John-Nagle/Overbot/gc/parts/braking/Pictures/Hardware/assembly4.jpg

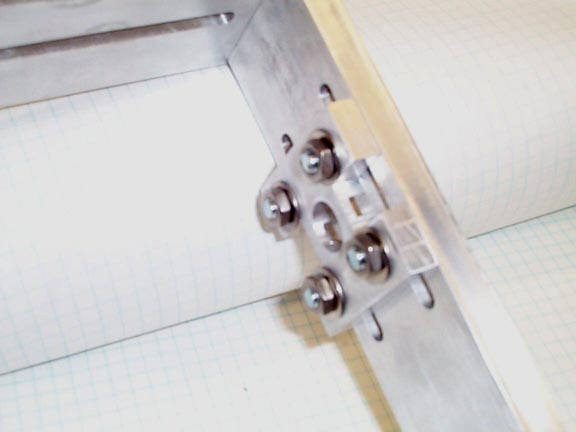
gc/parts/braking/Pictures/Hardware/assembly4.jpg
