John-Nagle/Overbot/gc/parts/braking/Pictures/Mounted/mounted07.jpg

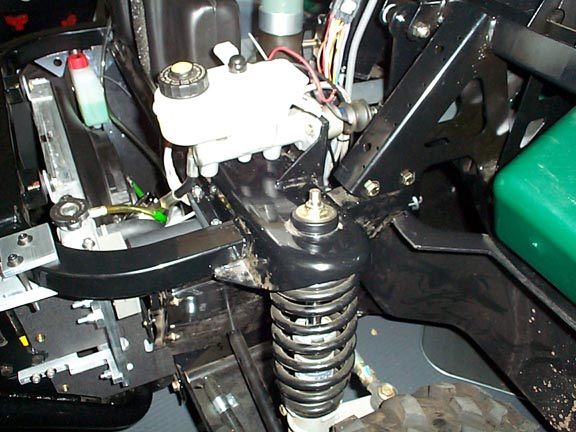
gc/parts/braking/Pictures/Mounted/mounted07.jpg
