John-Nagle/Overbot/README.md

# Overbot
Team Overbot source code from the 2005 Grand Challenge

The code that ran the Team Overbot off-road autonomous vehicle in the 2005 DARPA Grand Challenge.

Of historical interest only at this late date.
