John-Nagle/Overbot/gc/src/qnx/drivers/dummylms/README.txt

Dummy LIDAR server

Simulates a SICK LMS 221 

Teeam Overbot
J. Nagle
April, 2004
