John-Nagle/Overbot/gc/src/qnx/drivers/simplesonar/README.txt

Very simple SONAR server - reports obstacles in front or back of vehicle as faults.
