John-Nagle/Overbot/gc/src/qnx/nav/map/README.txt

The map/steering server

This is the program that does almost all the work of driving the Overbot.
