John-Nagle/Overbot/gc/doc/nav/moveserver.pdf

For participants only. Not for public distribution.

## Note #41 Move Server Design Specification

Achut Reddy
Last revise

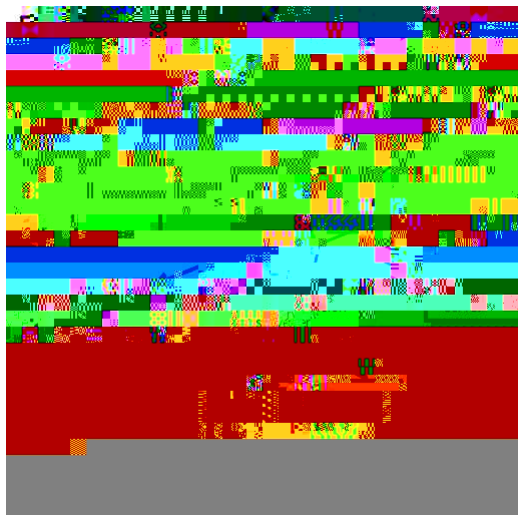
[picture p3: figure]

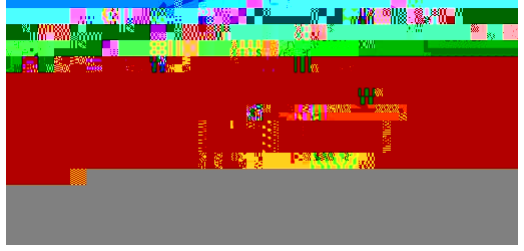
[picture p4: figure]

FIGURE 1 - Move server block diagram

Receive Thread

This thread simply loops waiting for command messages. When a command is received, it sim

The Move server does not issue commands to the Brake and Th | n
