John-Nagle/Overbot/gc/parts/power/powerboxpinout.xls

Team Overbot
Cable/Connector description
By: | J. Nagle
Date: | 2004-02-11
Unit name | Connector | Pin# | Pin description | Wire color | Remarks
Power box
 | Terminal block
 |  | Low voltage section
 |  | 1 | +12 VDC A | BLACK | To computer box
 |  | 2 | -12 VDC A | RED | To computer box
 |  | 3 | +12 VDC B | BLACK | To hood area
 |  | 4 | -12 VDC B | RED | To hood area
 |  | 5 | +24 VDC A | BLACK | To hood area
 |  | 6 | -24 VDC A | RED | To hood area
 |  | 7 | +24 VDC B | BLACK | To hood area
 |  | 8 | -24 VDC B | RED | To hood area
 |  | -------
 |  | 120 VAC unswitched section
 |  | 9 | NEUTRAL | BLACK | 9-10-11 tied together
 |  | 10 | NEUTRAL | BLACK
 |  | 11 | NEUTRAL | BLACK
 |  | 12 | 120 VAC | RED | 12-13-14 tied together
 |  | 13 | 120 VAC | RED
 |  | 14 | 120 VAC | RED
 |  | 15 | GND | GREEN | 15-16-17 tied together
 |  | 16 | GND | GREEN
 |  | 17 | GND | GREEN
 |  | -----
 |  | 120 VAC to 12V supplies |  |  | CHECK VOLTAGE
 |  | 18 |  | BLACK
 |  | 19 |  | RED
 |  | 20 |  | GREEN
 |  | -----
 |  | 120VAC to 24VDC supplies
 |  | 21 |  | BLACK
 |  | 22 |  | RED
 |  | 23 |  | GREEN | 23-24 tied together
 |  | 24 |  | GREEN
 |  | 25 |  | RED | 25-26-26 tied together
 |  | 26 |  | RED | To CB ???
 |  | 27 |  | RED | To CB ???
 |  | -----
 |  | 120VAC to computers – unswitched
 |  | 28 |  | BLACK
 |  | 29 |  | RED
 |  | 30 |  | GREEN
 | SW1 – SPDT momentary |  |  |  | Generator start/stop
 |  |  |  |  | NOT CURRENTLY CONNECTED
 | SW2 – DPDT |  |  |  | 120VAC to computers
 |  |  |  |  | NOT CURRENTLY CONNECTED
 | SW2 – SPDT momentary | DPDT |  |  | 12VDC supplies
 | SW3 – DPDT |  |  |  | 24VDC supplies
 | PL1 – 120VAC receptacle |  |  |  | Utility outlet
 |  |  |  |  | NOT CURRENTLY CONNECTED
 | Computer box connector – AMP 9-pin female |  |  |  | UNDER CONTSTRUCTION
 |  | 1 | AC GND |  | GREEN
 |  | 2 | 120 VAC NEUTRAL |  | BLACK
 |  | 3 | 120 VAC AC HOT |  | RED
 |  | 7 | 12VDC GND |  | BLACK
 |  | 8 | +12 VDC |  | RED
