John-Nagle/Overbot/gc/parts/templates/pinout.xls

Team Overbot
Cable/Connector description
By:
Date:
Unit name | Connector | Connector type | Pin number | Pin name | Pin description | Wire color | Remarks
LED Sign
 | Serial | RJ-11, female
 |  |  | Standard serial |  |  |  | 9600 baud
 | Power | 6mm coax power
 |  |  | Shell | GND
 |  |  | Pin number | PWR |  |  | 7.5V, 3A
