John-Nagle/Overbot/gc/parts/throttle/eserpinouts.xls

Pinouts For Throttle, RPM sensor, Dicky John
Questions? E-mail eser@cs.stanford.edu
Sensor Port Pin-Outs:
Pin# | Color | Function
1 | black | driveshaft sensor GND
2 | red | driveshaft sensor VCC
3 | white | driveshaft sensor Channel A
4 | green | driveshaft sensor Channel B
5 | shield | driveshaft sensor cable shield
6 | black | dicky john GND
7 | red | dicky john +12 VDC
8 | green | dicky john signal out 0-12VDC
9 | brown | RPM sensor +V
10 | black | RPM SIG
11 | blue | RPM COM
Throttle Power/E-Stop Cable: |  | REMOVED – obsolete with Galil
Pin# | Color | Function
1 | red (wire#1) | +24V
2 | black (wire#1) | -24V
3 | shield(wire#1) | shield
4 | gray (wire#1) | NC
5 | red (wire#1) | solenoid
6 | black(red) | solenoid
7 | DIO green signal | DIO signal
8 | DIO GND black-green | DIO GND
9 | white | NC
10 | black-white | NC
11 | shield(wire#1) | shield
Power Cable Pin-Out:
Pin# | Color | Function
1 | Red-Brown | VCC
2 | black-blue | GND
Sensor Port Pin-Outs (user-side):
Pin# | Color | Function
1 | black | driveshaft sensor GND
2 | red | driveshaft sensor VCC
3 | white | driveshaft sensor Channel A
4 | green | driveshaft sensor Channel B
5 | blue | driveshaft sensor cable shield
6 | orange | dicky john GND
7 | red-white | dicky john +12 VDC
8 | green-white | dicky john signal out 0-12VDC
9 | red-black | RPM sensor +V
10 | blue-white | RPM SIG
11 | black-white | RPM COM
Thorttle Box Pin-Out: |  | REMOVED – obsolete with Galil
Pin# | Color | Function
1 | orange | solenoid
2 | green | solenoid
3 | red | servo VCC
4 | black | servo GND
5 | white | Forward limit switch
6 | blue | center limit switch
7 | orange-black | back limit switch
8 | blue-black | encoder Channel B
9 | red-black | encoder VCC
10 | white-black | encoder Channel A
11 | green-black | Encoder Channel I
12 | black-white | encoder GND
13 | shield | shield
14
Throttle SerialCable: |  | REMOVED – obsolete with Galil
Pin# | Color (Device side) | Color (user side) | Function
1 | green | white | RxD/RS485-
2 | black-green | black | TxD/RS485+
3 | red | red | NC
4 | black-red | - | NC
5 | white | - | NC
6 | black-white | - | NC
7 | shield | shield | GND
MVP's: |  | REMOVED – obsolete with Galil
Pin# |  | Function
1 |  | Estop #6
2 |  | Estop #5
3 |  | MVP Phase A (J6)
4 |  | MVP Phase B (J6)
5 |  | MVP J2 Pin #8 (external event #1)
6 |  | MVP J2 Pin #16 (GND)
7 |  | MVP J2 Pin #7 (external event #2)
8-12 |  | J3 (encoder)
