John-Nagle/Overbot/gc/data/ahrsproblems/hdgshopgpsins.bmp

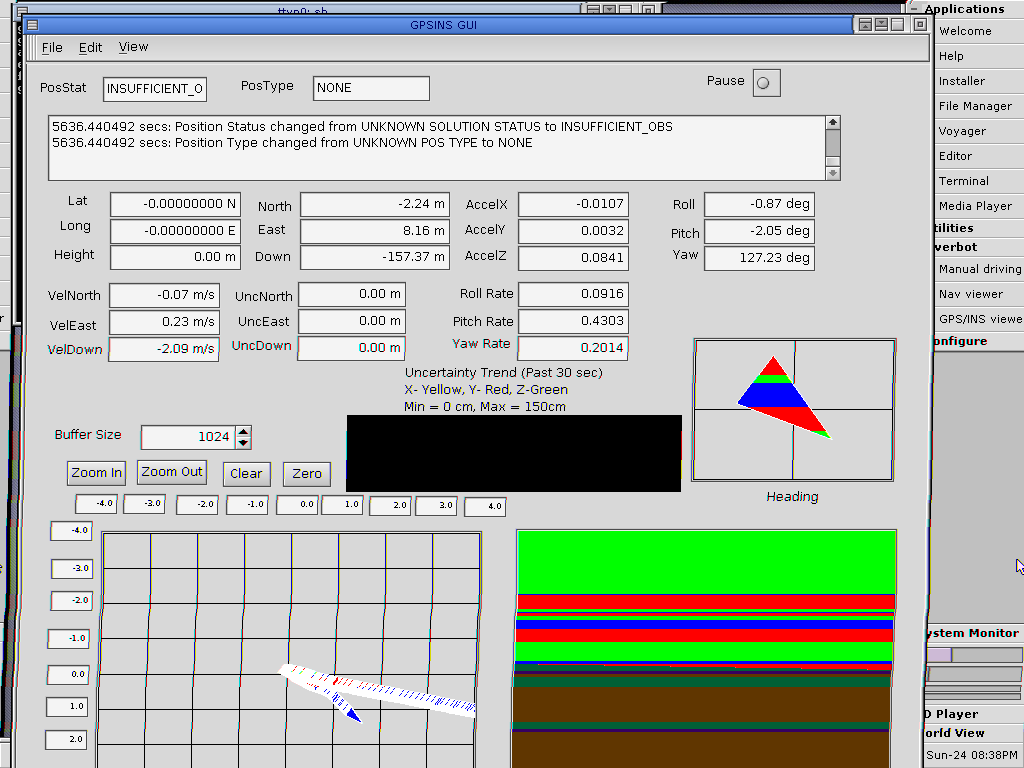
gc/data/ahrsproblems/hdgshopgpsins.bmp
