John-Nagle/Overbot/gc/data/ahrsproblems/hdgshopgyroview.bmp

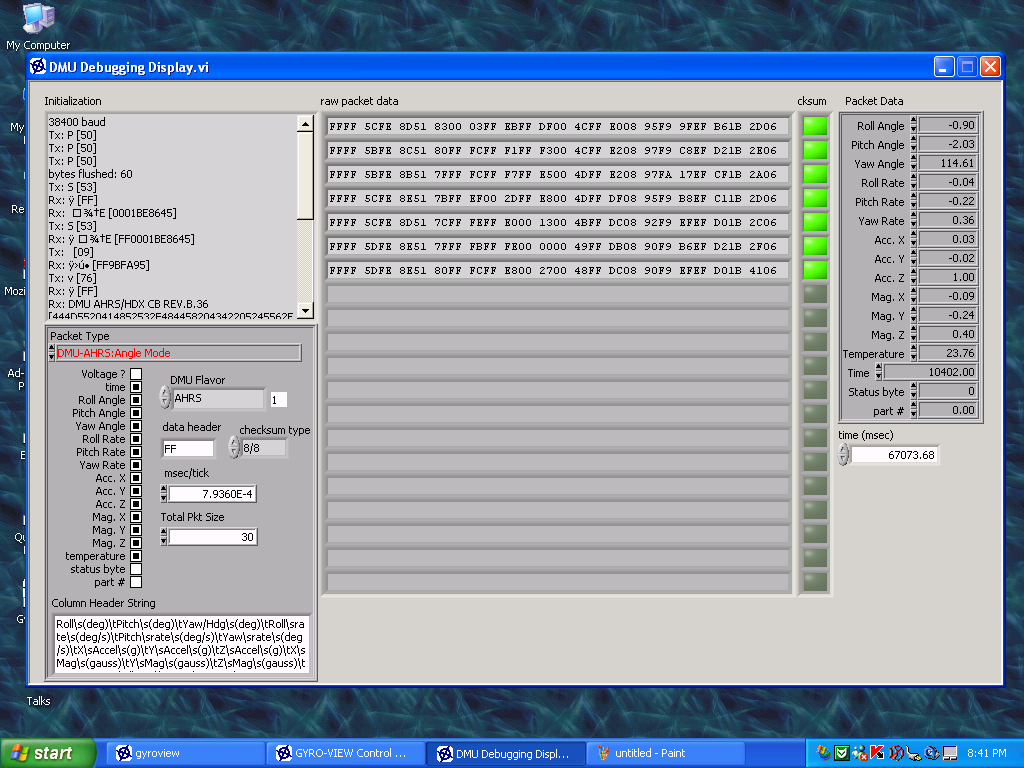
gc/data/ahrsproblems/hdgshopgyroview.bmp
