John-Nagle/Overbot/gc/data/redwoodjunction/redwoodjunctionsmallyard.jpg

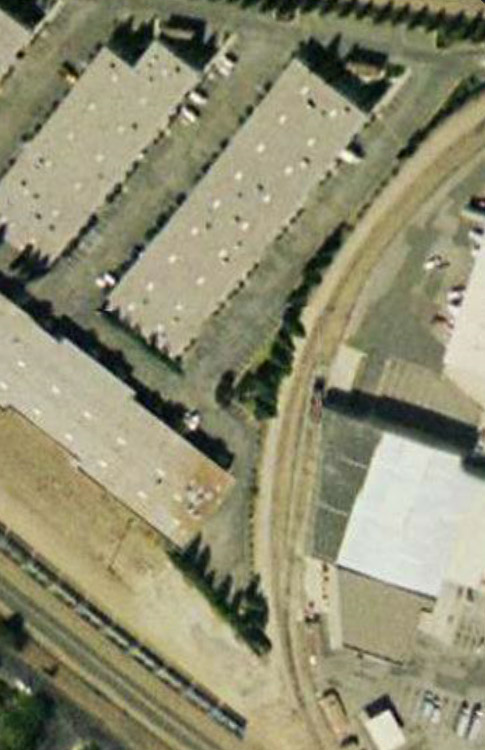
gc/data/redwoodjunction/redwoodjunctionsmallyard.jpg
