John-Nagle/Overbot/gc/doc/nav/lidarstabilization1.gif

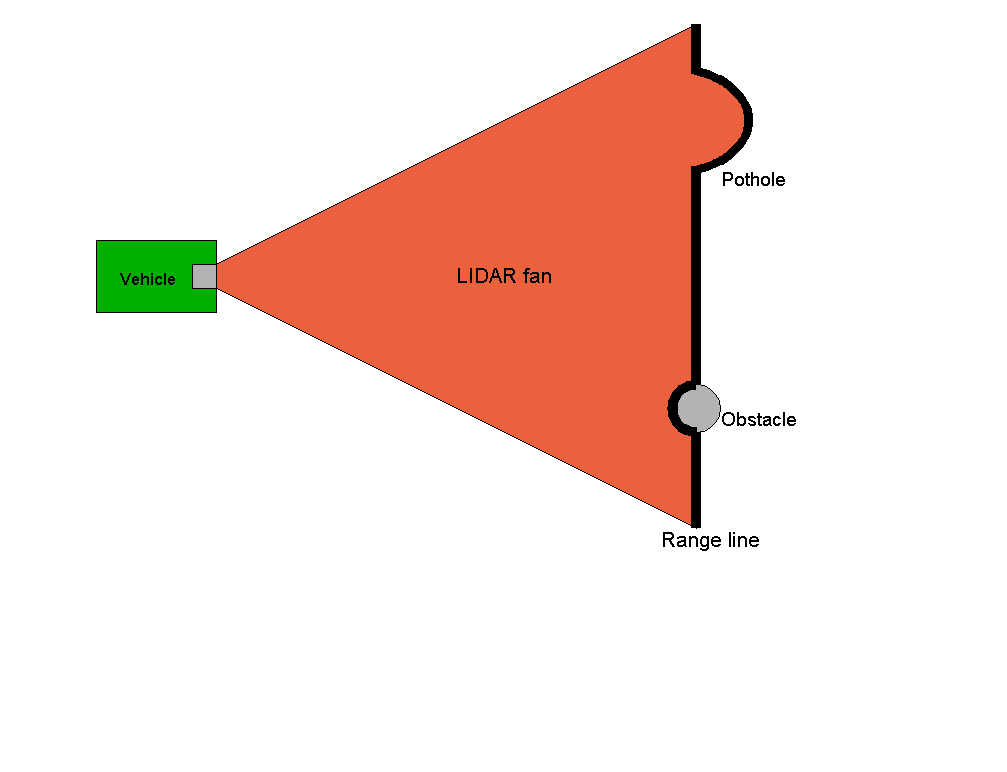
gc/doc/nav/lidarstabilization1.gif
