John-Nagle/Overbot/gc/doc/nav/lidarstabilizationgeom.gif

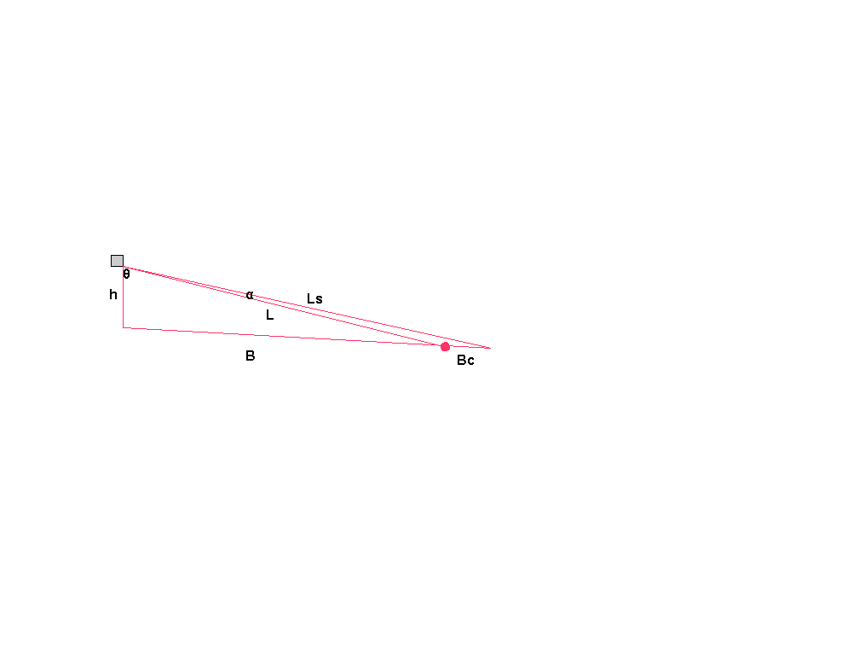
gc/doc/nav/lidarstabilizationgeom.gif
