John-Nagle/Overbot/gc/doc/nav/newsteerdesign.gif

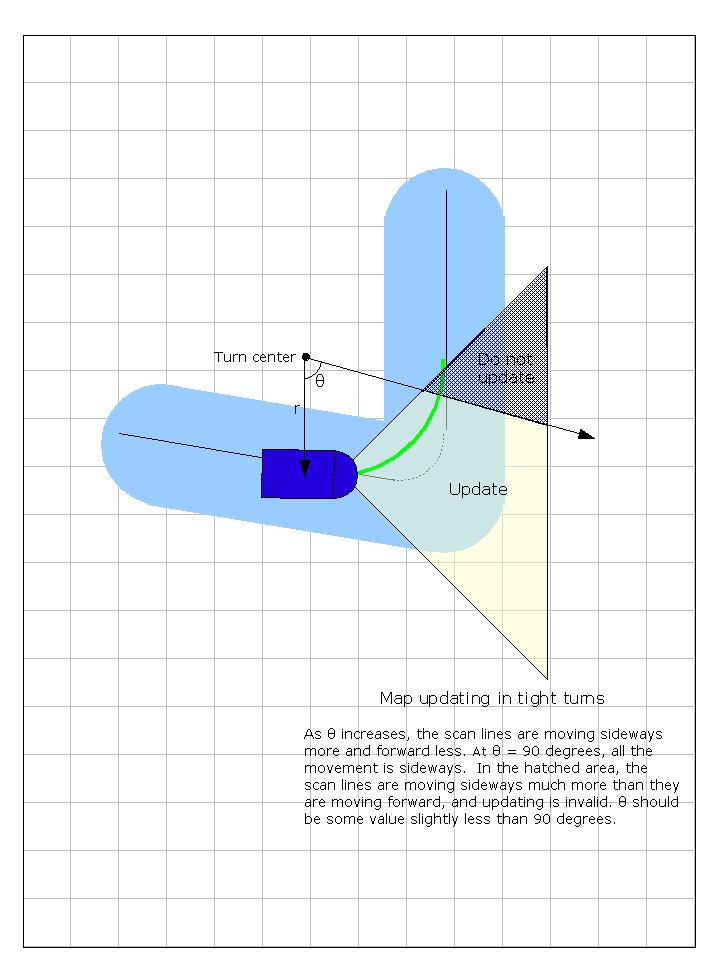
gc/doc/nav/newsteerdesign.gif
