John-Nagle/Overbot/gc/doc/nav/novatelserialnumberplate.jpg

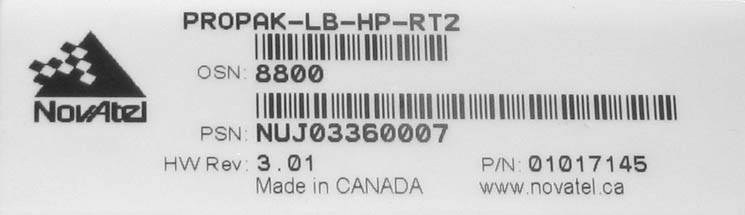
gc/doc/nav/novatelserialnumberplate.jpg
