John-Nagle/Overbot/gc/doc/presentations/cmugimbal.jpg

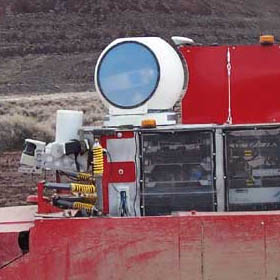
gc/doc/presentations/cmugimbal.jpg
