John-Nagle/Overbot/gc/parts/braking/Pictures/Hardware/Bracket_Cap.jpg

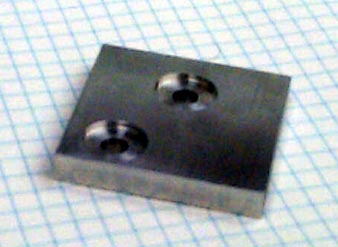
gc/parts/braking/Pictures/Hardware/Bracket_Cap.jpg
