John-Nagle/Overbot/gc/parts/braking/Pictures/Hardware/Bracket_Main.jpg

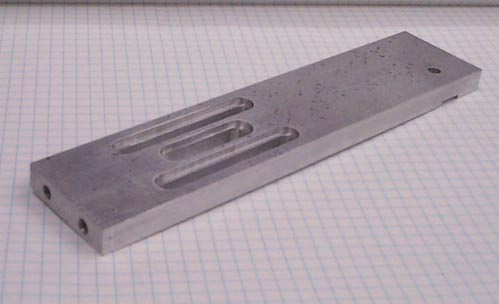
gc/parts/braking/Pictures/Hardware/Bracket_Main.jpg
