John-Nagle/Overbot/gc/parts/braking/Pictures/Hardware/Bracket_Slide.jpg

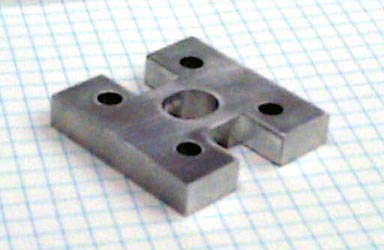
gc/parts/braking/Pictures/Hardware/Bracket_Slide.jpg
