John-Nagle/Overbot/gc/parts/braking/Pictures/Hardware/Bracket_Support.jpg

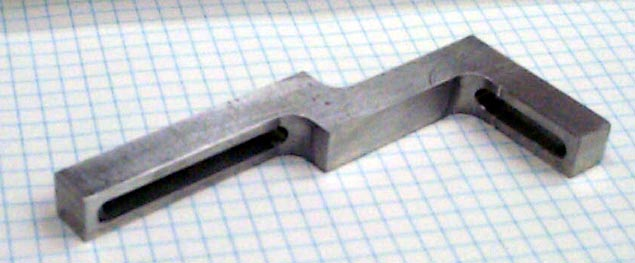
gc/parts/braking/Pictures/Hardware/Bracket_Support.jpg
