John-Nagle/Overbot/gc/parts/braking/Pictures/Hardware/Bracket_Top.jpg

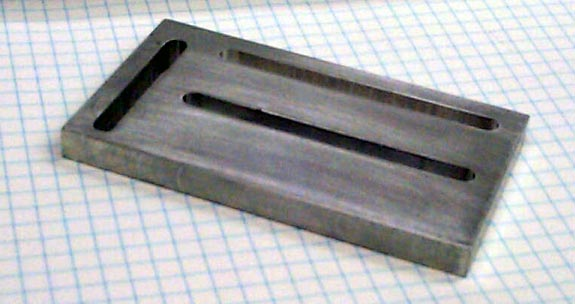
gc/parts/braking/Pictures/Hardware/Bracket_Top.jpg
