John-Nagle/Overbot/gc/src/qnx/common/doc/opencv/ref/pics/left.jpg

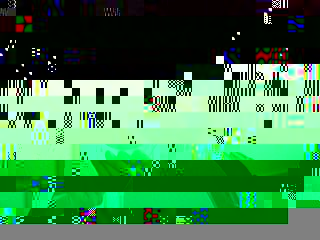
gc/src/qnx/common/doc/opencv/ref/pics/left.jpg
