John-Nagle/Overbot/gc/src/qnx/common/doc/opencv/ref/pics/right.jpg

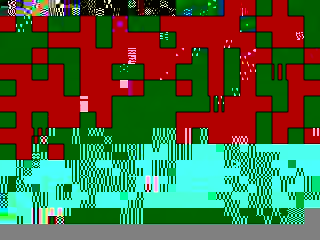
gc/src/qnx/common/doc/opencv/ref/pics/right.jpg
