John-Nagle/Overbot/gc/system/milestones/lowlevelclientserver.tif

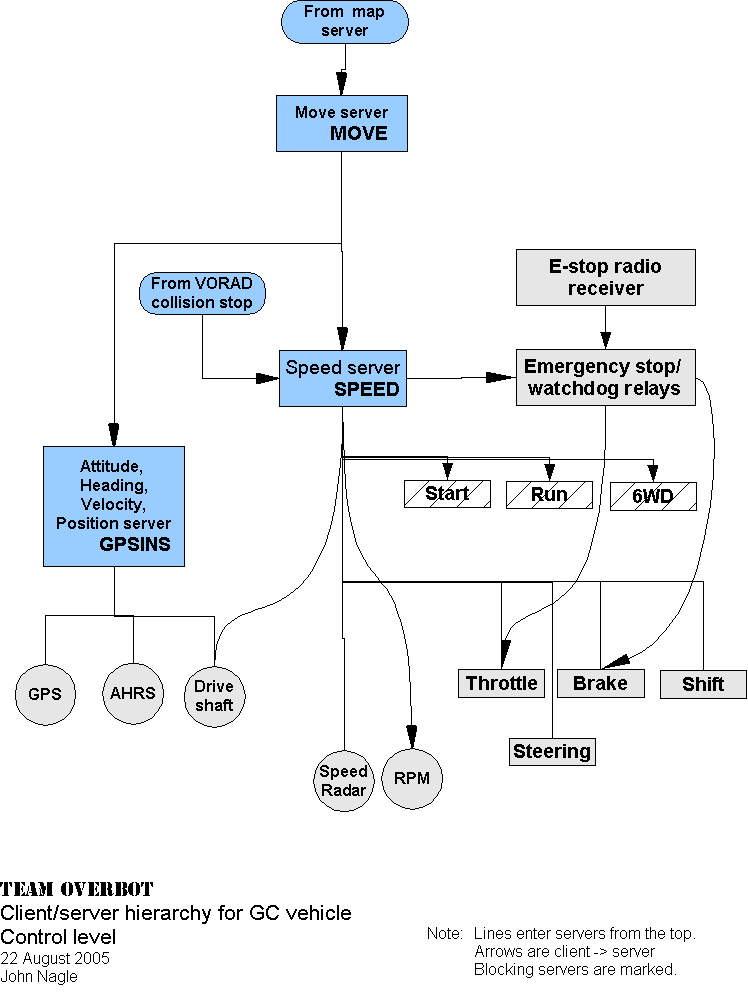
gc/system/milestones/lowlevelclientserver.tif
