John-Nagle/Overbot/gc/system/milestones/sensorsclientserver.tif

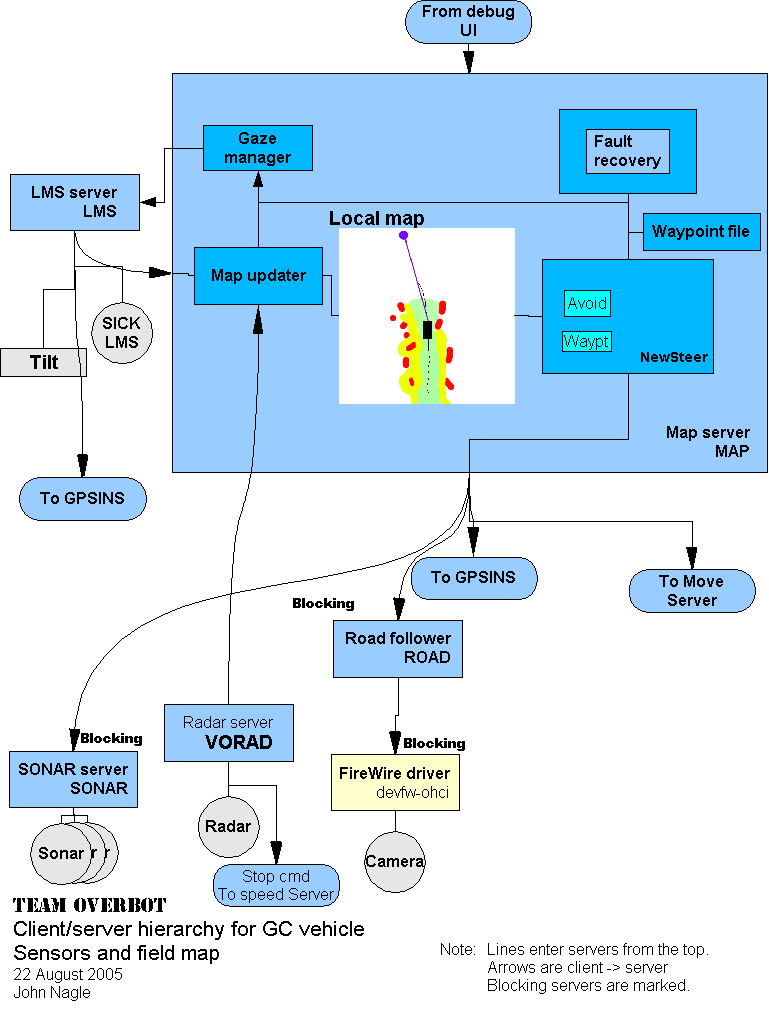
gc/system/milestones/sensorsclientserver.tif
