John-Nagle/Overbot/gc/system/boms/bom.xls

Sheet: master
Team Overbot
Vehicle Bill Of Materials (BOM)
Resp | Subsys |  | Item Name | Vendor and Model Number | In House? |  | Type | Electronic Interface | AI | AO | DI | CT | DO | R | Q | S | NA | 1 | Power | Location | Water
 | Chassis
 | Base Vehicle
John N |  |  | Vehicle, Off-Road | Polaris Ranger 6x6 2003 | yes
 |  |  | Add-On, Standard, Brush Guard, Front | Polaris Ranger Front Brush Guard | yes
Nagle |  |  | Add-On, Custom, Sponsor Decals | Kinko's | yes |  | Aluminum signs
Celia |  |  | Modification, Steering Shaft, Upper | Polaris Ranger Upper Steering Shaft | yes
Celia |  |  | Modification, Steering Shaft, Lower | Polaris Ranger Lower Steering Shaft | yes
 |  |  | Modification, Tire, Right, Front, Foam Filler |  | cancel
 |  |  | Modification, Tire, Right, Middle, Foam Filler |  | cancel
 |  |  | Modification, Tire, Right, Rear, Foam Filler |  | cancel
 |  |  | Modification, Tire, Left, Front, Foam Filler |  | cancel
 |  |  | Modification, Tire, Left, Middle, Foam Filler |  | cancel
 |  |  | Modification, Tire, Left, Rear, Foam Filler |  | cancel
 | Vehicle Actuation
 |  | Steering Shaft
Celia |  |  | Sensor, Potentiometer, Steering Shaft | Duncan Technologies Steering Position Sensor | yes | S | Angular Pot? | Analog In | 1 | 0 | 0 | 0 | 0 | 0 | 0 | 0 | 0 | 1
Celia |  |  | Cable, Steering Shaft, Pot to Controller |  | no
Vic |  |  | Hardware, Mounting, Potentiometer, Steering Shaft |  | yes
Celia |  |  | Sensor, Encoder, Steering Shaft | Faulhaber HEDS 5540 AM | yes | S | Inc Encoder | Quadrature | 0 | 0 | 0 | 0 | 0 | 0 | 1 | 0 | 0 | 1
 |  |  | Connector, cable to Encoder | FCI 86498-000 | no |  | Header conn w/latch
Celia |  |  | Cable, Steering Shaft, Encoder to Controller |  | no
Celia |  |  | Actuator, Motor, Steering Shaft | Maxon Motor F 2260-881-51.216.200 | yes | A | DC Brush | Analog Out | 0 | 1 | 0 | 0 | 0 | 0 | 0 | 0 | 0 | 1
Celia |  |  | Cable, Steering Shaft, Motor to Controller |  | no
Celia |  |  | Gearhead, Steering Shaft | Maxon Motor GP 62 | yes
Celia |  |  | Coupler, Motor to Steering Shaft |  | yes
Celia |  |  | Hardware, Mounting, Motor, Steering Shaft | Custom | yes
Celia |  |  | Motion Controller, Steering Shaft | Galil DMC-1416 | yes
Celia |  |  | Cable, Steering Shaft, Controller to Ethernet hub | Fry's | yes
Celia |  |  | Cable, Steering Shaft, Controller to Generator
Celia |  |  | Hardware, Mounting, Motion Controller, Steering Shaft
 |  | Throttle
Eser |  |  | Sensor, Encoder, Throttle |  | yes | S | Inc Encoder | Quadrature | 0 | 0 | 0 | 0 | 0 | 0 | 1 | 0 | 0 | 1
Eser |  |  | Cable, Throttle, Encoder to Controller |  | yes
Eser |  |  | Sensor, Tachometer, Engine Speed | Monarch Instrument 6180-019 | yes | S | Tachometer | DI Counter/Timer | 0 | 0 | 0 | 1 | 0 | 0 | 0 | 0 | 0 | 1
Eser |  |  | Cable, Engine Speed, Tachometer to Freq. Conv |  | no
Eser |  |  | Coupler, Tachometer to Engine |  | yes
Eser |  |  | Hardware, Mounting, Engine Speed, Tachometer |  | yes
 |  |  | Sensor, Encoder, Driveshaft Split Gear | Red Lion 0920750 | yes
Eser |  |  | Sensor, Encoder, Driveshaft Speed (slow/dir) | Sensor Solutions S18-37ADQ-RESA10-10 | yes | S | Inc Encoder | Quadrature | 0 | 0 | 0 | 0 | 0 | 0 | 1 | 0 | 0 | 1
Eser |  |  | Cable, Driveshaft Speed, Encoder to Controller |  | yes
Eser |  |  | Coupler, Encoder to Driveshaft |  | yes
John N |  |  | Sensor, Radar, Vehicle Speed | Dickey-John | yes | S | Doppler Radar | DI Counter/Timer | 0 | 0 | 0 | 1 | 0 | 0 | 0 | 0 | 0 | 1
John N |  |  | Cable, Vehicle Speed, Radar to Freq. Conv |  | yes
John N |  |  | Hardware, Mounting, Radar, Vehicle Speed |  | yes
Eser |  |  | Sensor, Temperature, Water | Use existing water temp switch? | no | S | Temp Sensor | Analog In | 1 | 0 | 0 | 0 | 0 | 0 | 0 | 0 | 0 | 1
Eser |  |  | Cable, Water Temperature to Controller | Need branch from existing wiring. | no
Eser |  |  | Hardware, Mounting, Temperature, Water
Eser |  |  | Actuator, Motor, Throttle | Faulhaber 2342S024CR+HEDS5540I06+X0703A | yes | A | DC Brush | Analog Out | 0 | 1 | 0 | 0 | 0 | 0 | 0 | 0 | 0 | 1
Eser |  |  | Cable, Throttle, Motor to Controller |  | no
Eser |  |  | Gearhead, Throttle | necessary? | yes
Eser |  |  | Hardware, Mounting, Motor, Throttle |  | yes
Eser |  |  | Motion Controller, Throttle | Galil DMC-1416 | yes
Nagle |  |  | Connector, motor and power to motion controller | Phoenix MSTB 2.5 ???
Eser |  |  | Cable, Throttle, Controller to Ethernet hub | Fry's | yes
Eser |  |  | Cable, Throttle, Controller to Engine |  | yes
Eser |  |  | Hardware, Mounting, Motion Controller, Throttle |  | yes
 |  | Brake
Peter |  |  | Sensor, Pressure, Brake | SenZors PT1H, 2000 PSI, 0..5V out | yes | S | Pressure Sensor | Analog In | 1 | 0 | 0 | 0 | 0 | 0 | 0 | 0 | 0 | 1
Peter |  |  | Cable, Brake, Pressure to Controller
Peter |  |  | Sensor, Encoder, Brake |  | yes | S | Encoder | Quadrature
Peter |  |  | Cable, Brake, Encoder to Controller
Peter |  |  | Actuator, Linear, Brake | Ultramotion “Bug”, high-power | yes | A | Linear Actuator | Analog Out | 0 | 1 | 0 | 0 | 0 | 0 | 0 | 0 | 0 | 1
Peter |  |  | Cable, Brake, Linear Actuator to Controller |  | yes
Peter |  |  | Coupler, Brake, Linear Actuator to Master Cylinder |  | yes
Peter |  |  | Hardware, Mounting, Actuator, Linear, Brake |  | yes
Peter |  |  | Motion Controller, Brake | Galil DMC-1416 | yes
Peter |  |  | Cable, Brake, Controller to network | 100baseT | yes
Peter |  |  | Cable, Brake, Controller to Generator |  | yes
Peter |  |  | Hardware, Mounting, Motion Controller, Brake |  | yes
 |  | Transmission (need manual neutral=>brake off)
Chris/Sam |  |  | Sensor, Potentiometer, Transmission |  |  | S | Linear Pot? | Analog In | 1 | 0 | 0 | 0 | 0 | 0 | 0 | 0 | 0 | 1
Chris/Sam |  |  | Cable, Transmission, Pot to Controller
Chris/Sam |  |  | Sensor, Encoder, Transmission |  |  | S | Inc Encoder | Quadrature
Chris/Sam |  |  | Cable, Transmission, Encoder to Controller
Chris/Sam |  |  | Actuator, Linear, Transmission |  |  | A | Linear Actuator? | Analog Out | 0 | 1 | 0 | 0 | 0 | 0 | 0 | 0 | 0 | 1
Chris/Sam |  |  | Cable, Transmission, Linear Actuator to Controller
Chris/Sam |  |  | Coupler, Transmision, Linear Actuator to Lever
Chris/Sam |  |  | Hardware, Mounting, Actuator, Linear, Transmission
Chris/Sam |  |  | Motion Controller, Transmission | Galil DMC-1416 | yes
Chris/Sam |  |  | Cable, Transmission, Controller to network | 100baseT
Chris/Sam |  |  | Cable, Transmission, Controller to Generator
Chris/Sam |  |  | Hardware, Mounting, Motion Controller, Transmission
 |  | Choke
Eser |  |  | Actuator, Solenoid, Choke |  |  | A | Solenoid | Relay | 0 | 0 | 0 | 0 | 0 | 1 | 0 | 0 | 0 | 1
Eser |  |  | Cable, Choke, Solenoid to PC104
Eser |  |  | Coupler, Choke, Solenoid to Lever
Eser |  |  | Hardware, Mounting, Solenoid, Choke
 |  | AWD
Eser |  |  | Relay, AWD |  |  | A | Relay | Relay | 0 | 0 | 0 | 0 | 0 | 1 | 0 | 0 | 0 | 1
Eser |  |  | Cable, AWD, Relay to PC104
Eser |  |  | Hardware, Mounting, Relay, AWD
 |  | Engine Start
Eser |  |  | Relay, Ignition |  |  | A | Relay | Relay | 0 | 0 | 0 | 0 | 0 | 1 | 0 | 0 | 0 | 1
Eser |  |  | Cable, Ignition, Relay to PC104
Eser |  |  | Hardware, Mounting, Relay, Ignition
Eser |  |  | Relay, Starter |  |  | A | Relay | Relay | 0 | 0 | 0 | 0 | 0 | 1 | 0 | 0 | 0 | 1
Eser |  |  | Cable, Starter, Relay to PC104
Eser |  |  | Hardware, Mounting, Relay, Starter
 | Safety/E-Stop
 |  | Lights
 |  |  | Relay, Warning Lights |  |  | A | Relay | Relay | 0 | 0 | 0 | 0 | 0 | 1 | 0 | 0 | 0 | 1
 |  |  | Cable, Warning Lights, Relay to Right
 |  |  | Cable, Warning Lights, Relay to PC104
 |  |  | Hardware, Mounting, Relay, Warning Lights
 |  |  | Light, Warning, Right |  | yes
 |  |  | Hardware, Mounting, Warning, Right
 |  |  | Light, Warning, Left |  | yes
 |  |  | Hardware, Mounting, Warning, Left
 |  |  | Cable, Warning Lights, Right to Left
 |  |  | Relay, Brake Lights |  |  | A | Relay | Relay | 0 | 0 | 0 | 0 | 0 | 1 | 0 | 0 | 0 | 1
 |  |  | Cable, Brake Lights, Relay to Lights
 |  |  | Cable, Brake Lights, Relay to PC104
 |  |  | Hardware, Mounting, Relay, Brake Lights
 |  | Audible Signal |  | Merged Top Unit
 |  |  | Relay, Horn |  |  | A | Relay | Relay | 0 | 0 | 0 | 0 | 0 | 1 | 0 | 0 | 0 | 1
 |  |  | Cable, Horn, Relay to Horn
 |  |  | Cable, Horn, Relay to PC104
 |  |  | Hardware, Mounting, Relay, Horn
 |  |  | Horn
 |  |  | Hardware, Mounting, Horn
 |  | Brakes Engaged
Peter |  |  | Sensor, Switch, Brakes Engaged |  |  | A | Switch | Switch | 0 | 0 | 0 | 0 | 0 | 0 | 0 | 0 | 1 | 1
Peter |  |  | Cable, Brakes Engaged, Switch to Relay
Peter |  |  | Relay, Brakes Engaged, Power Off
Peter |  |  | Cable, Brakes Engaged, Relay to Controller
Peter |  |  | Battery, Brakes Engaged
Peter |  |  | Cable, Brakes Engaged, Battery to Switch
 |  | E-Stop Command
 |  |  | Freeze Input |  |  | S | Switch/Wi-Receiver | Digital In | 0 | 0 | 1 | 0 | 0 | 0 | 0 | 0 | 0 | 1
 |  |  | Kill Input |  |  | S | Switch/Wi-Receiver | Digital In | 0 | 0 | 1 | 0 | 0 | 0 | 0 | 0 | 0 | 1
 |  |  | E-Stop Output Relay |  |  | A | Relay | Relay | 0 | 0 | 0 | 0 | 0 | 1 | 0 | 0 | 0 | 1
 |  |  | Radio E-stop unit, test
 |  |  | Radio E-stop unit, Government-provided
 |  |  | Emergency stop buttons | Allen-Bradley | yes
 |  | Chassis power control
 |  |  | Self-resetting circuit breakers | Waytek? | yes
 |  |  | Dashboard circuit breaker panel
 |  | Manual control panel
 |  |  | Panel | Front Panel Express?
 |  |  | Emergency stop button | Allen-Bradley | yes
 |  |  | Brake switch – RELEASE/NORMAL/APPLY | Telemechanique / Grainger? | yes
 |  |  | Mode switch – MANUAL/STANDBY/AUTO | Telemechanique / Grainger? | yes
 |  |  | Light – AUTO | Telemechanique / Grainger? | yes
 | Auxillary Power
 |  | Generator
Celia |  |  | Generator | Generac Impact 36G Plus II | yes
Celia |  |  | (all the plumbing) |  | yes
Celia |  |  | Hardware, Mounting, Generator |  | yes
 |  |  | (battery to assist generator start?) |  | yes
 |  |  | Generator auto-start control unit | (postponed, no time)
 |  |  | Power distribution/circuit breaker box |  | yes
 |  |  | Plug retention for power plugs |  | yes
 |  |  | Converter, 120VAC to 12/24VDC | Vicor? | yes
 |  | Auxillary Fuel Tank
Celia |  |  | Tank, Fuel, Auxillary | The Tech Group | yes
Celia |  |  | (all the pumbing) | The Tech Group | yes
Celia |  |  | Hardware, Mounting, Tank, Fuel, Auxillary | The Tech Group | yes
 | Debugging
 |  | Steering Wheel
Celia |  |  | Sensor, Potentiometer, Steering Wheel |  | yes | S | Angular Pot? | Analog In | 1 | 0 | 0 | 0 | 0 | 0 | 0 | 0 | 0 | 1
Celia |  |  | Cable, Steering Wheel, Pot to Controller |  | yes
Celia |  |  | Hardware, Mounting, Potentiometer, Steering Wheel |  | yes
 |  | Joystick
Celia |  |  | Joystick, USB
Celia |  |  | Computer, Laptop
Celia |  |  | Software, Operating System, QNX
Celia |  |  | Software, Custom, Joystick Control
Celia |  |  | Bridge, Wireless, Laptop
Celia |  |  | Cable, Ethernet, Laptop to Bridge
Celia |  |  | Bridge, Wireless, Router
 |  | Status
 |  |  | Display, LED, Status |  |  | A | Single Line Display | Serial <=115kB | 0 | 0 | 0 | 0 | 0 | 0 | 0 | 1 | 0 | 1
 |  |  | Cable, Status, LED to PC104 |  |  |  |  | totals | 5 | 4 | 2 | 2 | 0 | 8 | 3 | 1 | 1 | 26
 |  |  | Hardware, Mounting, LED, Status
 | Chassis Computer
Celia |  |  | PC104 Board, Power Supply
Celia |  |  | Cable, Power Supply to Generator
Celia |  |  | PC104 Board, CPU
Celia |  |  | DiskOnChip
Celia |  |  | Software, Operating System, QNX
All |  |  | Software, Custom, Chassis
Celia |  |  | Cable, Ethernet, Chassis to Hub
 |  |  | PC104 Board, Digital In/Out, Counter/Timer
 |  |  | PC104 Board, Relay
 |  |  | Cable, Relay to Generator
Celia |  |  | Enclosure, PC104
Celia |  |  | End Cap, Enclosure, PC104, Top
Celia |  |  | Gasket, Enclosure, PC104, Top
Celia |  |  | End Cap, Enclosure, PC104, Bottom
Celia |  |  | Gasket, Enclosure, PC104, Bottom
Celia |  |  | Hardware, Mounting, Enclosure, PC104, Chassis
 | Auxillary Sensors
 | Proximity Sensing
 |  |  | Sensor, Radar, Forward Obstacles |  |  | S | Eaton VORAD | Serial <= 115kB
 |  |  | Cable, Forward Obstacles, Radar to PC104
 |  |  | Hardware, Mounting, Radar, Forward Obstacles
 |  |  | Sonars 1..N INIT |  |  | A | Sonar Sensor | Digital Out | piezoelectric automotive type
 |  |  | Sonars 1..N ECHO |  |  | S | Sonar Sensor | Timer
 |  |  | Sonars 1..N INIT |  |  | A | Sonar Sensor | Digital Out
 |  |  | Sonars 1..N ECHO |  |  | S | Sonar Sensor | Timer
 |  |  | Sonars 1..N INIT |  |  | A | Sonar Sensor | Digital Out
 |  |  | Sonars 1..N ECHO |  |  | S | Sonar Sensor | Timer
 |  |  | Sonars 1..N INIT |  |  | A | Sonar Sensor | Digital Out
 |  |  | Sonars 1..N ECHO |  |  | S | Sonar Sensor | Timer
 |  |  | Sonars 1..N INIT |  |  | A | Sonar Sensor | Digital Out
 |  |  | Sonars 1..N ECHO |  |  | S | Sonar Sensor | Timer
 |  |  | Sonars 1..N INIT |  |  | A | Sonar Sensor | Digital Out
 |  |  | Sonars 1..N ECHO |  |  | S | Sonar Sensor | Timer
 |  |  | Sonars 1..N INIT |  |  | A | Sonar Sensor | Digital Out
 |  |  | Sonars 1..N ECHO |  |  | S | Sonar Sensor | Timer
 |  |  | Sonars 1..N INIT |  |  | A | Sonar Sensor | Digital Out
 |  |  | Sonars 1..N ECHO |  |  | S | Sonar Sensor | Timer
 |  |  | Bumper 1..2
 | Water Detection
 |  |  | Sensor, Level, Water |  |  | S | Pressure Transducer | Analog In
 |  |  | Cable, Water, Level to Controller
 |  |  | Hardware, Mounting, Level, Water
 | Auxillary E-Stop
 |  |  | Relay, E-Stop Output |  |  | A | Relay | Digital Out
 | Auxillary Sensors Computer
 | Top Unit
 | Terrain Mapping
 |  | Road Detection
 |  |  | Camera, Digital, Road Detection | Unibrain Fire-I 400 | yes
 |  |  | Lens, C-mount |  | Ordered
 |  |  | Cable, Road Detection, Camera to Bed Box |  |  |  | FireWire, locking
 |  |  | Cleaning device | CameraWash
 |  | Contour Mapping
 |  |  | Rangefinder, Laser | SICK LMS | yes
 |  |  | Cable, Rangefinder, Laser to PC | SICK LMS
 |  |  | Tilt Head, Rangefinder, Laser | Newmark Systems | yes
 |  |  | Mini INS (rate gyro) | BEI AQRS (deleted, using main INS)
 |  |  | Hardware, Mounting, Pan/Tilt Head, Rangefinder, Laser
 | Top Unit Electronics Box
 |  |  | Cabinet, Fibreglas, AM1086L (? check size) | Allied Moulded Products | no
 |  |  | Baseplate, aluminum, for above | Allied Moulded Products | no
 |  |  | Ethernet to serial converter | Sealevel Systems | yes
 |  |  | MicroMo MVP 2001 | MicroMo | yes
 |  |  | Solid-state relay, 12A |  | yes |  | Power for LMS
 |  |  | Solid-state relay, 12A |  | yes |  | Horn
 |  |  | Horn, 118dbA, 12VDC | Ademco | Ordered
 |  |  | Terminal blocks, connectors, etc. | Stock | yes
 |  |  | Shock mounts | Stock | yes
 | Top Unit Computer |  |  | (Deleted, replaced with gcrear2)
 |  |  | PC104 Board, Power Supply | Ampro | yes
 |  |  | Cable, Power Supply to Generator
 |  |  | PC104 Board, CPU | Ampro | yes
 |  |  | DiskOnChip | M-Systems | yes
 |  |  | Software, Operating System, QNX | QSSL | yes
 |  |  | Software, Custom, Top Unit
 |  |  | Cable, Ethernet, Top Unit to Router
 |  |  | PC104 Board, Serial, 500kBaud | Sealevel Systems | yes
 |  |  | Enclosure, PC104
 |  |  | End Cap, Enclosure, PC104, Top
 |  |  | Gasket, Enclosure, PC104, Top
 |  |  | End Cap, Enclosure, PC104, Bottom
 |  |  | Gasket, Enclosure, PC104, Bottom
 |  |  | Hardware, Mounting, Enclosure, PC104, Top Unit
 | Top unit roll cage
 |  |  | Roll cage | Ed Haas
 |  |  | Shock mounts |  | yes
 |  |  | Sunshade
 |  |  | GPS antenna | Part of GPS unit | yes
 | Bed Box
 | Cabinets
 |  | Computer/GPS equipment |  |  | yes
 |  | Power supplies for servo power |  |  | yes
 |  | DARPA equipment |  | Deleted, units are weathertight
 | Navigation
 |  | GPS |  | ProPack LBHP? | yes
 |  | INS |  | Crossbow AHRS 400CB-200 | yes
 | Computers |  |  | 2ea
 |  |  | Nova PC Pentium 4 256MB w/case, pwr supply | Tri-M | yes |  |  |  |  |  |  |  |  |  |  |  |  |  | 110VAC
 |  |  | Hard drive for Mini-ITX computer
 |  |  | CD drive for Mini-ITX computer
 |  |  | Shock mounts
 |  |  | Cables
 | Network
 |  |  | Network hub
Celia |  |  | Wireless LAN unit
 | Bed box cover
 |  |  | Cover |  | yes
 |  |  | Air intake for generator |  | yes
 |  |  | Air prefilter for generator |  | yes
 |  |  | Sheet metal heat shield for generator
 |  |  | Intake fan to provide positive pressure within bed box
 |  |  | Filter for intake fan
 |  |  | DARPA-provided GPS antenna | Part of DARPA-provided hardware | yes
 |  |  | DARPA-provided E-stop antenna | Part of DARPA-provided hardware | yes
 |  |  | Flashing yellow lights |  | yes
 |  |  | Decals
 | pitch
 | roll
 | magnetic compass
 | heading gyro
 | bumblebee units for drop offs x4?
 | firewire

Sheet: splitchassis
4 | Vehicle Actuation | Steering | Steering Shaft Angle | S | Angular Pot? | Analog In
8 | Throttle | Throttle | Throttle Angle | S | Pot? | Analog In
12 | Throttle | Throttle | Water Temperature | S | Temp Sensor | Analog In
15 | Vehicle Actuation | Braking | Brake Pressure | S | Pressure Sensor | Analog In
18 | Vehicle Actuation | Transmission | Transmission Position | S | Linear Pot? | Analog In
46 | Debugging | Steering Wheel | Steering Wheel Angle | S | Angular Pot? | Analog In
6 | Vehicle Actuation | Steering | Steering Shaft Actuator | A | DC Brush | Analog Out
13 | Throttle | Throttle | Throttle Actuator | A | DC Brush? | Analog Out
16 | Vehicle Actuation | Braking | Brake Actuator | A | Linear Actuator | Analog Out
19 | Vehicle Actuation | Transmission | Transmission Actuator | A | Linear Actuator? | Analog Out
9 | Throttle | Throttle | Engine Speed | S | Tachometer | DI Counter/Timer
11 | Throttle | Throttle | Vehicle Speed | S | Doppler Radar | DI Counter/Timer
35 | Safety/E-Stop | E-Stop Command | Freeze Input | S | Switch/Wi-Receiver | Digital In
36 | Safety/E-Stop | E-Stop Command | Kill Input | S | Switch/Wi-Receiver | Digital In
42 | Auxillary Power | Generator | Generator Running OK | S | ? | Digital In
43 | Auxillary Power | Generator | Generator Power OK | S | ? | Digital In
5 | Vehicle Actuation | Steering | Steering Shaft Ang Vel? | S | Inc Encoder | Quadrature
10 | Throttle | Throttle | Driveshaft Speed (slow/dir) | S | Inc Encoder | Quadrature
21 | Vehicle Actuation | AWD | 6WD Relay | A | Relay | Relay
23 | Engine Start | Engine Start | Ignition Relay | A | Relay | Relay
24 | Engine Start | Engine Start | Starter Relay | A | Relay | Relay
25 | Engine Start | Engine Start | Choke Actuator | A | Solenoid | Relay
28 | Safety/E-Stop | Lights | Warning Lights Relay | A | Relay | Relay
29 | Safety/E-Stop | Lights | Brake Lights Relay | A | Relay | Relay
31 | Safety/E-Stop | Audible Signal | Horn Relay | A | Relay | Relay
37 | Safety/E-Stop | E-Stop Command | E-Stop Output Relay | A | Relay | Relay
40 | Auxillary Power | Generator | Generator Start Relay | A | Relay | Relay
41 | Auxillary Power | Generator | Generator Run Relay | A | Relay | Relay
48 | Debugging | Status | LED Display | A | Single Line Display | Serial <=115kB
33 | Safety/E-Stop | Brakes Engaged | Brake Pressure Limit | A | Switch | Switch
1 | Chassis
2 | Vehicle Actuation
3 | Vehicle Actuation | Steering
7 | Vehicle Actuation | Throttle
14 | Vehicle Actuation | Braking
17 | Vehicle Actuation | Transmission
20 | Vehicle Actuation | AWD
22 | Engine Start | Engine Start
26 | Safety/E-Stop | Engine Start
27 | Safety/E-Stop | Lights
30 | Safety/E-Stop | Audible Signal
32 | Safety/E-Stop | Brakes Engaged
34 | Safety/E-Stop | E-Stop Command
38 | Auxillary Power | E-Stop Command
39 | Auxillary Power | Generator
44 | Debugging | Generator
45 | Debugging | Steering Wheel
47 | Debugging | Status
