John-Nagle/Overbot/gc/system/boms/dimensions.xls

Large equipment dimensions worksheet
The items here are not necessarily ones selected for the project.
Item | Vendor | Height | Width | Depth | Weight | Volts | Watts | Notes
Black Diamond GPS ctl | Novatel | 34.9mm | 279.4mm | 228.6mm | 3.38Kg | 11-25VDC | 15W
Commell LV-670M | BWI | 4in | 11in | 9in |  | 120VAC
