John-Nagle/Overbot/gc/parts/estop/secondversion/bom.xls

Sheet: BOM
Board BOM
U1 | WDT12D | Watchdog timer | Brentek | 1 |  | http://www.brentek.com/PDF_Files/WDT_Digital_Series.pdf
K1,K2,K3,K4,K6 | 551-EN2-1N1ST | Separate Relays | Mouser | 5 |  | http://www.worldproducts.com/pdfs/en2.pdf
K5 | 551-EN2-1N1S | H Bridge Relays | Mouser | 1 |  | http://www.mouser.com/index.cfm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
D1-14 | 1N4001GICT-ND | Tape of 100 general purpose diodes | Digikey | 14 | $3.20 | www.digikey.com
J2 | WM4210-ND | 12 pos. Waldom .100 header with lock | Digikey | 1 | $1.03 | http://dkc3.digikey.com/PDF/T043/0092.pdf
J1,J6 | WM4204-ND | 6 pos. Waldom .100 header with lock | Digikey | 2 | $0.60 | http://dkc3.digikey.com/PDF/T043/0092.pdf
J7 | WM4206-ND | 8 pos. Waldom .100 header with lock | Digikey | 1 | $0.78 | http://dkc3.digikey.com/PDF/T043/0092.pdf
J4 | WM4207-ND | 9 pos. Waldom .100 header with lock | Digikey | 1 | $0.87 | http://dkc3.digikey.com/PDF/T043/0092.pdf
J3,J5 | WM18445-ND | 5 Pos. Waldom Mini-Fit Jr. Vertical Header | Digikey | 2 | $1.86 | http://dkc3.digikey.com/PDF/T043/0108.pdf
 | WM1911-ND | Male Terminals, 16ga | Digikey | 7 | $0.34 | http://dkc3.digikey.com/PDF/T043/0108.pdf
D15 | 10CTQ150 | Shottky Dual-diode, TO220 pack. | Digikey | 1 | $2.93 | http://dkc3.digikey.com/PDF/T043/0674.pdf
R1,R2 |  | 1k Resistors, 0.25 W |  | 2
LED1/LED2 |  | Green LEDs |  | 2
CB1-CB2 | RHE650-ND | Polysilicon fuse | Digikey | 5 | $0.68 | http://dkc3.digikey.com/PDF/T043/1049.pdf
C1 |  | .1uF
C2 |  | 1000uF
C3 |  | 10uF
Board circuit schematic / layout drawing |  |  | Ref Drawings: EstopBoardRev2Nov04.pdf
 |  |  | Ref Drawings: EstopBoardRev2Nov04PCBfiles.zip
Internal Wiring BOM
J3,J5 | WM18436-ND | 5 Pos. Waldom Mini-Fit Jr. Single Row Receptacle | Digikey | 2 | $0.61 | http://dkc3.digikey.com/PDF/T043/0108.pdf
J3,J5 | WM1913-ND | Female Terminals, 16ga | Digikey | 7 | $0.34 | http://dkc3.digikey.com/PDF/T043/0108.pdf
 |  | Wire, 16ga, Red
 |  | Wire, 16ga, Blk
J7 | WM2010-ND | 12 pos. Waldom .100 Receptacle | Digikey | 1 | $0.85 | http://dkc3.digikey.com/PDF/T043/0092.pdf
J1,J13 | WM2004-ND | 6 pos. Waldom .100 Receptacle | Digikey | 2 | $0.48 | http://dkc3.digikey.com/PDF/T043/0092.pdf
J11 | WM2006-ND | 8 pos. Waldom .100 Receptacle | Digikey | 1 | $0.62 | http://dkc3.digikey.com/PDF/T043/0092.pdf
J9 | WM2007-ND | 9 pos. Waldom .100 Receptacle | Digikey | 1 | $0.67 | http://dkc3.digikey.com/PDF/T043/0092.pdf
J1,J7,J9,J11,J13 | WM200-ND | Crimp Terminals | Digikey | 37 | $5.34/100 | http://dkc3.digikey.com/PDF/T043/0092.pdf
 |  | Wire, 22ga, Red
 |  | Wire, 22ga, Yel
 |  | Wire, 22ga, Whi
 |  | Wire, 22ga, Blk
J6 | A25038 | Amp 4 position sealed std. Sex square-flange receptacle | Digikey | 1 | $5.90 | http://dkc3.digikey.com/PDF/T043/0229.pdf
J4,J14 | A1675-ND | Amp 4 position sealed rev. Sex square-flange receptacle | Digikey | 2 | $2.77 | http://dkc3.digikey.com/PDF/T043/0229.pdf
J2 | A1642-ND | Amp 9 position rev. Sex square-flange receptacle | Digikey | 1 | $3.08 | http://dkc3.digikey.com/PDF/T043/0231.pdf
J10,J12 | A1669-ND | Amp 9 position sealed std. Sex square-flange receptacle | Digikey | 2 | $2.77 | http://dkc3.digikey.com/PDF/T043/0231.pdf
J8 | A1677-ND | Amp 14 position sealed rev. Sex square-flange receptacle | Digikey | 1 | $2.83 | http://dkc3.digikey.com/PDF/T043/0231.pdf
J6,J10 | A25111-ND | Pin contacts, tin plated, 20-24ga, 0.06-0.120" OD | Digikey | 22 | $0.23 | http://dkc3.digikey.com/PDF/T043/0231.pdf
J4,J2,J14,J8 | A25007-ND | Socket contacts, tin plated, 20-24ga, 0.06-0.120" OD | Digikey | 26 | $0.36 | http://dkc3.digikey.com/PDF/T043/0231.pdf
Internal Wiring schematic |  |  | Ref Drawings: EstopBoardRev2InternalWiringNov04.pdf
Enclosure BOM
 | 377-1136-ND | Bud light gray polycarbonate sealed enclosure, 7.87x4.72x2.95 | Digikey | 1 | $23.40 | http://dkc3.digikey.com/PDF/T043/1220.pdf
Enclosure Fabrication Drawing |  |  | TBD
Assembly Drawing |  |  | TBD

Sheet: Digikey Order
Board BOM
U1 | WDT12D | Watchdog timer* | Brentek | 2 |  | http://www.brentek.com/PDF_Files/WDT_Digital_Series.pdf
K1,K2,K3,K4,K6 | 551-EN2-1N1ST | Separate Relays* | Mouser | 10 |  | http://www.worldproducts.com/pdfs/en2.pdf
K5 | 551-EN2-1N1S | H Bridge Relays* | Mouser | 3 |  | http://www.mouser.com/index.cfm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
D1-14 | 1N4001GICT-ND | Tape of 100 general purpose diodes* | Digikey | 100 | $3.20 | www.digikey.com
J2 | WM4210-ND | 12 pos. Waldom .100 header with lock | Digikey | 5 | $1.03 | http://dkc3.digikey.com/PDF/T043/0092.pdf
J1,J6 | WM4204-ND | 6 pos. Waldom .100 header with lock | Digikey | 10 | $0.60 | http://dkc3.digikey.com/PDF/T043/0092.pdf
J7 | WM4206-ND | 8 pos. Waldom .100 header with lock | Digikey | 5 | $0.78 | http://dkc3.digikey.com/PDF/T043/0092.pdf
J4 | WM4207-ND | 9 pos. Waldom .100 header with lock | Digikey | 5 | $0.87 | http://dkc3.digikey.com/PDF/T043/0092.pdf
J3,J5 | WM18445-ND | 5 Pos. Waldom Mini-Fit Jr. Vertical Header | Digikey | 10 | $1.86 | http://dkc3.digikey.com/PDF/T043/0108.pdf
 | WM1911-ND | Male Terminals, 16ga | Digikey | 25 | $0.34 | http://dkc3.digikey.com/PDF/T043/0108.pdf
D15 | 10CTQ150 | Shottky Dual-diode, TO220 pack.* | Digikey | 5 | $2.93 | http://dkc3.digikey.com/PDF/T043/0674.pdf
R1,R2 |  | 1k Resistors, 0.25 W* |  | ?
LED1/LED2 |  | Green LEDs* |  | ?
CB1-CB2 | RHE650-ND | Polysilicon fuse* | Digikey | 5 | $0.68 | http://dkc3.digikey.com/PDF/T043/1049.pdf
C1 |  | .1uF* |  | ?
C2 |  | 1000uF* |  | ?
C3 |  | 10uF* |  | ?
Board circuit schematic / layout drawing |  |  | Ref Drawings: EstopBoardRev2Nov04.pdf
 |  |  | Ref Drawings: EstopBoardRev2Nov04PCBfiles.zip
Internal Wiring BOM
J3,J5 | WM18436-ND | 5 Pos. Waldom Mini-Fit Jr. Single Row Receptacle | Digikey | 5 | $0.61 | http://dkc3.digikey.com/PDF/T043/0108.pdf
J3,J5 | WM1913-ND | Female Terminals, 16ga | Digikey | 25 | $0.34 | http://dkc3.digikey.com/PDF/T043/0108.pdf
 |  | Wire, 16ga, Red Stranded*
 |  | Wire, 16ga, Blk Stranded*
J7 | WM2010-ND | 12 pos. Waldom .100 Receptacle | Digikey | 5 | $0.85 | http://dkc3.digikey.com/PDF/T043/0092.pdf
J1,J13 | WM2004-ND | 6 pos. Waldom .100 Receptacle | Digikey | 10 | $0.48 | http://dkc3.digikey.com/PDF/T043/0092.pdf
J11 | WM2006-ND | 8 pos. Waldom .100 Receptacle | Digikey | 5 | $0.62 | http://dkc3.digikey.com/PDF/T043/0092.pdf
J9 | WM2007-ND | 9 pos. Waldom .100 Receptacle | Digikey | 5 | $0.67 | http://dkc3.digikey.com/PDF/T043/0092.pdf
J1,J7,J9,J11,J13 | WM2312-ND | Crimp Terminals (selective gold) | Digikey | 100 | $5.34/100 | http://dkc3.digikey.com/PDF/T043/0092.pdf
 |  | Wire, 22ga, Red Stranded*
 |  | Wire, 22ga, Yel Stranded*
 |  | Wire, 22ga, Whi Stranded*
 |  | Wire, 22ga, Blk Stranded*
J6 | A25038 | Amp 4 position sealed std. Sex square-flange receptacle | Digikey | 2 | $5.90 | http://dkc3.digikey.com/PDF/T043/0229.pdf
J4,J14 | A1675-ND | Amp 4 position sealed rev. Sex square-flange receptacle | Digikey | 4 | $2.77 | http://dkc3.digikey.com/PDF/T043/0229.pdf
J2 | A1642-ND | Amp 9 position rev. Sex square-flange receptacle | Digikey | 2 | $3.08 | http://dkc3.digikey.com/PDF/T043/0231.pdf
J10,J12 | A1669-ND | Amp 9 position sealed std. Sex square-flange receptacle | Digikey | 4 | $2.77 | http://dkc3.digikey.com/PDF/T043/0231.pdf
J8 | A1677-ND | Amp 14 position sealed rev. Sex square-flange receptacle | Digikey | 2 | $2.83 | http://dkc3.digikey.com/PDF/T043/0231.pdf
J6,J10 | A25111-ND | Pin contacts, tin plated, 20-24ga, 0.06-0.120" OD* | Digikey | 100 | $0.23 | http://dkc3.digikey.com/PDF/T043/0231.pdf
J4,J2,J14,J8 | A25007-ND | Socket contacts, tin plated, 20-24ga, 0.06-0.120" OD* | Digikey | 100 | $0.36 | http://dkc3.digikey.com/PDF/T043/0231.pdf
Internal Wiring schematic |  |  | Ref Drawings: EstopBoardRev2InternalWiringNov04.pdf
Enclosure BOM
 | 377-1136-ND | Bud light gray polycarbonate sealed enclosure, 7.87x4.72x2.95 | Digikey | 3 | $23.40 | http://dkc3.digikey.com/PDF/T043/1220.pdf
Enclosure Fabrication Drawing |  |  | TBD
Assembly Drawing |  |  | TBD
