John-Nagle/Overbot/gc/parts/throttle/boardlayout/GalilInterfaceUnit_BOM.xls

Part Type | Ref. Des. | Description | MFG | MFG # | SUPPLIER | SUPPLIER # | Qty | Cost | Extended Cost | Notes
DNS | R14,R16 | RES 1/4W ZERO OHM | Yageo | ZOR-25-B | Digikey | 0.0QBK-ND | 2 | 0 | 0 | DELETED
0 | R13,R15 | RES 1/4W ZERO OHM | Yageo | ZOR-25-B | Digikey | 0.0QBK-ND | 0 | 0.054 | 0 | DELETED
0.1uF | C21,C22 | Monolithic Ceramic Standard Bypass cap 0.1uF 100V 10% X7R | Panasonic | ECU-S2A104KBA | Digikey | P4910-ND | 2 | 0.547 | 0
0.022uF | C1,C5,C11,C12,C13,C14,C15,C16,C17,C18,C19,C20 | Monolithic Ceramic Standard Bypass cap 0.022uF 100V 10% X7R | Panasonic | ECU-S2A223KBA | Digikey | P4906-ND | 0 | 0.2277 | 0 | DELETED
1N4148 | D1,D2 | DIODE 75V 500MW FAST SWITCHING | Diodes Inc. | 1N4148-T | Digikey | 1N4148DICT-ND | 2 | 0.0675 | 0
2.2K | RN2,RN4,RN5,RN6,RN8,RN9,RN10 | RES-NET 6PIN 5RES BUSSED SIP | CTS | 77061272 | Digikey | 770-61-R2.2K-ND | 7 | 0.18 | 0
4.7K | RN1,RN3,RN7 | RES-NET 6PIN 5RES BUSSED SIP | CTS | 77061472 | Digikey | 770-61-R4.7K-ND | 3 | 0.18 | 0
4A | F1 | POLYSWITCH 4A RESET FUSE THRUHOLE | Raychem | RHE400 | Digikey | RHE400-ND | 1 | 0.68 | 0
10K | R1,R2,R5,R6,R10,R11 | 10.0K OHM 1/4W 1% METAL FILM RES | Yageo | MFR-25FBF-10K0 | Digikey | 10.0KXBK-ND | 8 | 0.041 | 0
12V Power | J1 | CONN HEADER HIROSE DF22 2POS | Hirose | DF22-2P-7.92DSA | Digikey | H2780-ND | 1 | 0.71 | 0
20K | R9,R12 | 20.0K OHM 1/4W 1% METAL FILM RES | Yageo | MFR-25FBF-20K0 | Digikey | 20.0KXBK-ND | 2 | 0.041 | 0
100uF | C7,C8,C9,C10 | Radial Aluminum Electrolytic (FC) 100uF 25V Irms=290mA low impedance 20% | Panasonic | EEU-FC1E101S | Digikey | P10269-ND | 4 | 0.256 | 0
475 | R4,R8 | 475 OHM 1/4W 1% METAL FILM RES | Yageo | MFR-25FBF-475R | Digikey | 475XBK-ND | 2 | 0.041 | 0
DB-9 | J2,J3,J6,J7,J11,J12,J13,J14 | CONN DB9 Female Hi Profile | Norcomp | 172-009-281-011 | Digikey | 9609F-ND | 8 | 5.28 | 0
DB-37 | J5,J8 | CONN DB37 Female Hi Profile | Norcomp | 172-037-281-011 | Digikey | 9637F-ND | 2 | 16.15 | 0
LM2917N | U1,U2 | Frequency to Voltage Converters | National Semiconductor | LM2917N | Digi-Key | LM2917N-ND | 2 | 2.05 | 0
LM7805CT | U3,U9 | IC ADJ HIGH VOLT. REGULATOR 1.5A | National Semiconductor | LM340AT-5.0 | Digikey | LM340AT-5.0-ND | 2 | 1.24 | 0
PS2505-4 | U4,U5,U6 | 4 CHANNEL OPTO COUPLER TRANS | NEC | PS2505-4 | Digikey | PS2505-4-ND | 5 | 1.975 | 0
PS2506-4 | U7, U8 | 4 CHANNEL OPTO COUPLER TRANS | NEC | PS2506-4 | Digi-Key | PS2506-4-ND | 2
270K (267K) | R3 | 267.0K OHM 1/4W 1% METAL FILM RES | Yageo | MFR-25FBF-267K | Digi-Key | 267KXBK-ND | 1
100K | R7 | 100.0K OHM 1/4W 1% METAL FILM RES | Yageo | MFR-25FBF-100K | Digi-Key | 100KXBK-ND | 1
1uF | C2 | CAP 1UF 50V STACK METAL FILM | Panasonic | ECQ-V1H105JL | Digi-Key | P4675-ND | 1
0.047uF | C3 | CAP .047UF 50V CERAMIC MONO 10% | Panasonic | ECU-S1H473KBB | Digi-Key | P4955-ND | 1
0.22uF | C4 | CAP .22UF 50V STACK METAL FILM | Panasonic | ECQ-V1H224JL | Digi-Key | P4667-ND | 1
0.0033uF | C6 | CAP 3300PF 50V CERAMIC MONO 10% | Panasonic | ECU-S1H332KBA | Digi-Key | P4949-ND | 1
Mating parts for J1:
Socket |  |  | Hirose |  | Digikey | H2784-ND | 1
Pins |  |  | Hirose |  | Digikey | H2788CT-ND | 2
