John-Nagle/Overbot/gc/parts/signs/vehicle_signs/README.txt

SIGNS

   4 signs, aluminum

   strip1.psd	48" x 6.5"
   strip2.psd	48" x 6.5"
   strip3.psd   16" x 6.5"
   strip4.psd	16" x 6.5"
