John-Nagle/Overbot/gc/drawings/parts/sensormounting/newmarkcables.pdf

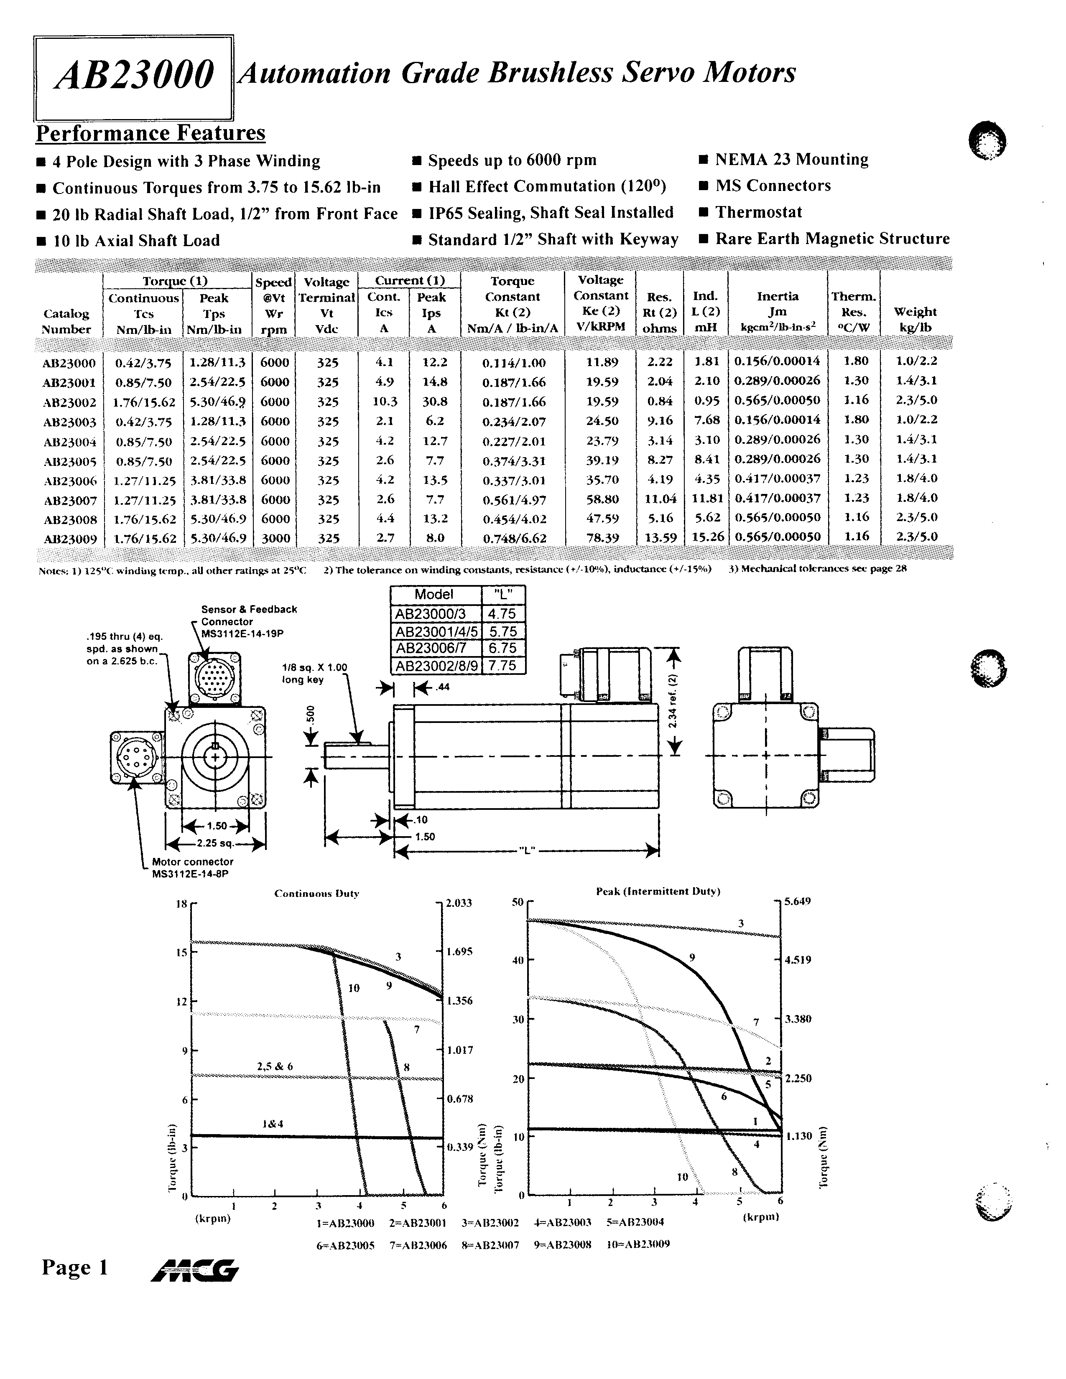
[picture p54: page 1]
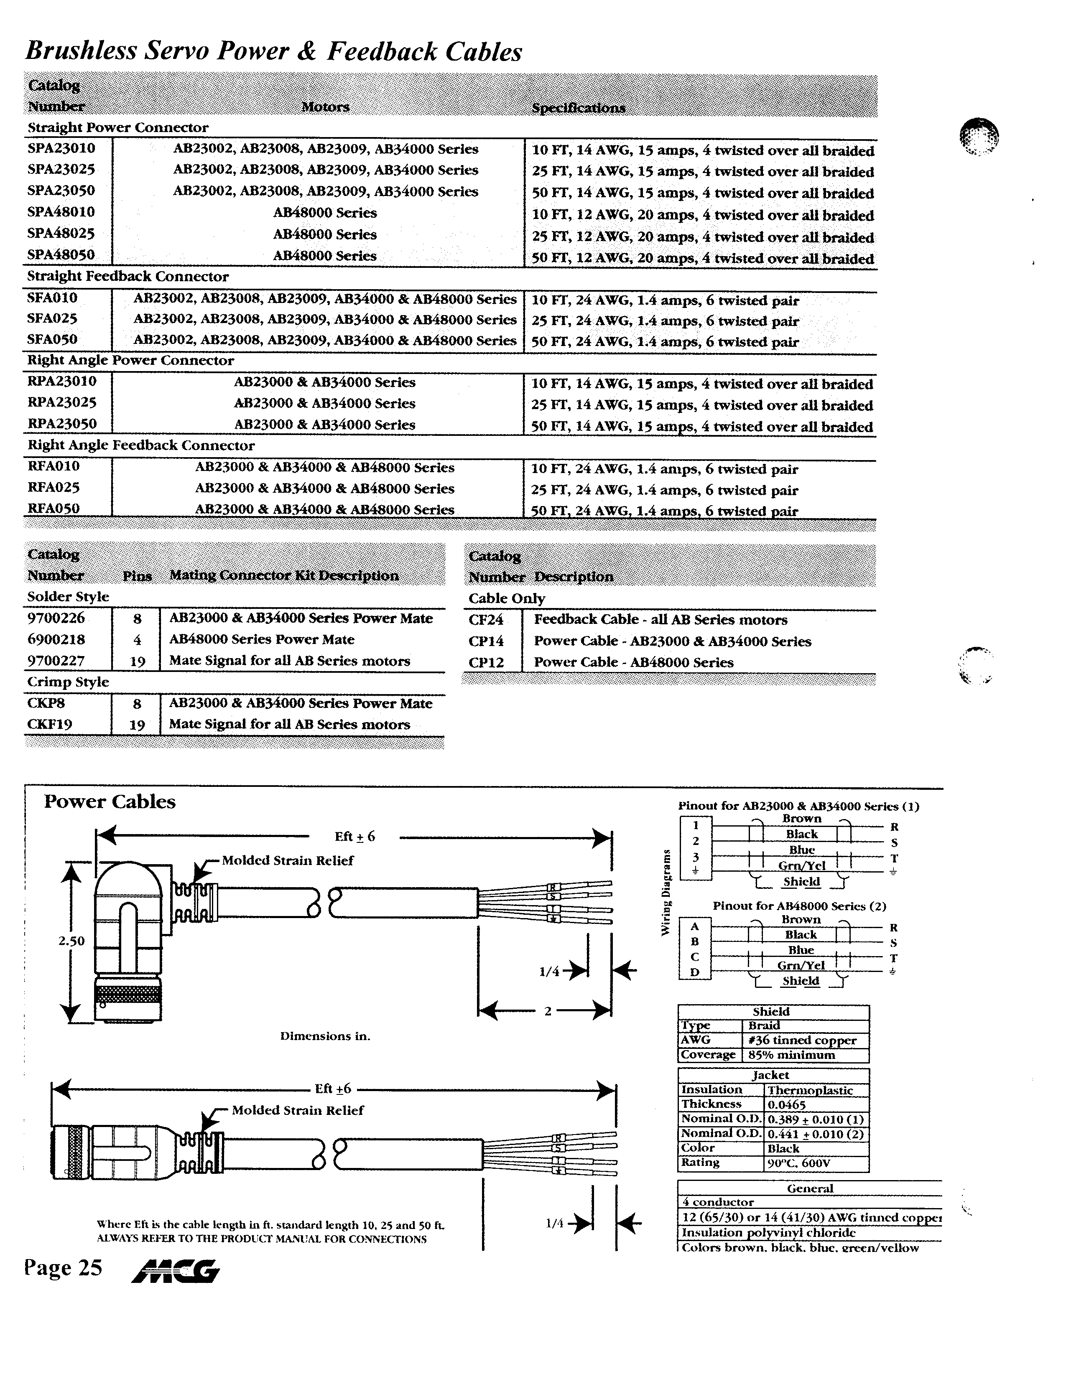
[picture p55: page 2]
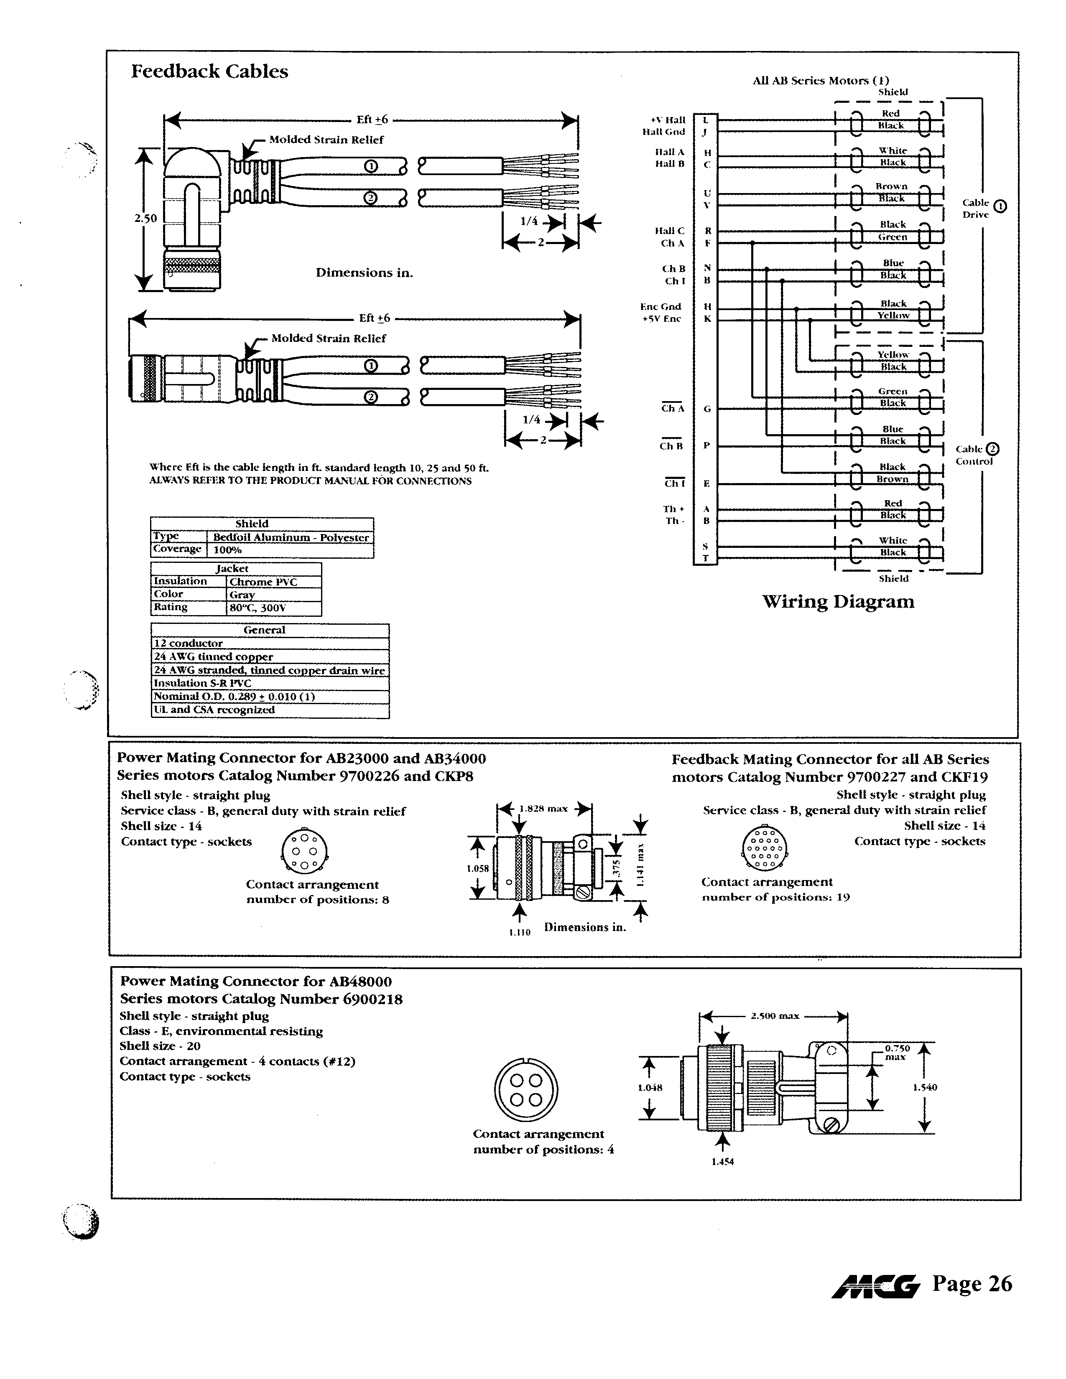
[picture p56: page 3]
