John-Nagle/Overbot/gc/parts/braking/Pictures/Fitting/fitting1.jpg

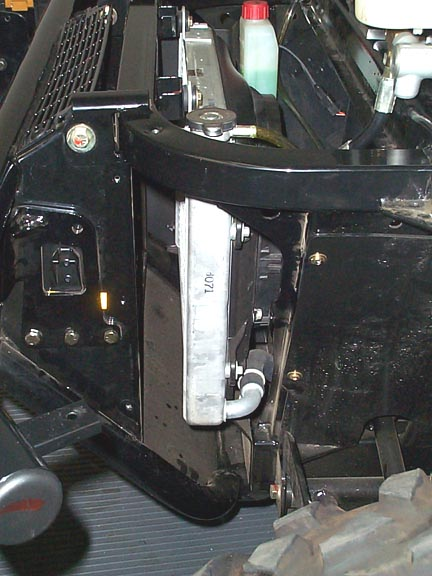
gc/parts/braking/Pictures/Fitting/fitting1.jpg
