John-Nagle/Overbot/gc/parts/braking/Pictures/Fitting/fitting2.jpg

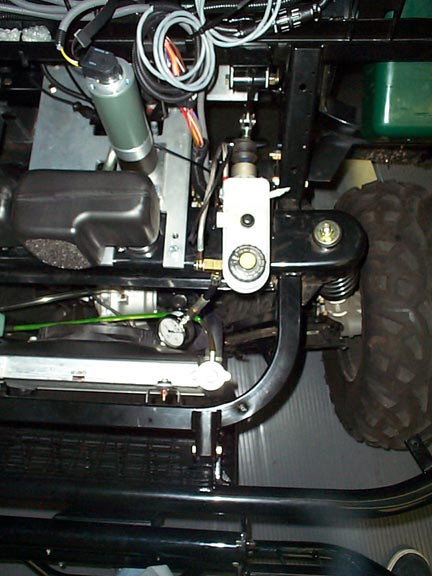
gc/parts/braking/Pictures/Fitting/fitting2.jpg
