John-Nagle/Overbot/gc/parts/braking/Pictures/Fitting/fitting3.jpg

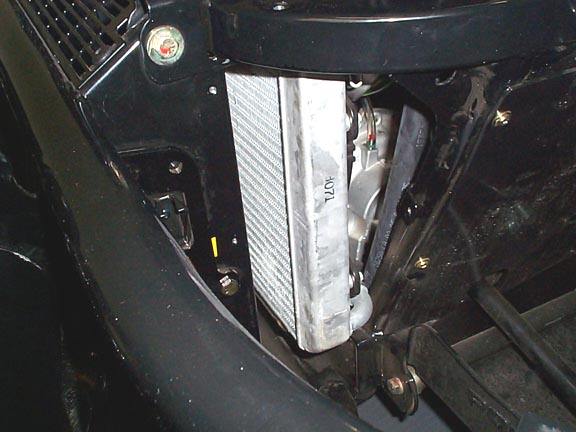
gc/parts/braking/Pictures/Fitting/fitting3.jpg
