John-Nagle/Overbot/gc/parts/braking/Pictures/Fitting/fitting4.jpg

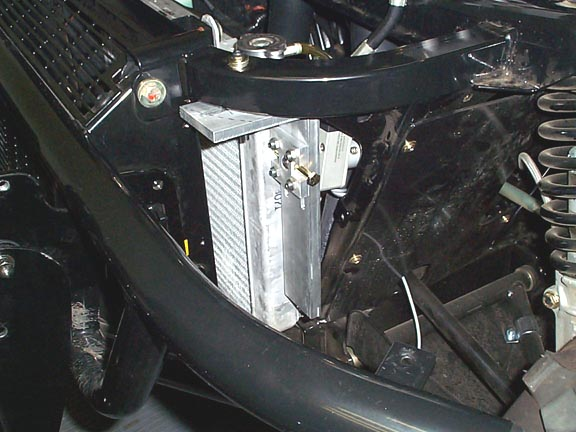
gc/parts/braking/Pictures/Fitting/fitting4.jpg
