John-Nagle/Overbot/gc/parts/braking/Pictures/Fitting/fitting5.jpg

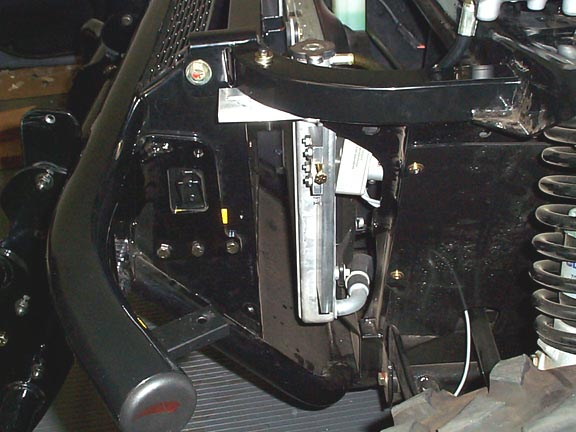
gc/parts/braking/Pictures/Fitting/fitting5.jpg
