John-Nagle/Overbot/gc/parts/braking/Pictures/Fitting/fitting6.jpg

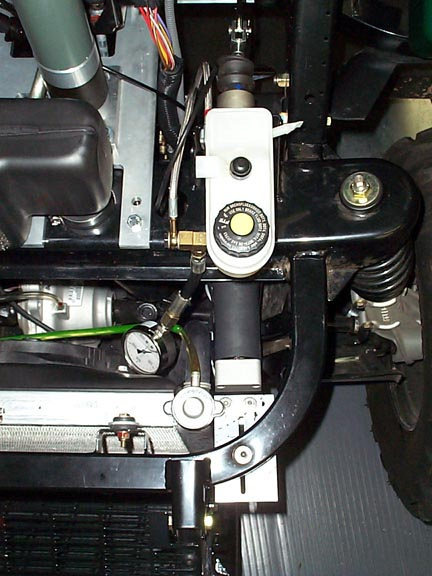
gc/parts/braking/Pictures/Fitting/fitting6.jpg
