John-Nagle/Overbot/gc/parts/braking/Pictures/Fitting/fitting7.jpg

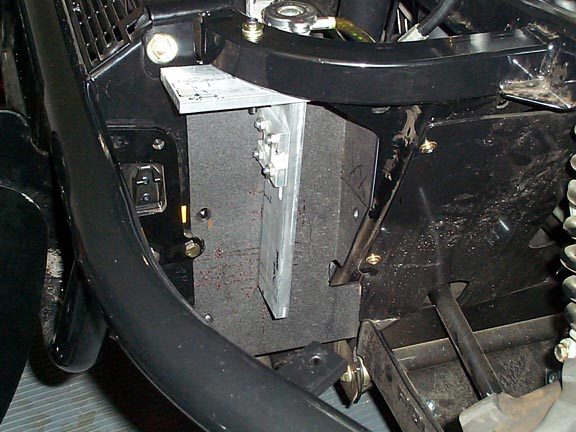
gc/parts/braking/Pictures/Fitting/fitting7.jpg
