John-Nagle/Overbot/gc/parts/braking/Pictures/Initial/act_position_01.jpg

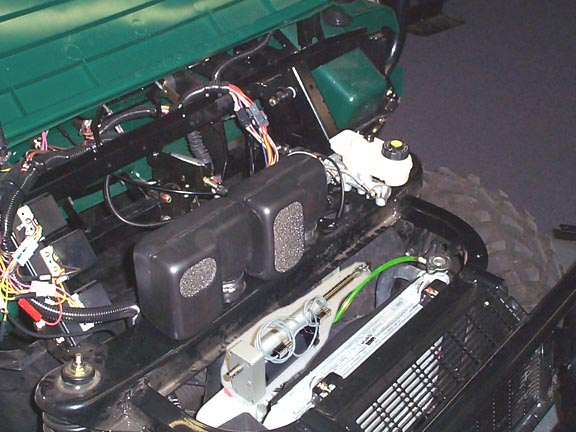
gc/parts/braking/Pictures/Initial/act_position_01.jpg
