John-Nagle/Overbot/gc/parts/braking/Pictures/Initial/brakes01.jpg

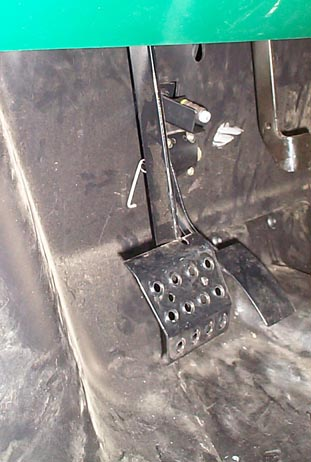
gc/parts/braking/Pictures/Initial/brakes01.jpg
