John-Nagle/Overbot/gc/parts/braking/Pictures/Initial/brakes02.jpg

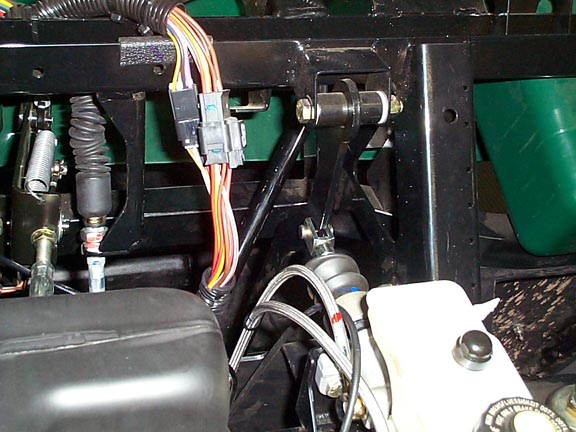
gc/parts/braking/Pictures/Initial/brakes02.jpg
