John-Nagle/Overbot/gc/parts/braking/Pictures/Initial/brakes03.jpg

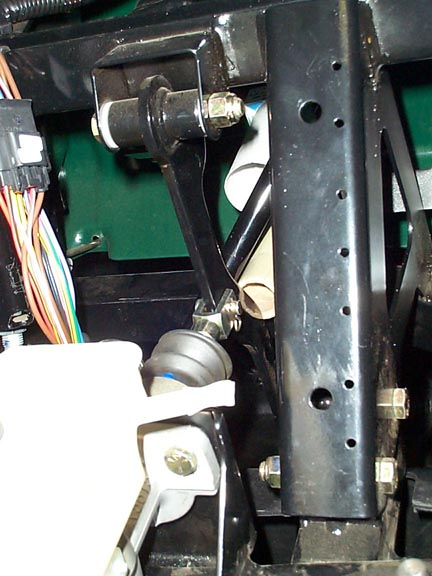
gc/parts/braking/Pictures/Initial/brakes03.jpg
