John-Nagle/Overbot/gc/parts/braking/Pictures/Initial/brakes04.jpg

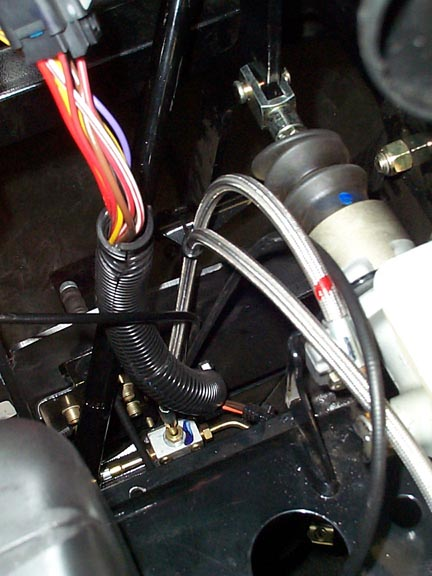
gc/parts/braking/Pictures/Initial/brakes04.jpg
