John-Nagle/Overbot/gc/parts/braking/Pictures/Initial/brakes05.jpg

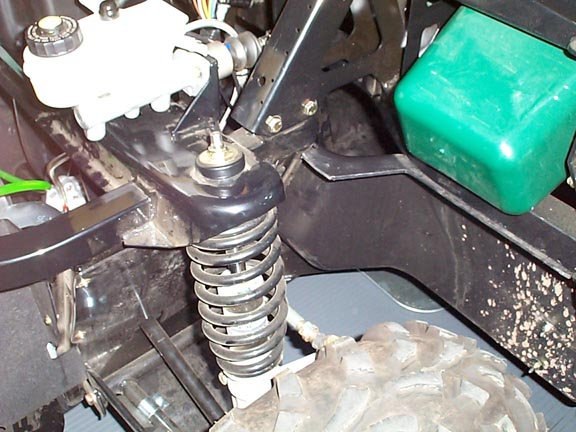
gc/parts/braking/Pictures/Initial/brakes05.jpg
