John-Nagle/Overbot/gc/parts/braking/Pictures/Initial/brakes06.jpg

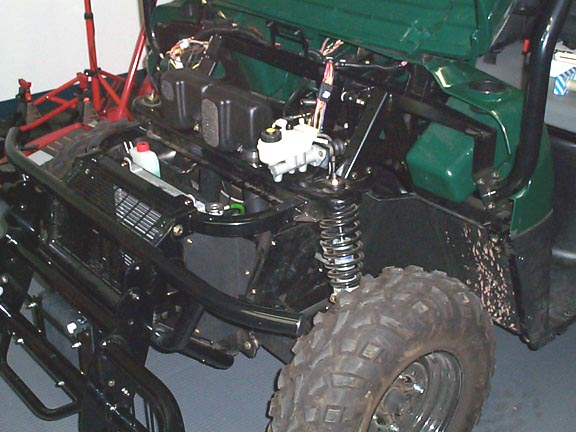
gc/parts/braking/Pictures/Initial/brakes06.jpg
