John-Nagle/Overbot/gc/parts/braking/Pictures/Initial/brakes07.jpg

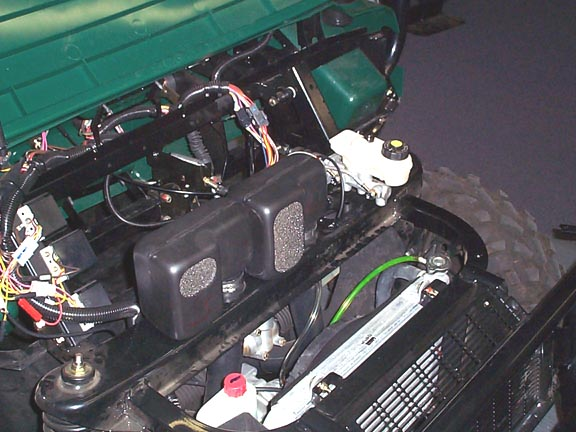
gc/parts/braking/Pictures/Initial/brakes07.jpg
