John-Nagle/Overbot/gc/parts/braking/Pictures/Initial/brakes08.jpg

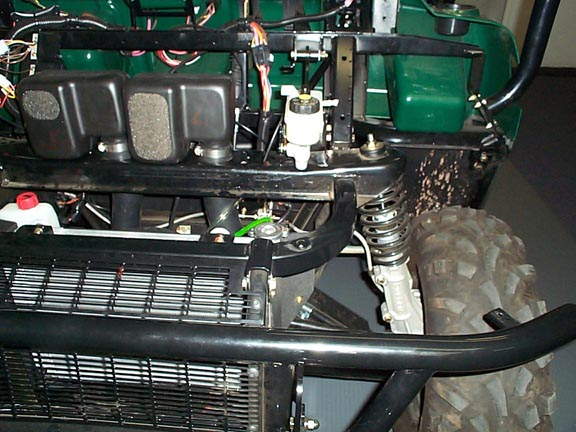
gc/parts/braking/Pictures/Initial/brakes08.jpg
