John-Nagle/Overbot/gc/parts/braking/Pictures/Initial/brakes09.jpg

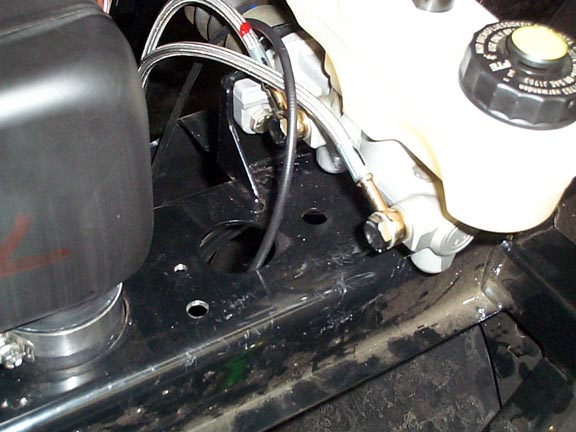
gc/parts/braking/Pictures/Initial/brakes09.jpg
