John-Nagle/Overbot/gc/parts/braking/Pictures/Initial/brakes10.jpg

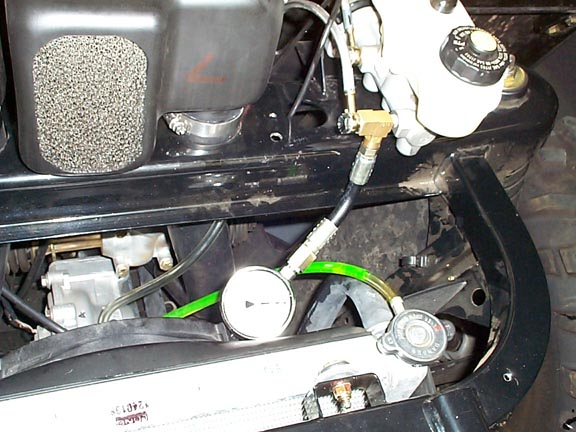
gc/parts/braking/Pictures/Initial/brakes10.jpg
