John-Nagle/Overbot/gc/parts/braking/Pictures/Initial/brakes11.jpg

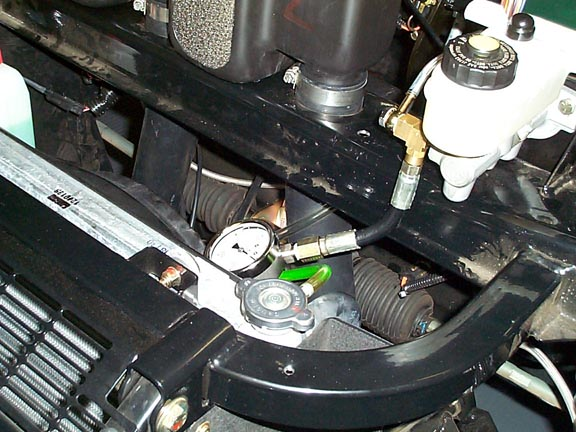
gc/parts/braking/Pictures/Initial/brakes11.jpg
