John-Nagle/Overbot/gc/parts/braking/Pictures/Initial/linear_actuator01.jpg

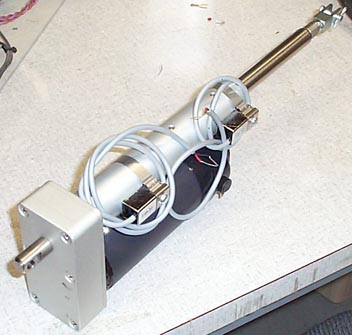
gc/parts/braking/Pictures/Initial/linear_actuator01.jpg
