John-Nagle/Overbot/gc/parts/braking/Pictures/Initial/linear_actuator03.jpg

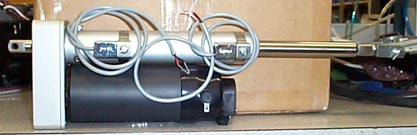
gc/parts/braking/Pictures/Initial/linear_actuator03.jpg
