John-Nagle/Overbot/gc/parts/braking/Pictures/Mounted/mounted01.jpg

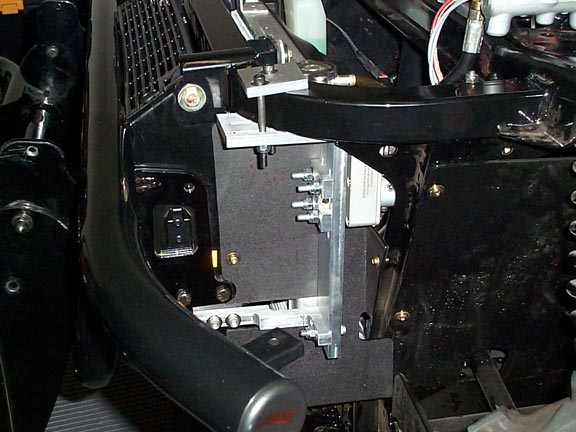
gc/parts/braking/Pictures/Mounted/mounted01.jpg
