John-Nagle/Overbot/gc/parts/braking/Pictures/Mounted/mounted02.jpg

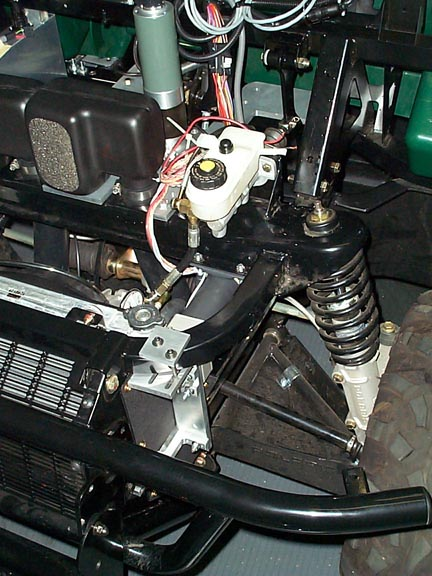
gc/parts/braking/Pictures/Mounted/mounted02.jpg
