John-Nagle/Overbot/gc/parts/braking/Pictures/Mounted/mounted03.jpg

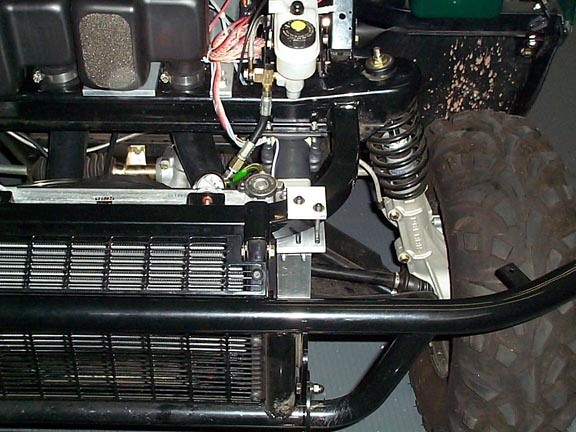
gc/parts/braking/Pictures/Mounted/mounted03.jpg
