John-Nagle/Overbot/gc/parts/braking/Pictures/Mounted/mounted04.jpg

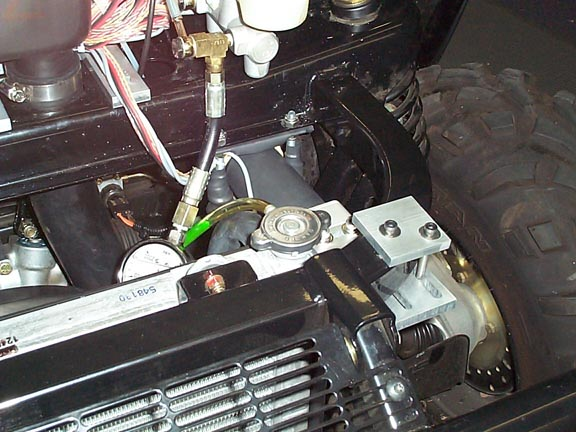
gc/parts/braking/Pictures/Mounted/mounted04.jpg
