John-Nagle/Overbot/gc/parts/braking/Pictures/Mounted/mounted05.jpg

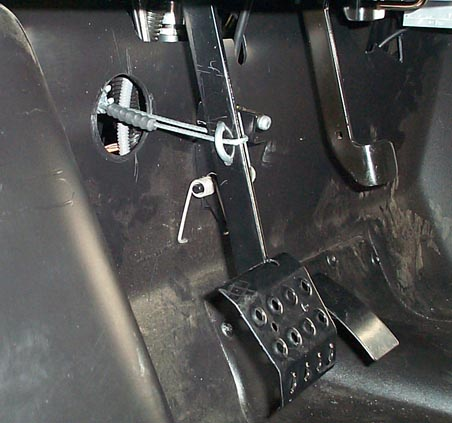
gc/parts/braking/Pictures/Mounted/mounted05.jpg
