John-Nagle/Overbot/gc/parts/braking/Pictures/Mounted/mounted06.jpg

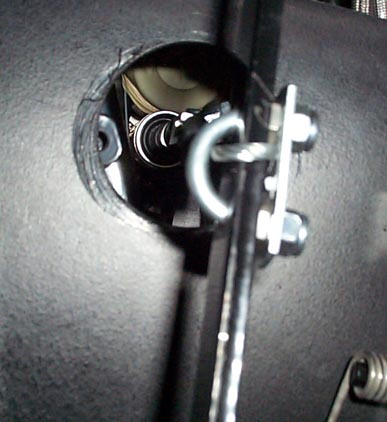
gc/parts/braking/Pictures/Mounted/mounted06.jpg
