John-Nagle/Overbot/gc/parts/braking/Pictures/Mounted/mounted08.jpg

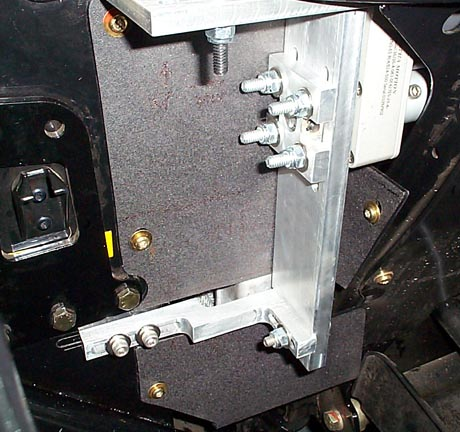
gc/parts/braking/Pictures/Mounted/mounted08.jpg
