John-Nagle/Overbot/gc/parts/braking/Pictures/Mounted/mounted09.jpg

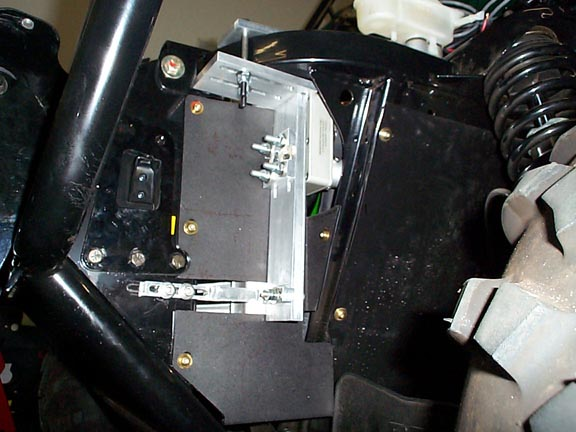
gc/parts/braking/Pictures/Mounted/mounted09.jpg
