John-Nagle/Overbot/gc/parts/braking/Pictures/Mounted/mounted10.jpg

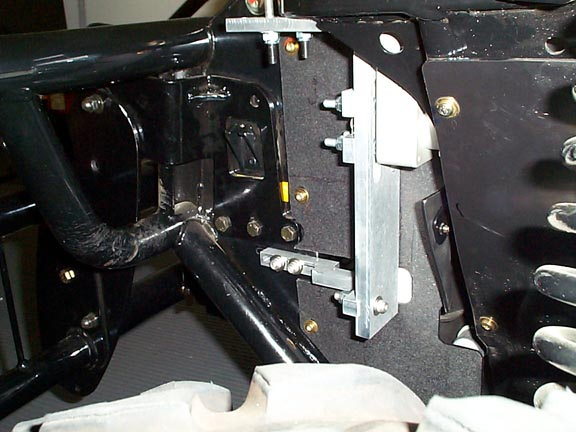
gc/parts/braking/Pictures/Mounted/mounted10.jpg
