John-Nagle/Overbot/gc/parts/motion_control/micromo_LT1.jpg

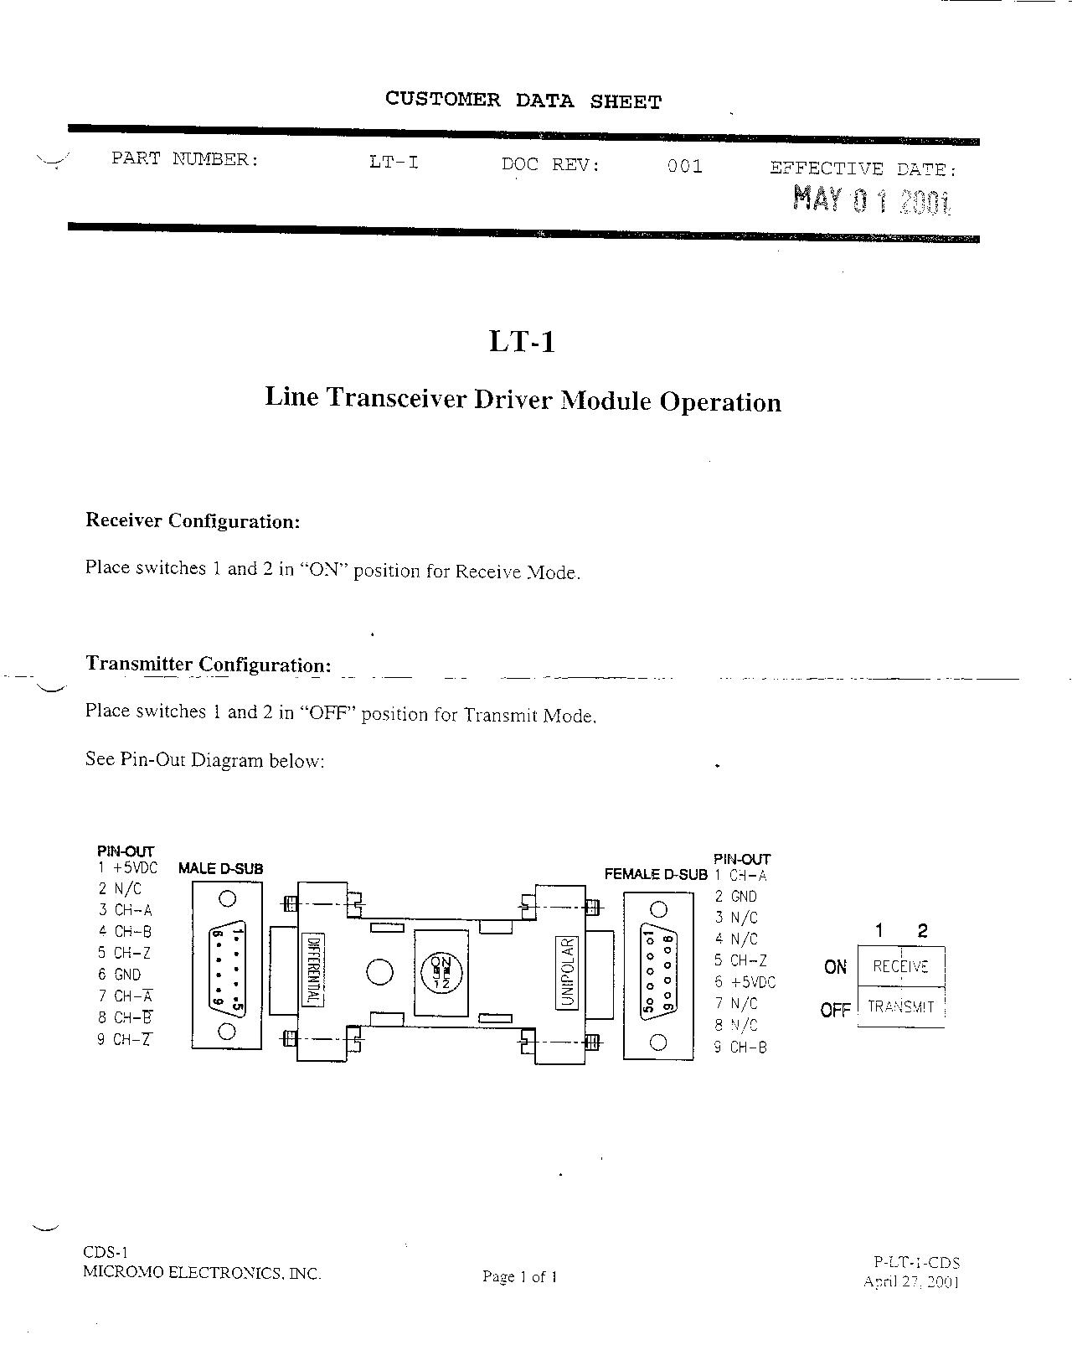
gc/parts/motion_control/micromo_LT1.jpg
