John-Nagle/Overbot/gc/parts/motion_control/micromo_MPM_p2.jpg

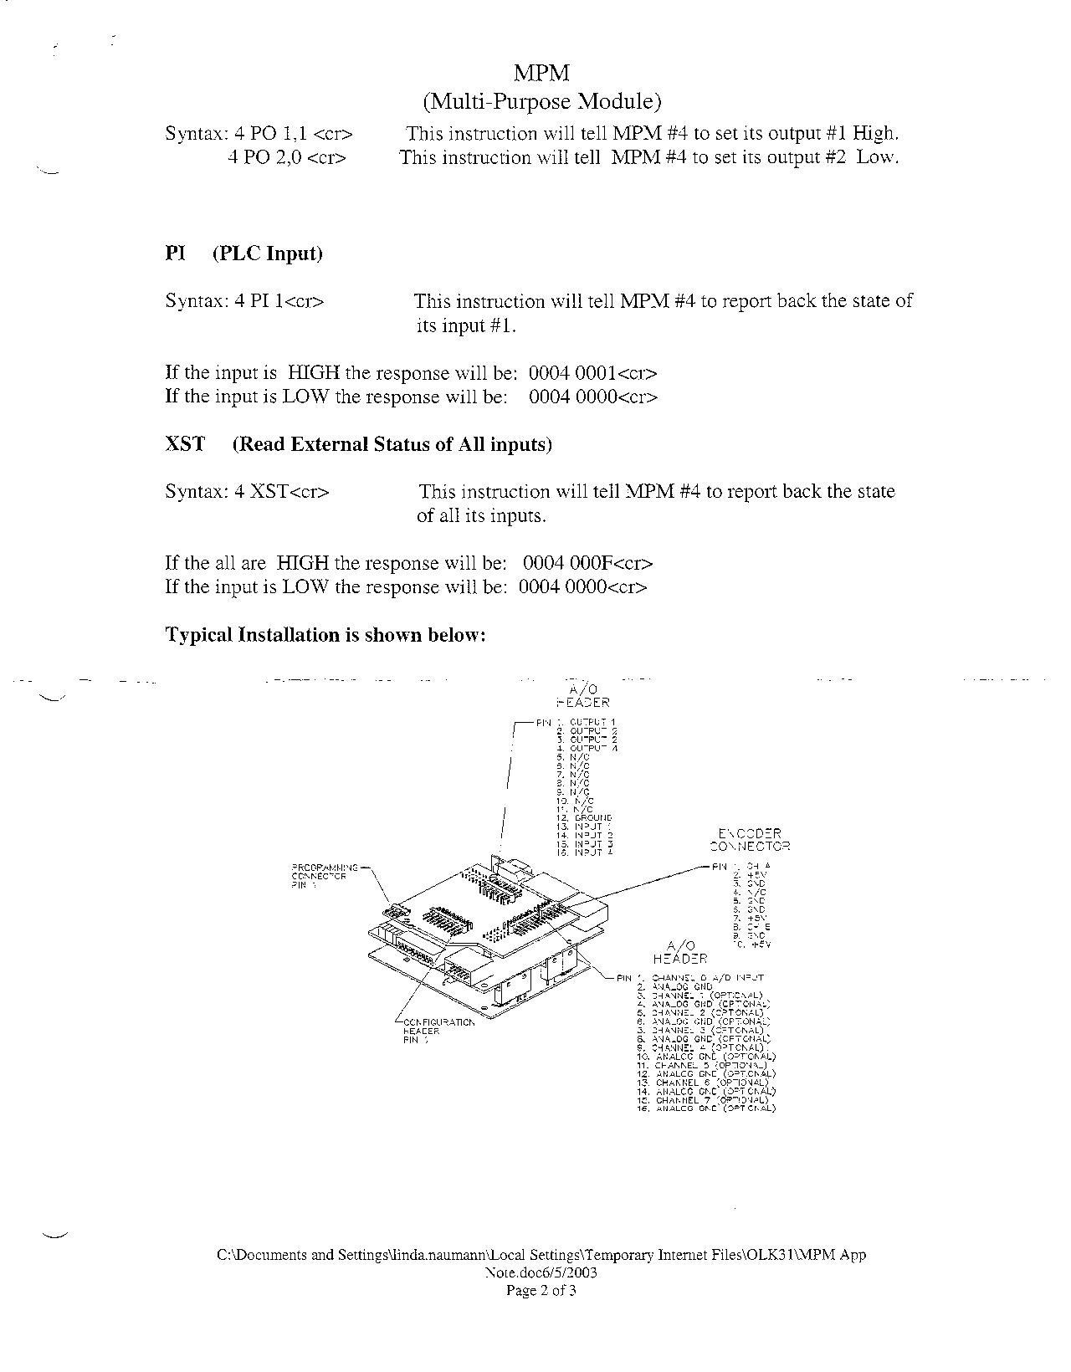
gc/parts/motion_control/micromo_MPM_p2.jpg
