John-Nagle/Overbot/gc/parts/motion_control/micromo_MPM_p3.jpg

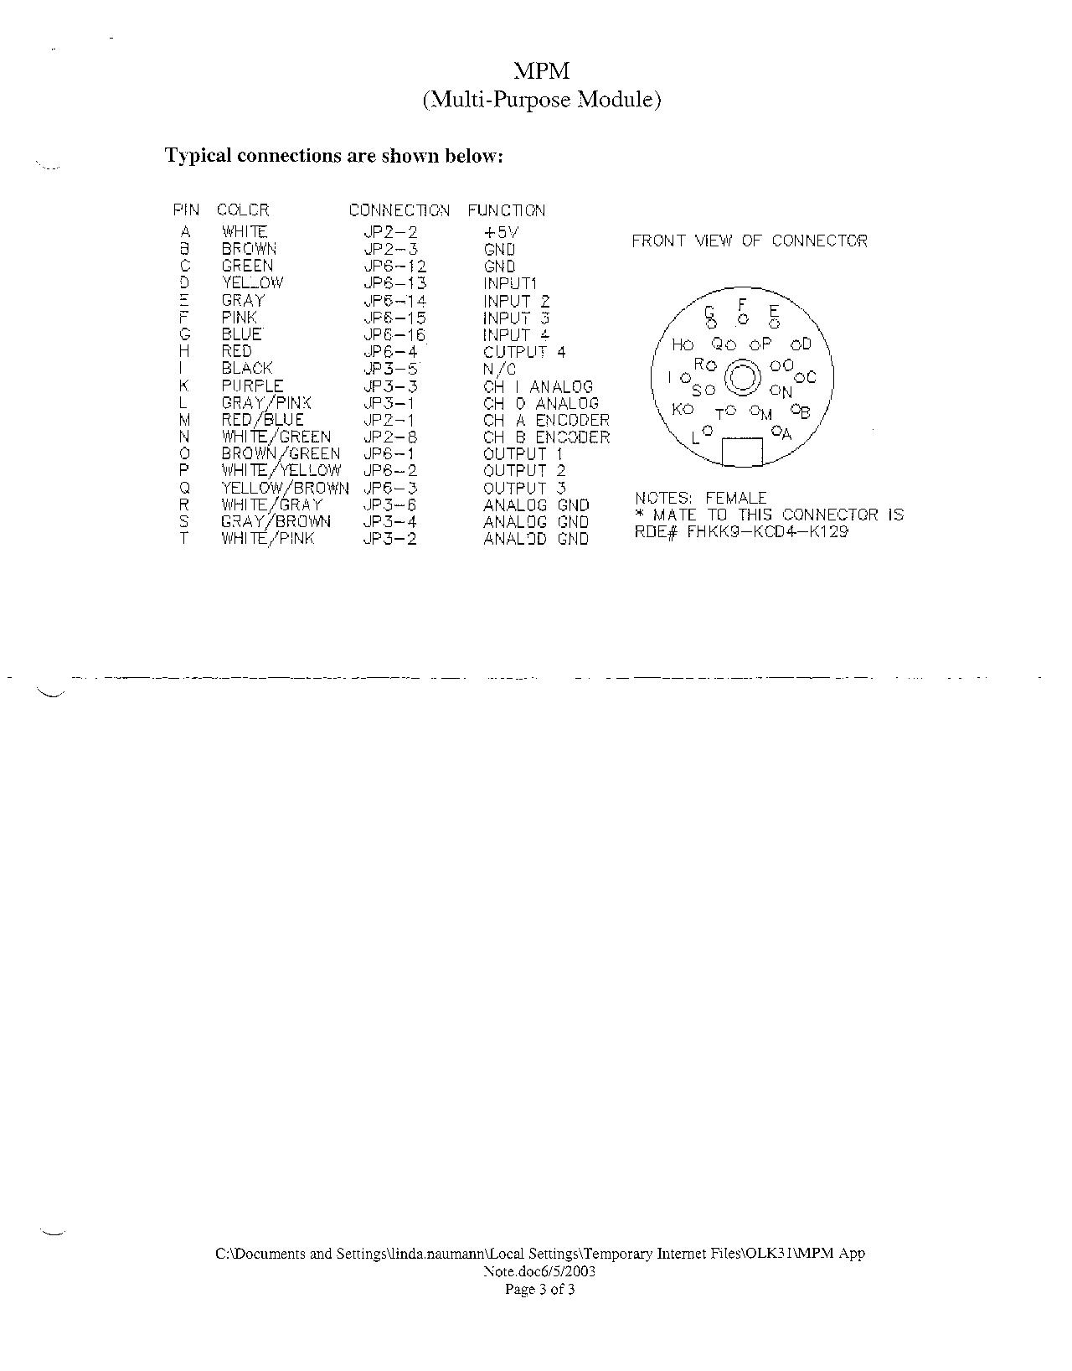
gc/parts/motion_control/micromo_MPM_p3.jpg
