John-Nagle/Overbot/gc/parts/motion_control/micromo_RS485conv.jpg

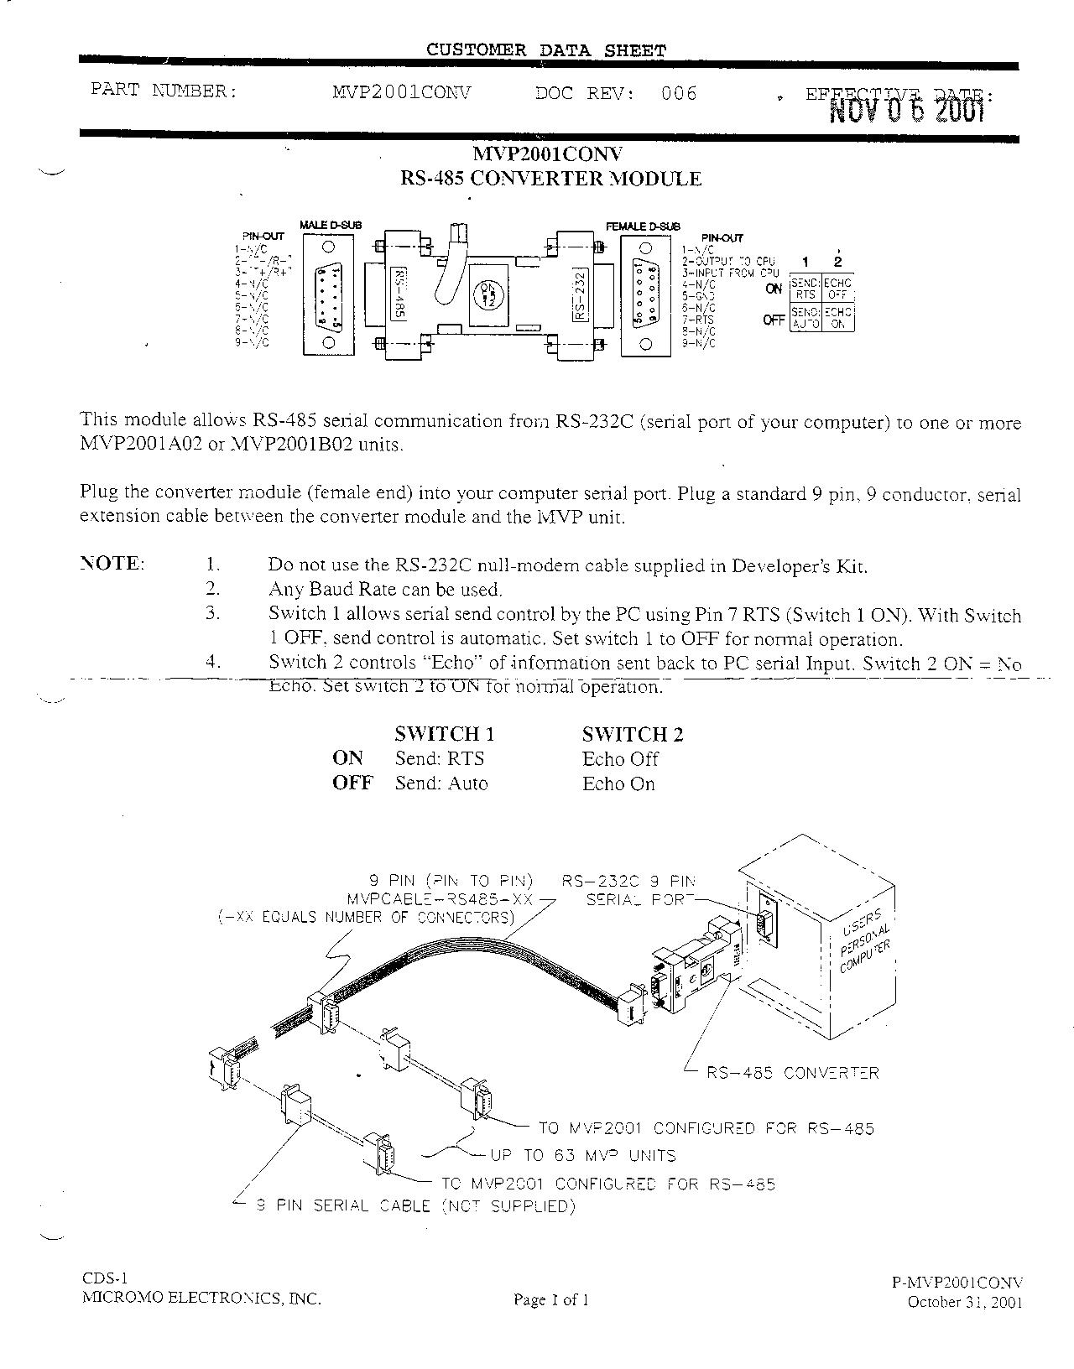
gc/parts/motion_control/micromo_RS485conv.jpg
