John-Nagle/Overbot/gc/parts/steering/lower_shaft.jpg

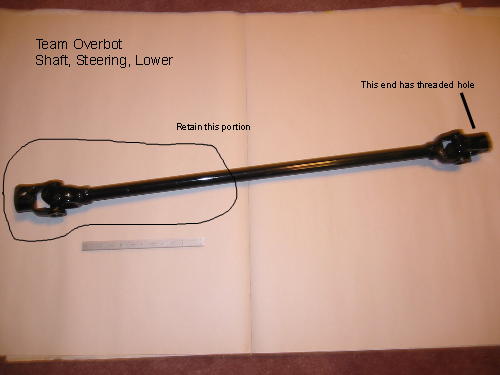
gc/parts/steering/lower_shaft.jpg
