John-Nagle/Overbot/gc/parts/steering/upper_shaft.jpg

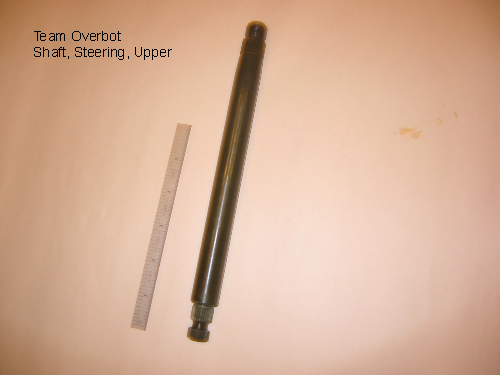
gc/parts/steering/upper_shaft.jpg
