John-Nagle/Overbot/gc/parts/throttle/images/frontpanel2.gif

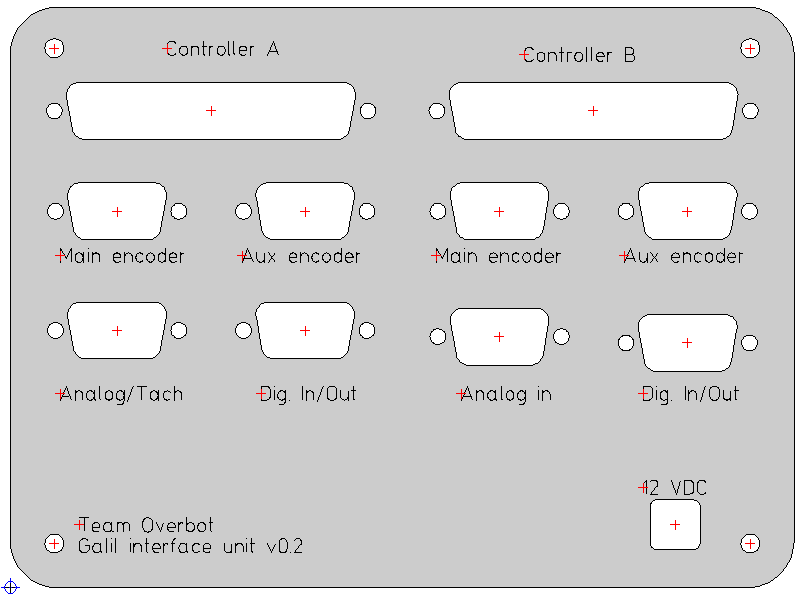
gc/parts/throttle/images/frontpanel2.gif
