John-Nagle/Overbot/gc/parts/throttle/images/gcthrottle-connectors.bmp

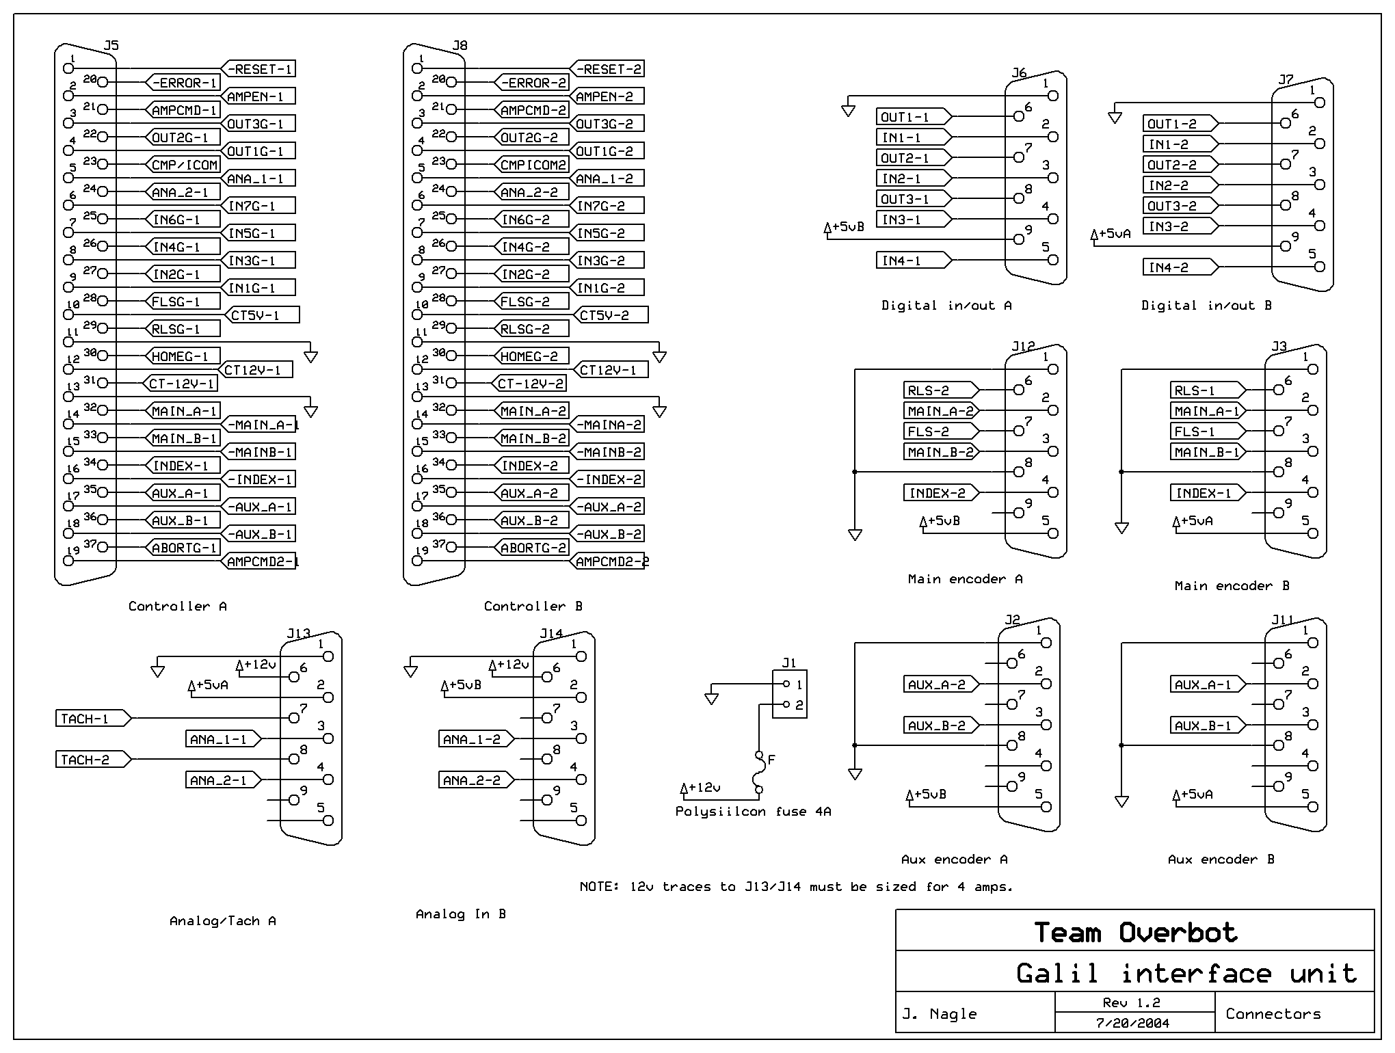
gc/parts/throttle/images/gcthrottle-connectors.bmp
