John-Nagle/Overbot/gc/parts/throttle/images/gcthrottle-mountingplate.bmp

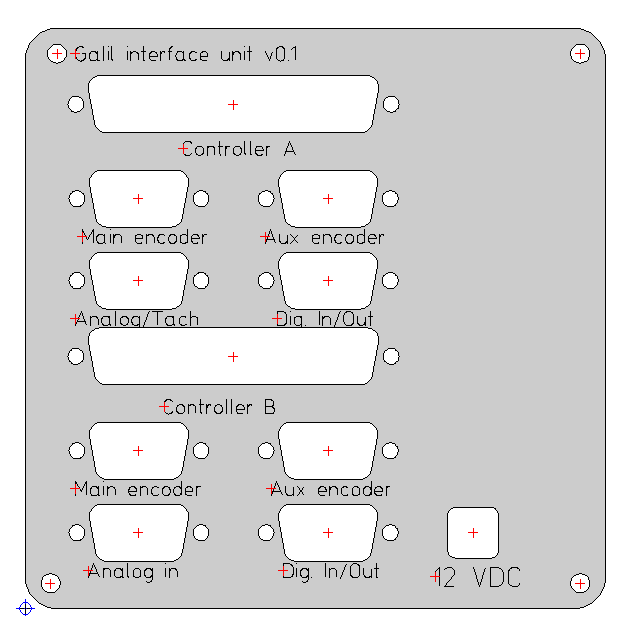
gc/parts/throttle/images/gcthrottle-mountingplate.bmp
