John-Nagle/Overbot/gc/parts/throttle/images/gcthrottle-opto.bmp

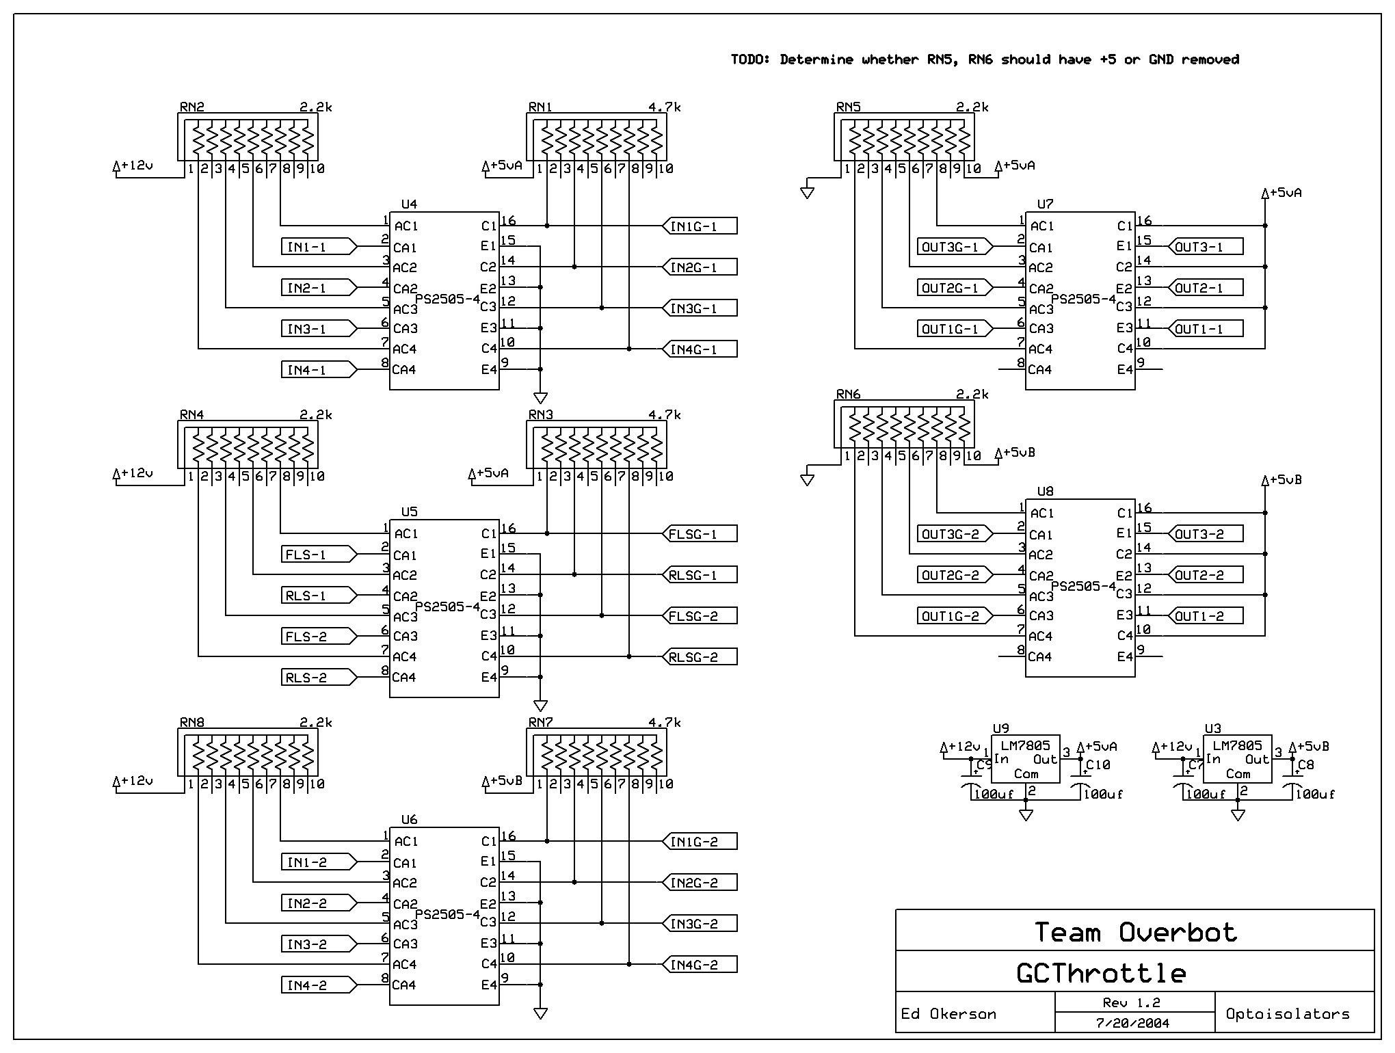
gc/parts/throttle/images/gcthrottle-opto.bmp
