John-Nagle/Overbot/gc/parts/throttle/images/gcthrottle-pullups.bmp

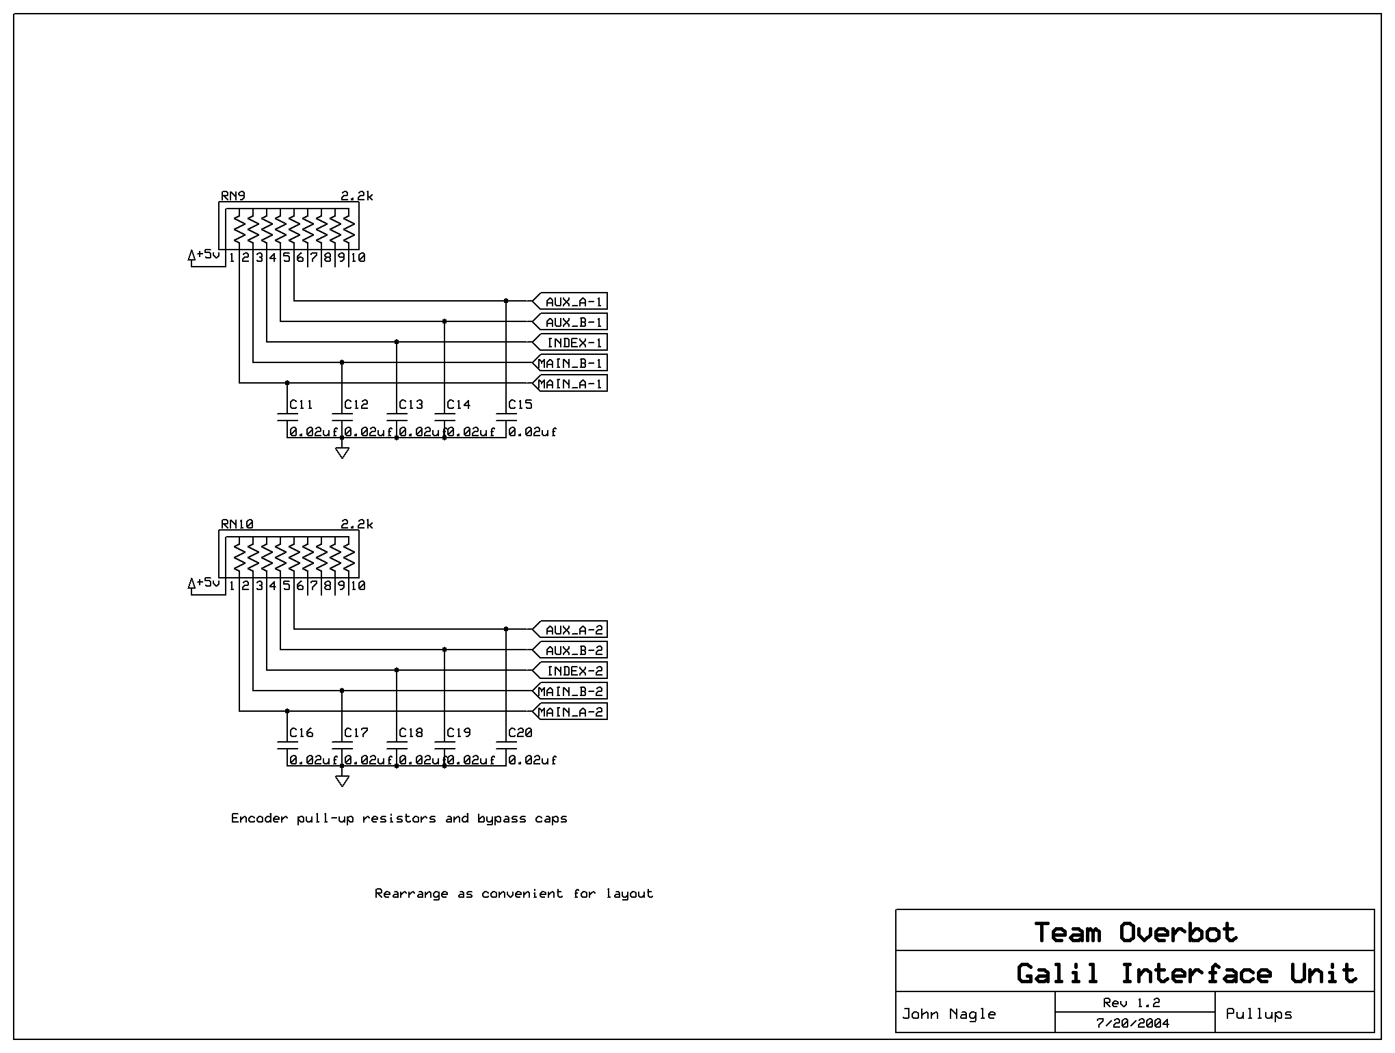
gc/parts/throttle/images/gcthrottle-pullups.bmp
