John-Nagle/Overbot/gc/parts/throttle/images/gcthrottle-tach.bmp

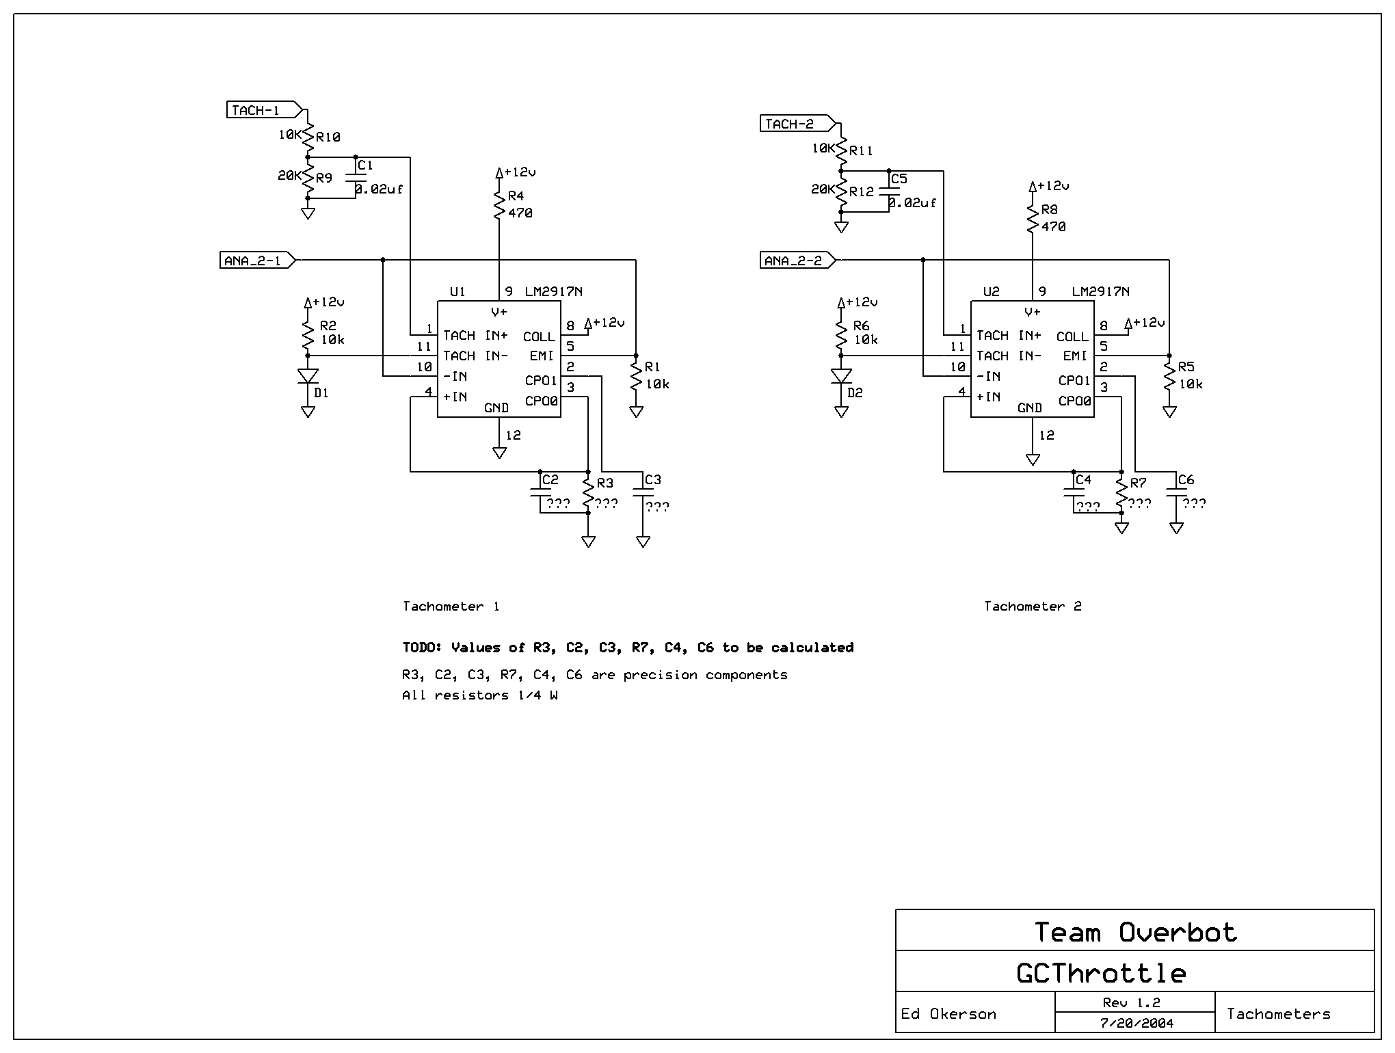
gc/parts/throttle/images/gcthrottle-tach.bmp
