John-Nagle/Overbot/gc/parts/throttle/images/gcthrottle-trouble.gif

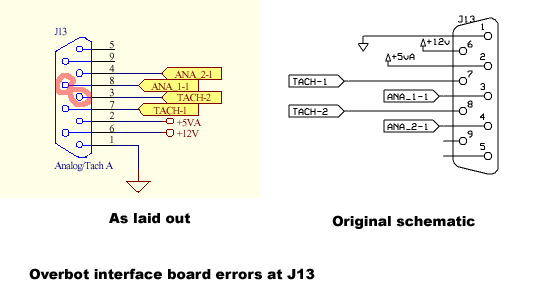
gc/parts/throttle/images/gcthrottle-trouble.gif
