John-Nagle/Overbot/(list of files, cad)

Other CAD files:
gc/parts/braking/Drawings/AutocadR13/bracket_main_R13.dwg
gc/parts/steering/lower_assy.dwg
gc/parts/laser_range_finder/mountingrails.dwg
gc/parts/motion_control/galilbaseplate.dwg
gc/parts/power/ctlscutouts.dwg
gc/parts/speedo/DICKEYJOHNBRACKET2.dwg
gc/parts/steering/lower_shaft.dwg
gc/parts/templates/title_block.dwg
gc/parts/transmission/bracket_bellcrank.dwg
gc/parts/braking/Drawings/AutocadR13/bracket_top_R13.dwg
gc/parts/power/lidcutouts.dwg
gc/parts/speedo/dickeyjohnplate1..dwg
gc/parts/steering/upper_sleeve.dwg
gc/parts/transmission/bracket_cable_actuator.dwg
gc/parts/braking/Drawings/AutocadR13/bracket_cap_R13.dwg
gc/parts/steering/lower_sleeve.dwg
gc/parts/transmission/bracket_cable_crank.dwg
gc/parts/braking/Drawings/AutocadR13/bracket_slide_R13.dwg
gc/parts/steering/lower_plate.dwg
gc/parts/transmission/bracket_mount.dwg
gc/parts/braking/Drawings/AutocadR13/bracket_support_R13.dwg
gc/parts/steering/lower_subplate.dwg
gc/parts/transmission/block_mount.dwg
gc/parts/transmission/plate_antirotation.dwg
gc/parts/steering/upper_shaft.dwg
gc/parts/steering/upper_plate.dwg
gc/parts/braking/Drawings/AutocadR13/ubolt_padded_R13.dwg
gc/simulation/blender/terraintest1.blend
