John-Nagle/Overbot/gc/src/qnx/support/manualdrive/README.txt

manualdrive -- Manual driving program

Allows driving using a USB steering wheel and pedals.

Basic manual driving doesn't depend on any other software other than
the programs in the Galil controllers. 

Coming soon - an interface for testing the move server.
