John-Nagle/Overbot/gc/parts/braking/Pictures/Hardware/assembly1.jpg

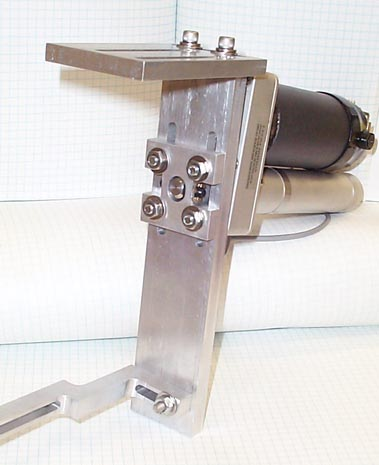
gc/parts/braking/Pictures/Hardware/assembly1.jpg
