John-Nagle/Overbot/gc/parts/braking/Pictures/Hardware/assembly2.jpg

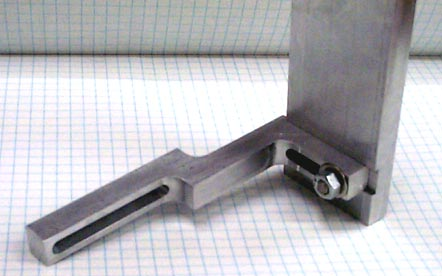
gc/parts/braking/Pictures/Hardware/assembly2.jpg
