John-Nagle/Overbot/gc/parts/braking/Pictures/Hardware/assembly3.jpg

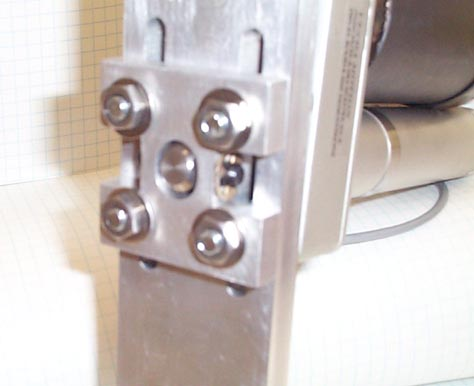
gc/parts/braking/Pictures/Hardware/assembly3.jpg
