John-Nagle/Overbot/gc/parts/braking/Pictures/Hardware/assembly5.jpg

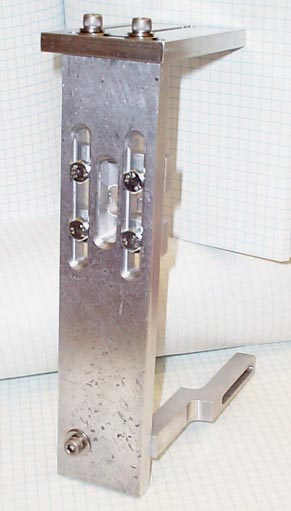
gc/parts/braking/Pictures/Hardware/assembly5.jpg
