John-Nagle/Overbot/gc/parts/braking/Pictures/Hardware/assembly6.jpg

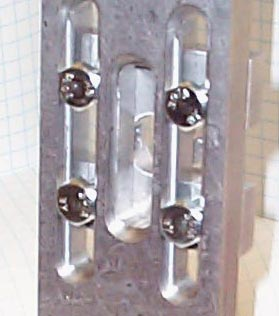
gc/parts/braking/Pictures/Hardware/assembly6.jpg
