John-Nagle/Overbot/gc/src/qnx/common/doc/opencv/ref/pics/building.jpg

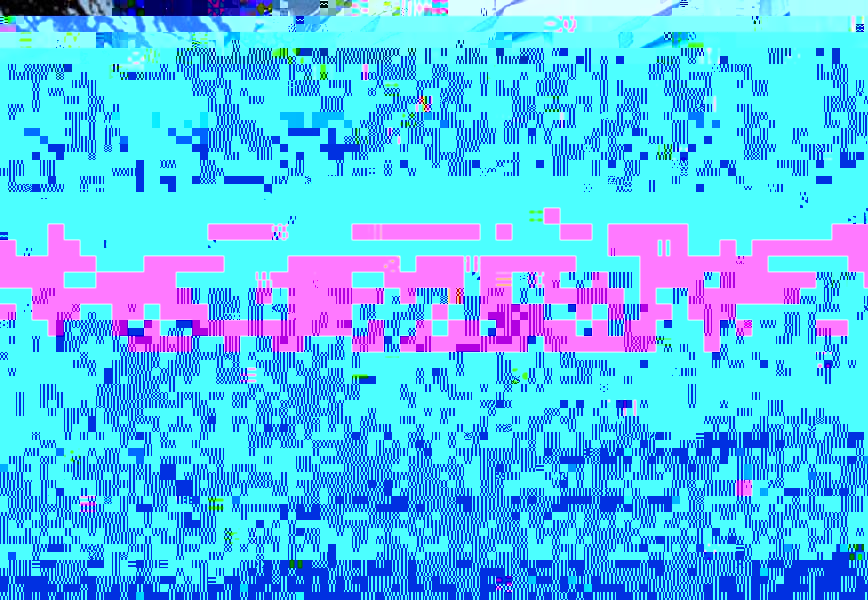
gc/src/qnx/common/doc/opencv/ref/pics/building.jpg
