John-Nagle/Overbot/gc/src/qnx/drivers/devfw-ohci/tests/README.txt

Simple tests for FireWire camera driver.
