John-Nagle/Overbot/gc/src/qnx/drivers/devfw-ohci/tests/viewer/README.txt

Viewer for FireWire camera output.
"devfw-ohci" driver must be running, with Mindready LLA installed.
Then you can open FireWire cameras and see what they see.
