John-Nagle/Overbot/gc/src/qnx/vision/roadfollower/tests/roadviewer/README.txt

Test program for road follower. 
"devfw-ohci" driver must be running, with Mindready LLA installed.
Then you can open FireWire cameras and see what they see.

26 JAN 2004 -- J. Nagle

Appears to work fine.
