John-Nagle/Overbot/gc/src/qnx/drivers/lms/tests/python/NOTES.txt

Windows program path:

sys.path.append('D:\\projects\\overbot\\gc\\src\\qnx\\drivers\\lms\\tests\\python')

Data file:

Looking at ceiling, old, bad format:

'D:\\projects\\overbot\\logs\\lidarscans20041208_212937.log'
