John-Nagle/Overbot/gc/tests/fuel_capacity/fuel_capacity_20030625.xls

Team Overbot
Test | Fuel Capacity
By | Celia Oakley
Date | 2003-06-25
Conversions | cups -> gallons |  | 0.0625
Test #1
gas added | 8 | gallons | 3 | cups
total | 8.2 | gallons
