John-Nagle/Overbot/gc/tests/fuel_consumption/fuel_consumption_20030625.xls

Team Overbot
Test | Fuel Consumption
By | Celia Oakley
Date | 2003-06-25
Road | Dry asphalt of big yard at Redwood Junction
Weather | Bright sunny day
Tire Pressure | 10 +/-0.25 psi, all 6 tires
Driver | Celia Oakley
Weight | 125 lbs
Other Wt | none
Conversions | feet -> miles |  | 0.0001893939394
 | sec -> hour |  | 0.0002777777778
Run #1
Distance | 370 | ft
Gear | H | (High)
Gas | 0.5 | gallons
 | recorded data |  | calculated data
group | laps | time | hour | minute | second | seconds | sec/laps | sec/lap | mph
1 | 5 | 0:01:30 | 0 | 1 | 30 | 90 | 90 | 18.0 | 14.0
2 | 5 | 0:02:55 | 0 | 2 | 55 | 175 | 85 | 17.0 | 14.8
3 | 5 | 0:04:17 | 0 | 4 | 17 | 257 | 82 | 16.4 | 15.4
4 | 5 | 0:05:36 | 0 | 5 | 36 | 336 | 79 | 15.8 | 16.0
5 | 10 | 0:08:13 | 0 | 8 | 13 | 493 | 157 | 15.7 | 16.1
6 | 10 | 0:10:53 | 0 | 10 | 53 | 653 | 160 | 16.0 | 15.8
7 | 10 | 0:13:26 | 0 | 13 | 26 | 806 | 153 | 15.3 | 16.5
8 | 10 | 0:15:56 | 0 | 15 | 56 | 956 | 150 | 15.0 | 16.8
9 | 10 | 0:18:21 | 0 | 18 | 21 | 1101 | 145 | 14.5 | 17.4
10 | 10 | 0:20:55 | 0 | 20 | 55 | 1255 | 154 | 15.4 | 16.4
11 | 10 | 0:23:25 | 0 | 23 | 25 | 1405 | 150 | 15.0 | 16.8
12 | 10 | 0:25:52 | 0 | 25 | 52 | 1552 | 147 | 14.7 | 17.2
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
