John-Nagle/Overbot/gc/tests/lidar/viewfrombench.jpg

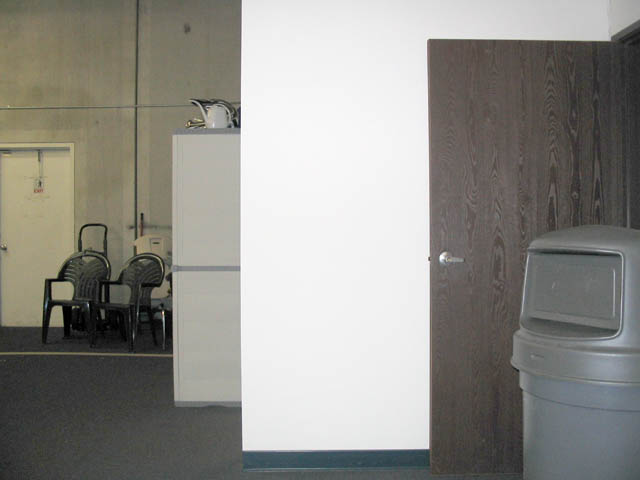
gc/tests/lidar/viewfrombench.jpg
