John-Nagle/Overbot/gc/src/qnx/drivers/sonars/TODO.txt

- hook up n sonars
- test with different transducer
- act as server
- set up man page
- take in -d /dev/ser? as argument
