John-Nagle/Overbot/gc/src/qnx/support/reboot/TODO.txt

- test with ampro, make sure they work
- move to drivers
- change name to devwd-ampro400, devwd-nova8890
