John-Nagle/Overbot/gc/parts/estop/EstopClean.pdf

## 1. Manual Mode Select 2. Comp. Mode Select

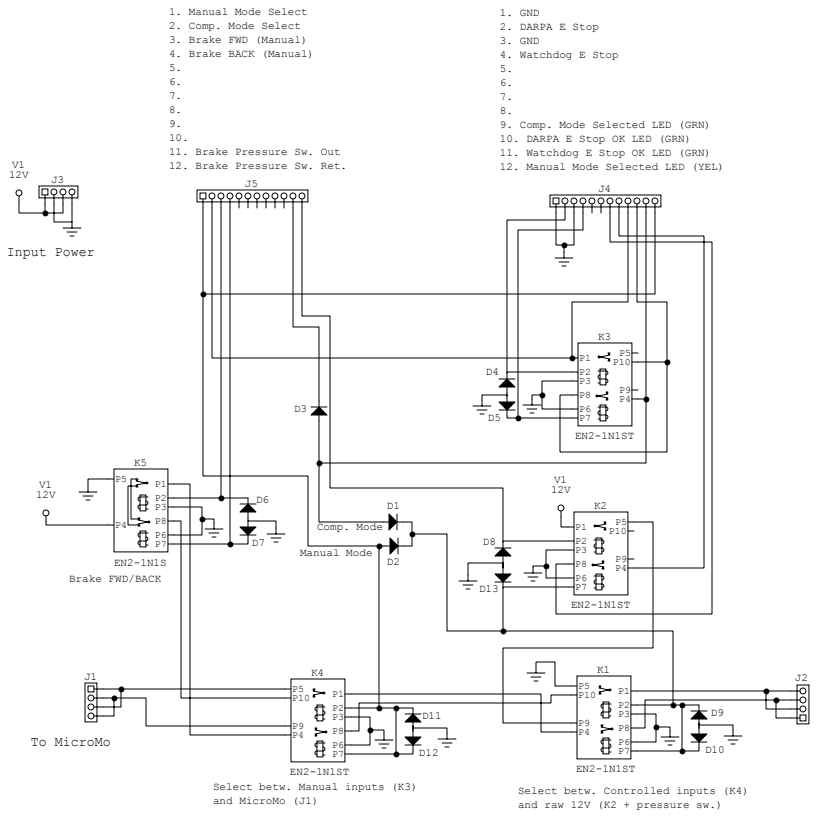
[picture p108: page 1]

1. GND
2. DARPA E Stop
3. GND
4. Watchdog E Stop
9. Comp. Mode Selected LED (GRN)
10. DARPA E Stop OK LED (GRN)
11. Watchdog E Stop OK LED (GRN)
12. Manual Mode Selected LED (YEL)

Select betw. Manual inputs (K3)
and MicroMo (J1)

Select betw. Controlled inputs (K4)
and raw 12V (K2 + pressure sw.)

# 4 Pin Amp CPC Connector

# ESTOP BUTTON ASSEMBLY

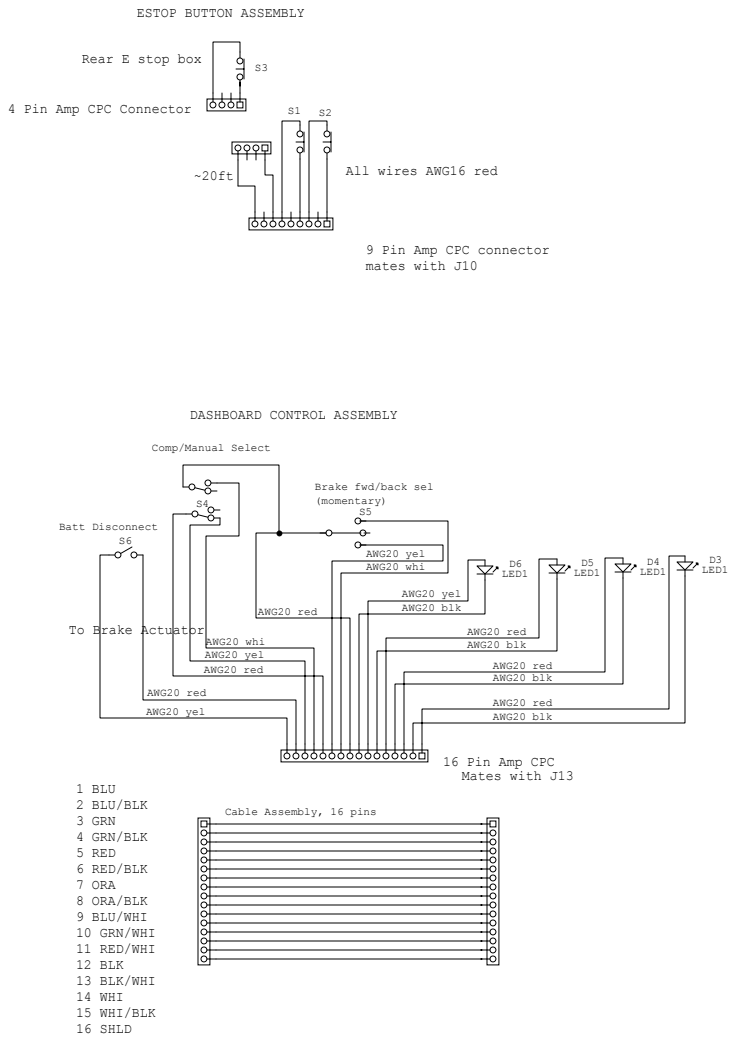
[picture p109: page 2]
1 BLU 2 BLU/BLK 3 GRN 4 GRN/BLK 5 RED 6 RED/BLK 7 ORA 8 ORA/BLK 9 BLU/WHI 10 GRN/WHI 11 RED/WHI 12 BLK 13 BLK/WHI 14 WHI 15 WHI/BLK 16 SHLD; Batt Disconnect; AWG20 red; AWG20 red AWG20 blk; AWG20 blk; AWG20 yel AWG20 blk; AWG20 yel AWG20 whi; AWG20 yel; AWG20 whi AWG20 yel; D3 LED1; D4 LED1; D5 LED1; D6 LED1

Rear E stop box

All wires AWG16 red ~20ft

9 Pin Amp CPC connector
mates with J10

DASHBOARD CONTROL ASSEMBLY

Comp/Manual Select

Brake fwd/back sel
(momentary)

To Brake Actuator

16 Pin Amp CPC
Mates with J13

Cable Assembly, 16 pins

# To Dashboard Cntl Assembly To Estop

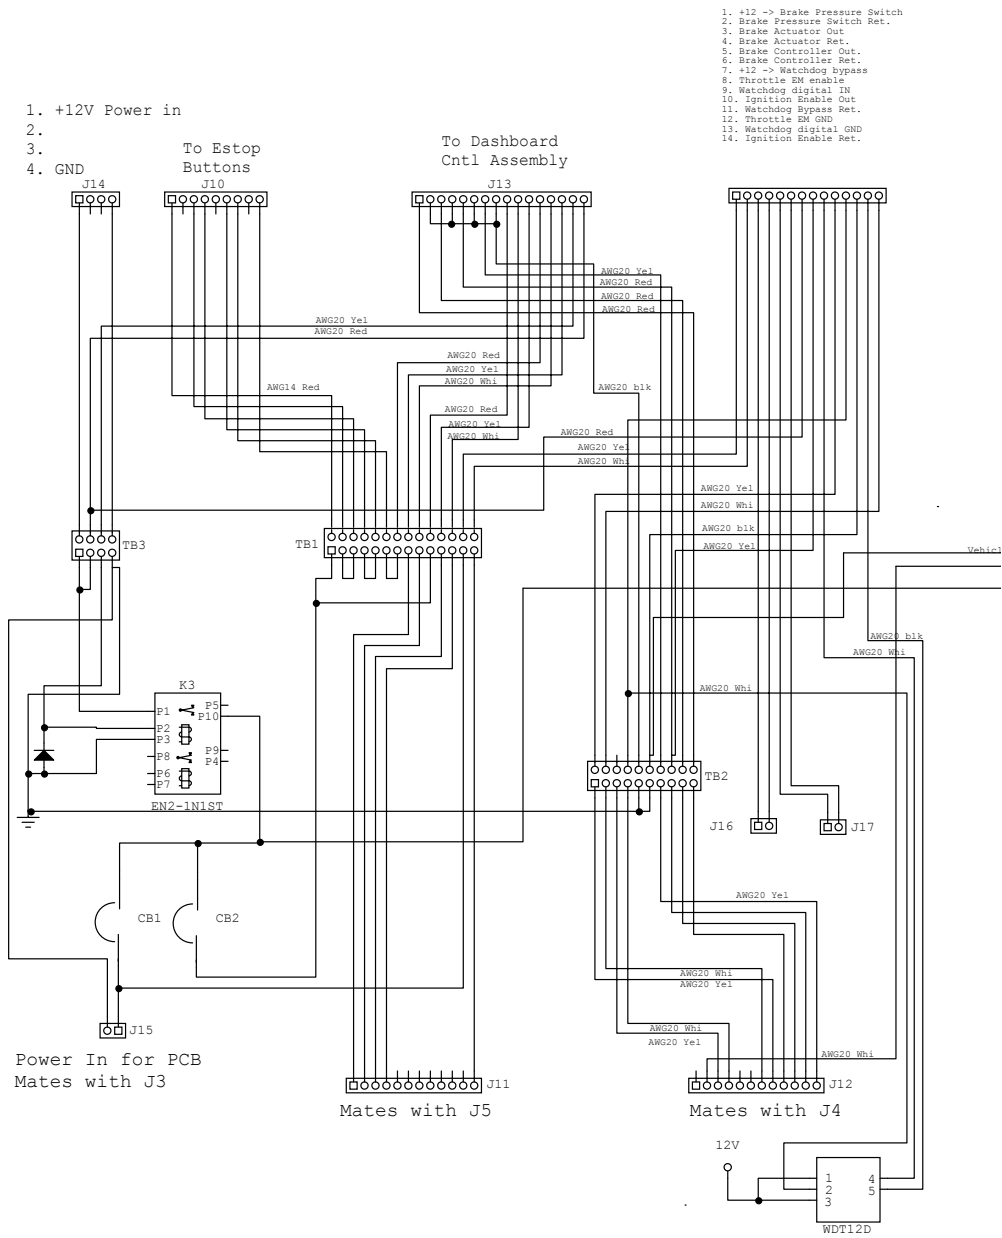
[picture p110: page 3]

1. +12 -> Brake Pressure Switch
2. Brake Pressure Switch Ret.
3. Brake Actuator Out
4. Brake Actuator Ret.
5. Brake Controller Out.
6. Brake Controller Ret.
7. +12 -> Watchdog bypass
8. Throttle EM enable
9. Watchdog digital IN
10. Ignition Enable Out
11. Watchdog Bypass Ret.
12. Throttle EM GND
13. Watchdog digital GND
14. Ignition Enable Ret.

AWG20 Red

AWG20 Yel
AWG20 Whi

AWG20 blk

Power In for PCB
Mates with J3

# To DARPA box 16 Pin Amp CPC

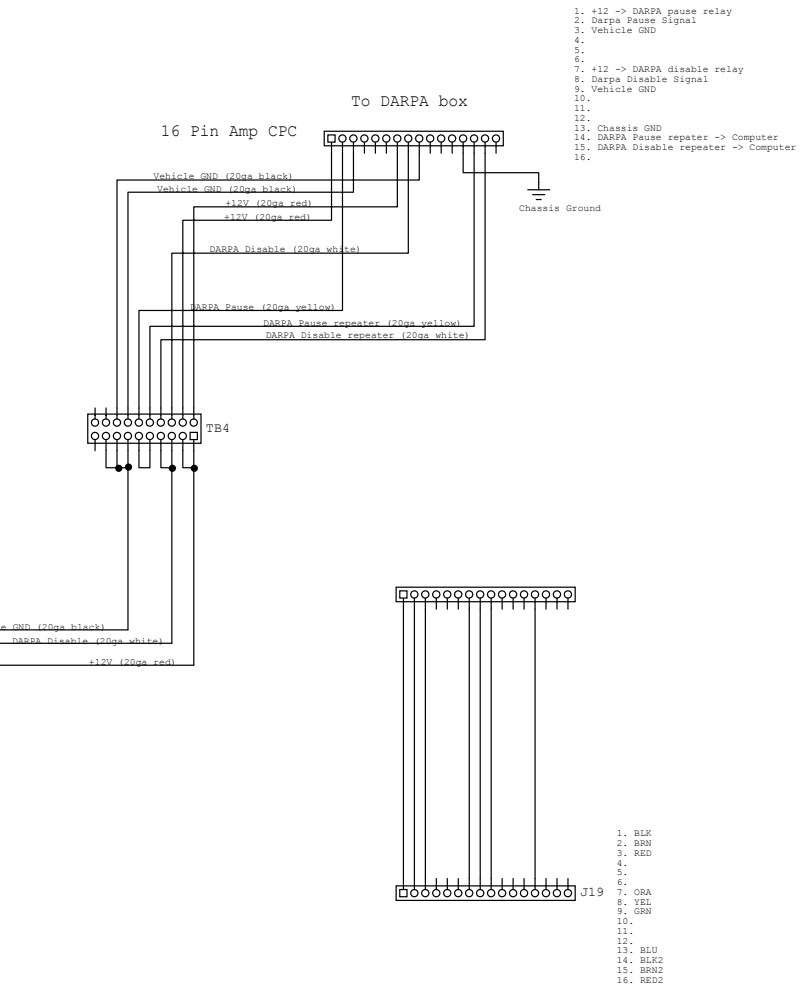
[picture p111: page 4]
+12V (20ga red); Chassis Ground; 1. BLK 2. BRN 3. RED 4. 5. 6. 7. ORA 8. YEL 9. GRN 10. 11. 12. 13. BLU 14. BLK2 15. BRN2 16. RED2

1. +12 -> DARPA pause relay
2. Darpa Pause Signal
3. Vehicle GND
7. +12 -> DARPA disable relay
8. Darpa Disable Signal
9. Vehicle GND
13. Chassis GND
14. DARPA Pause repater -> Computer
15. DARPA Disable repeater -> Computer

Vehicle GND (20ga black)

+12V (20ga red)

DARPA Disable (20ga white)

DARPA Pause (20ga yellow)

DARPA Pause repeater (20ga yellow)
DARPA Disable repeater (20ga white)

le GND (20ga black)
