John-Nagle/Overbot/gc/parts/estop/secondversion/EstopBoardRev2Intern#13609E.pdf

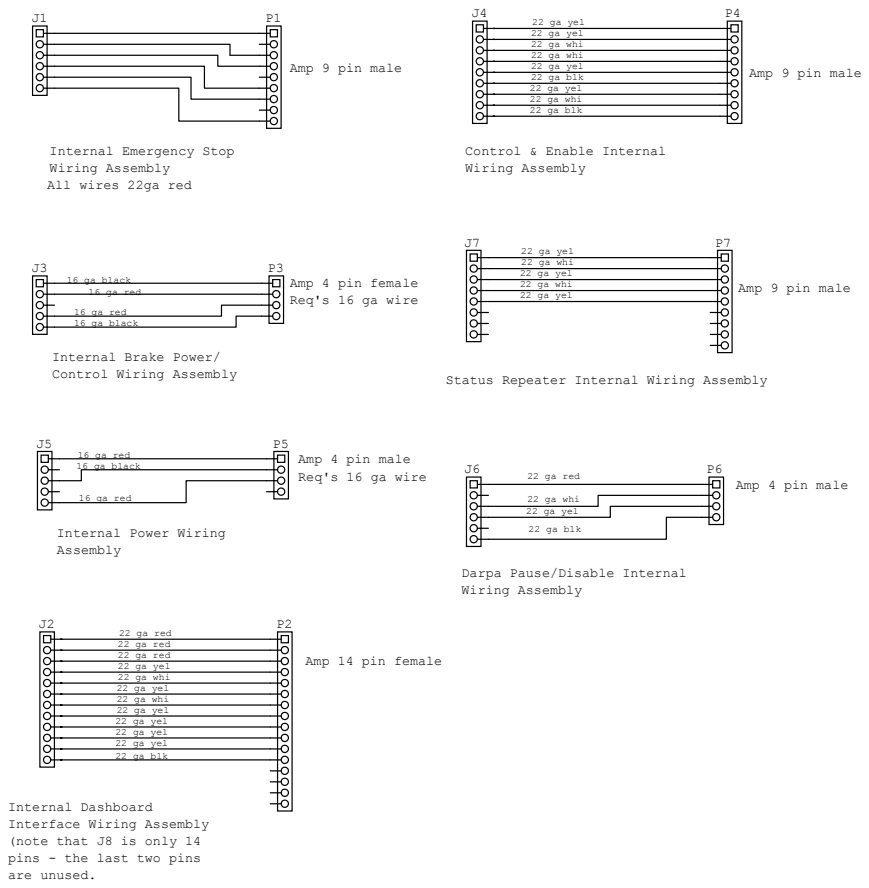
[picture p115: page 1]

Amp 9 pin male

Status Repeater Internal Wiring Assembly

Darpa Pause/Disable Internal
Wiring Assembly

Internal Dashboard
Interface Wiring Assembly
(note that J8 is only 14
pins - the last two pins
are unused.
