John-Nagle/Overbot/gc/parts/estop/secondversion/EstopBoardRev2Nov04_2.pdf

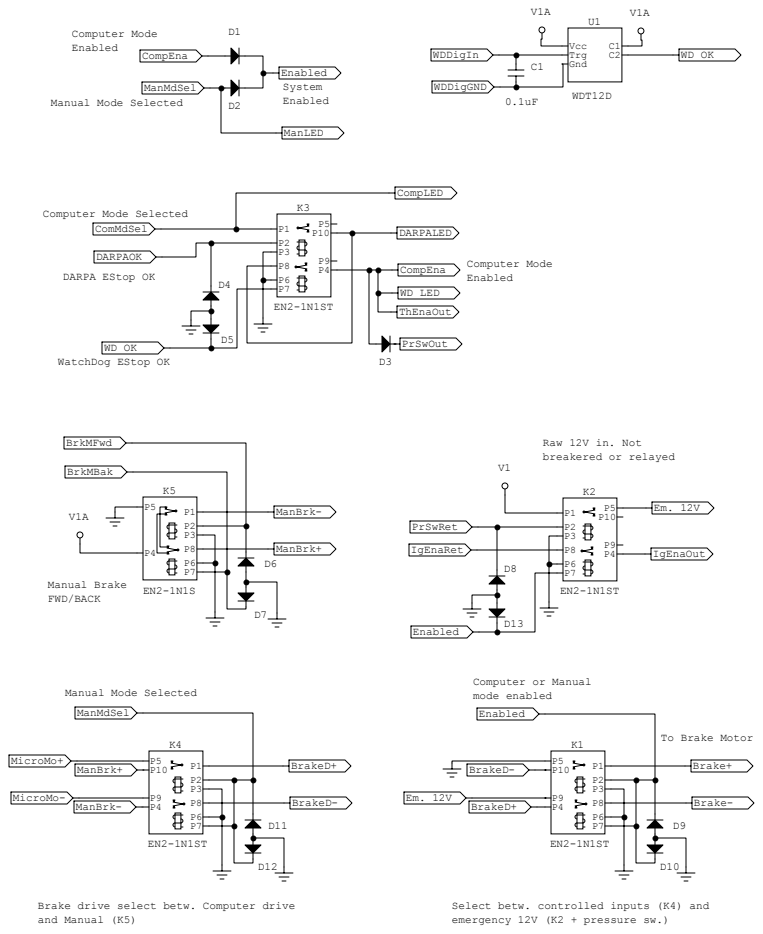
[picture p116: page 1]

Brake drive select betw. Computer drive
and Manual (K5)

Select betw. controlled inputs (K4) and
emergency 12V (K2 + pressure sw.)

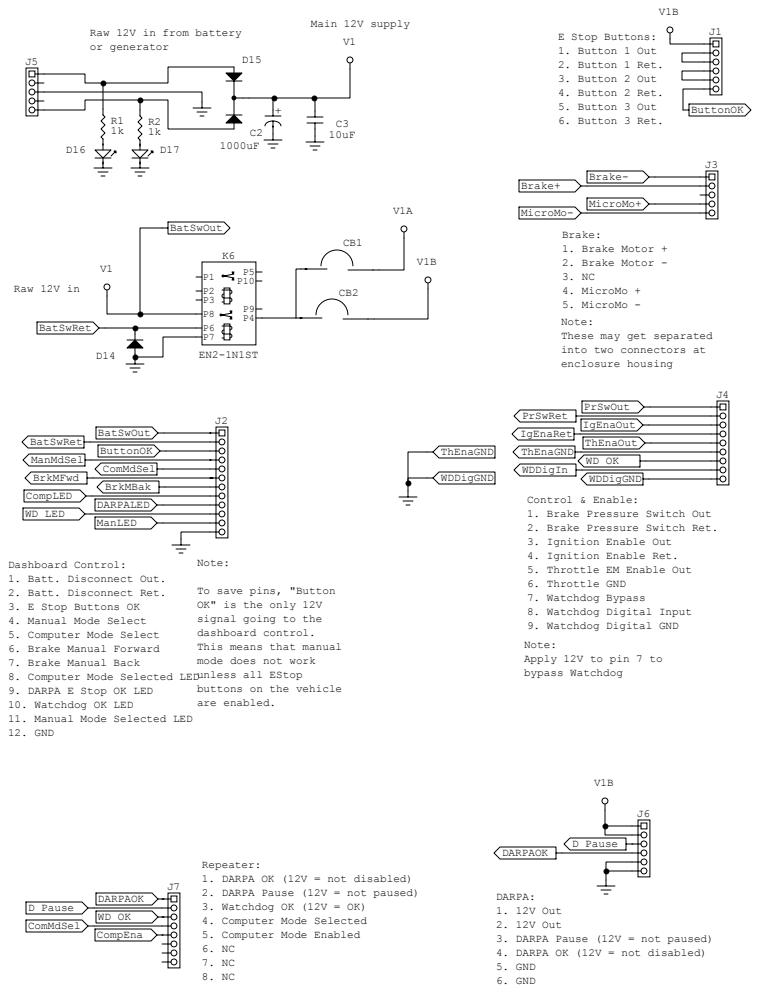
[picture p117: page 2]

Raw 12V in from battery
or generator

Control & Enable:
1. Brake Pressure Switch Out
2. Brake Pressure Switch Ret.
3. Ignition Enable Out
4. Ignition Enable Ret.
5. Throttle EM Enable Out
6. Throttle GND
7. Watchdog Bypass
8. Watchdog Digital Input
9. Watchdog Digital GND
Note:
Apply 12V to pin 7 to
bypass Watchdog

Dashboard Control:
1. Batt. Disconnect Out.
2. Batt. Disconnect Ret.
3. E Stop Buttons OK
4. Manual Mode Select
5. Computer Mode Select
6. Brake Manual Forward
7. Brake Manual Back
8. Computer Mode Selected LED
9. DARPA E Stop OK LED
10. Watchdog OK LED
11. Manual Mode Selected LED
12. GND

To save pins, "Button
OK" is the only 12V
signal going to the
dashboard control.
This means that manual
mode does not work
unless all EStop
buttons on the vehicle
are enabled.

Repeater:
1. DARPA OK (12V = not disabled)
2. DARPA Pause (12V = not paused)
3. Watchdog OK (12V = OK)
4. Computer Mode Selected
5. Computer Mode Enabled
