John-Nagle/Overbot/gc/system/milestones/sensorsclientserver.pdf

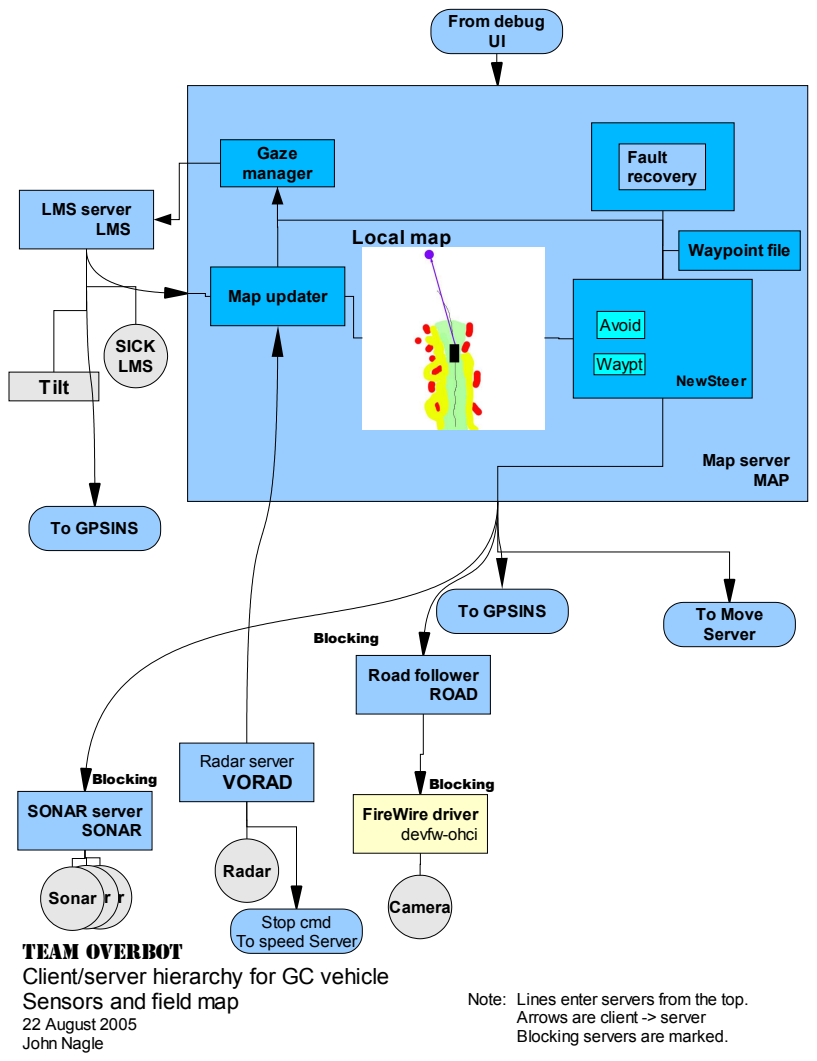
[picture p118: page 1]
Tilt; Camera; From debug UI; Road follower ROAD; FireWire driver devfw-ohci; Blocking; To GPSINS; SONAR server SONAR; SICK LMS; LMS server LMS; NewSteer; Waypt; Avoid; Local map; Map updater; To Move Server; Waypoint file; Radar; Radar server VORAD; Fault recovery; Gaze manager; Map server MAP

SoSnoanrar
Sonar
TEAM OVERBOT
Client/server hierarchy for GC vehicle
Sensors and field map
22 August 2005
John Nagle

Stop cmd
To speed Server

Note: Lines enter servers from the top.
Arrows are client -> server
Blocking servers are marked.
