John-Nagle/Overbot/gc/system/milestones/singlelinemain.pdf

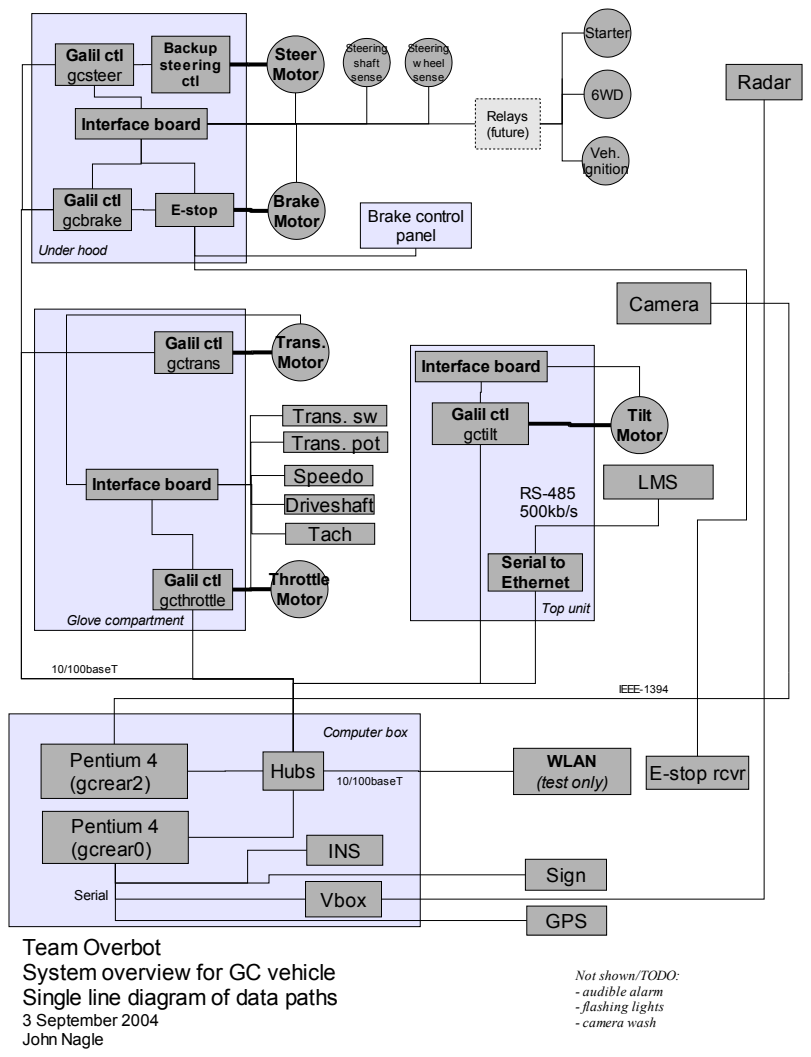
[picture p119: page 1]
Galil ctl gcthrottle; Pentium 4 (gcrear0); Pentium 4 (gcrear2); Hubs; LMS; Sign; Camera; Speedo; Tach; Driveshaft; IEEE-1394; 10/100baseT; WLAN (test only); Veh. Ignition; Starter; E-stop; Radar; INS; GPS; Galil ctl gcbrake; Galil ctl gctilt; Galil ctl gcsteer; Galil ctl gctrans; Vbox; E-stop rcvr; Serial to Ethernet; Interface board; Tilt Motor; Trans. Motor; Throttle Motor; Steer Motor; Brake Motor; Trans. pot; Trans. sw; Backup steering ctl; Serial; Under hood; Glove compartment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

Team Overbot
System overview for GC vehicle
Single line diagram of data paths
3 September 2004
John Nagle

Not shown/TODO:
- audible alarm
- flashing lights
- camera wash
