John-Nagle/Overbot/gc/parts/estop/BoardRev2BL.pdf

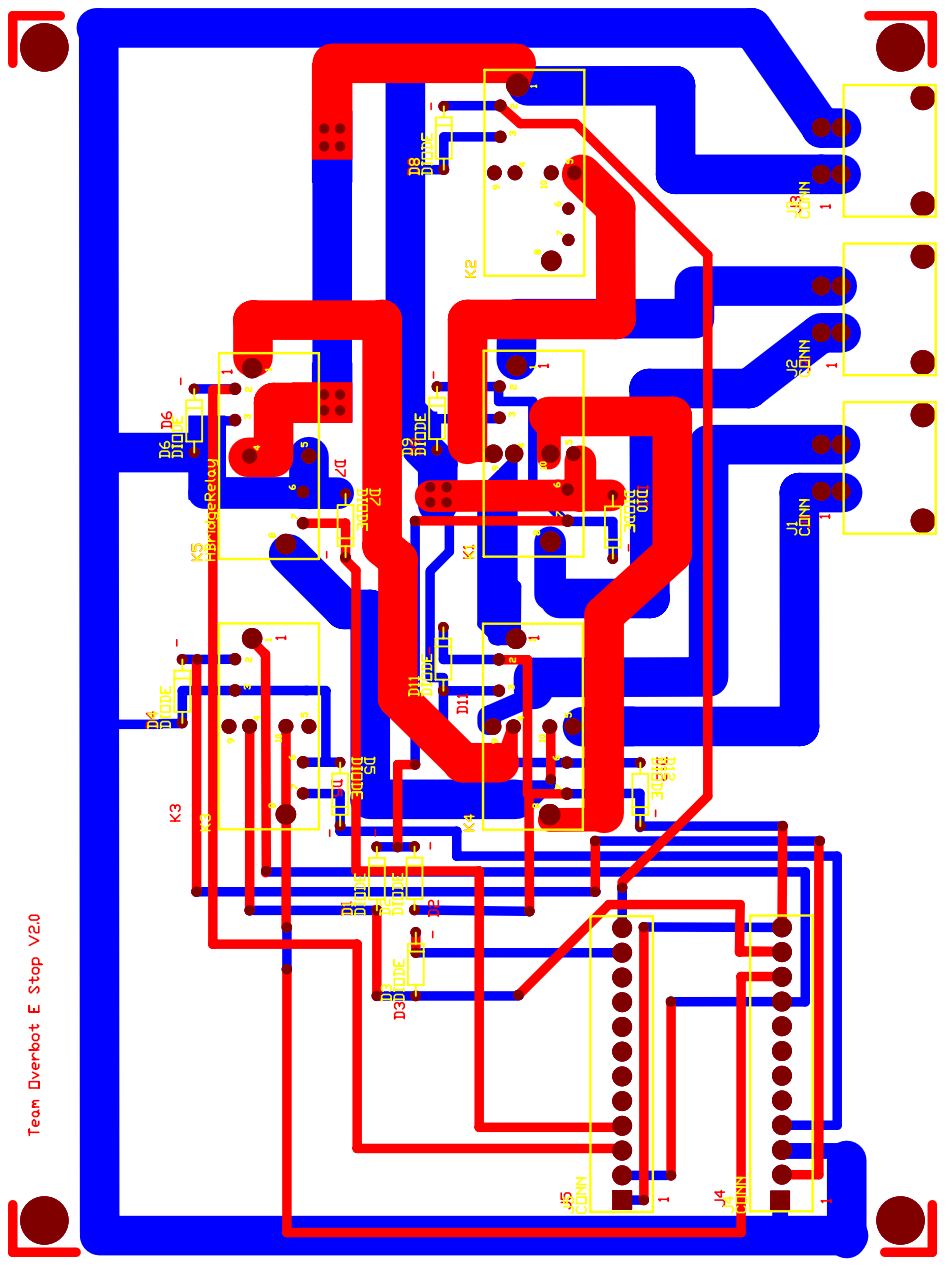
[picture p120: page 1]
