John-Nagle/Overbot/gc/parts/motion_control/galil_icm1460_schematic.pdf

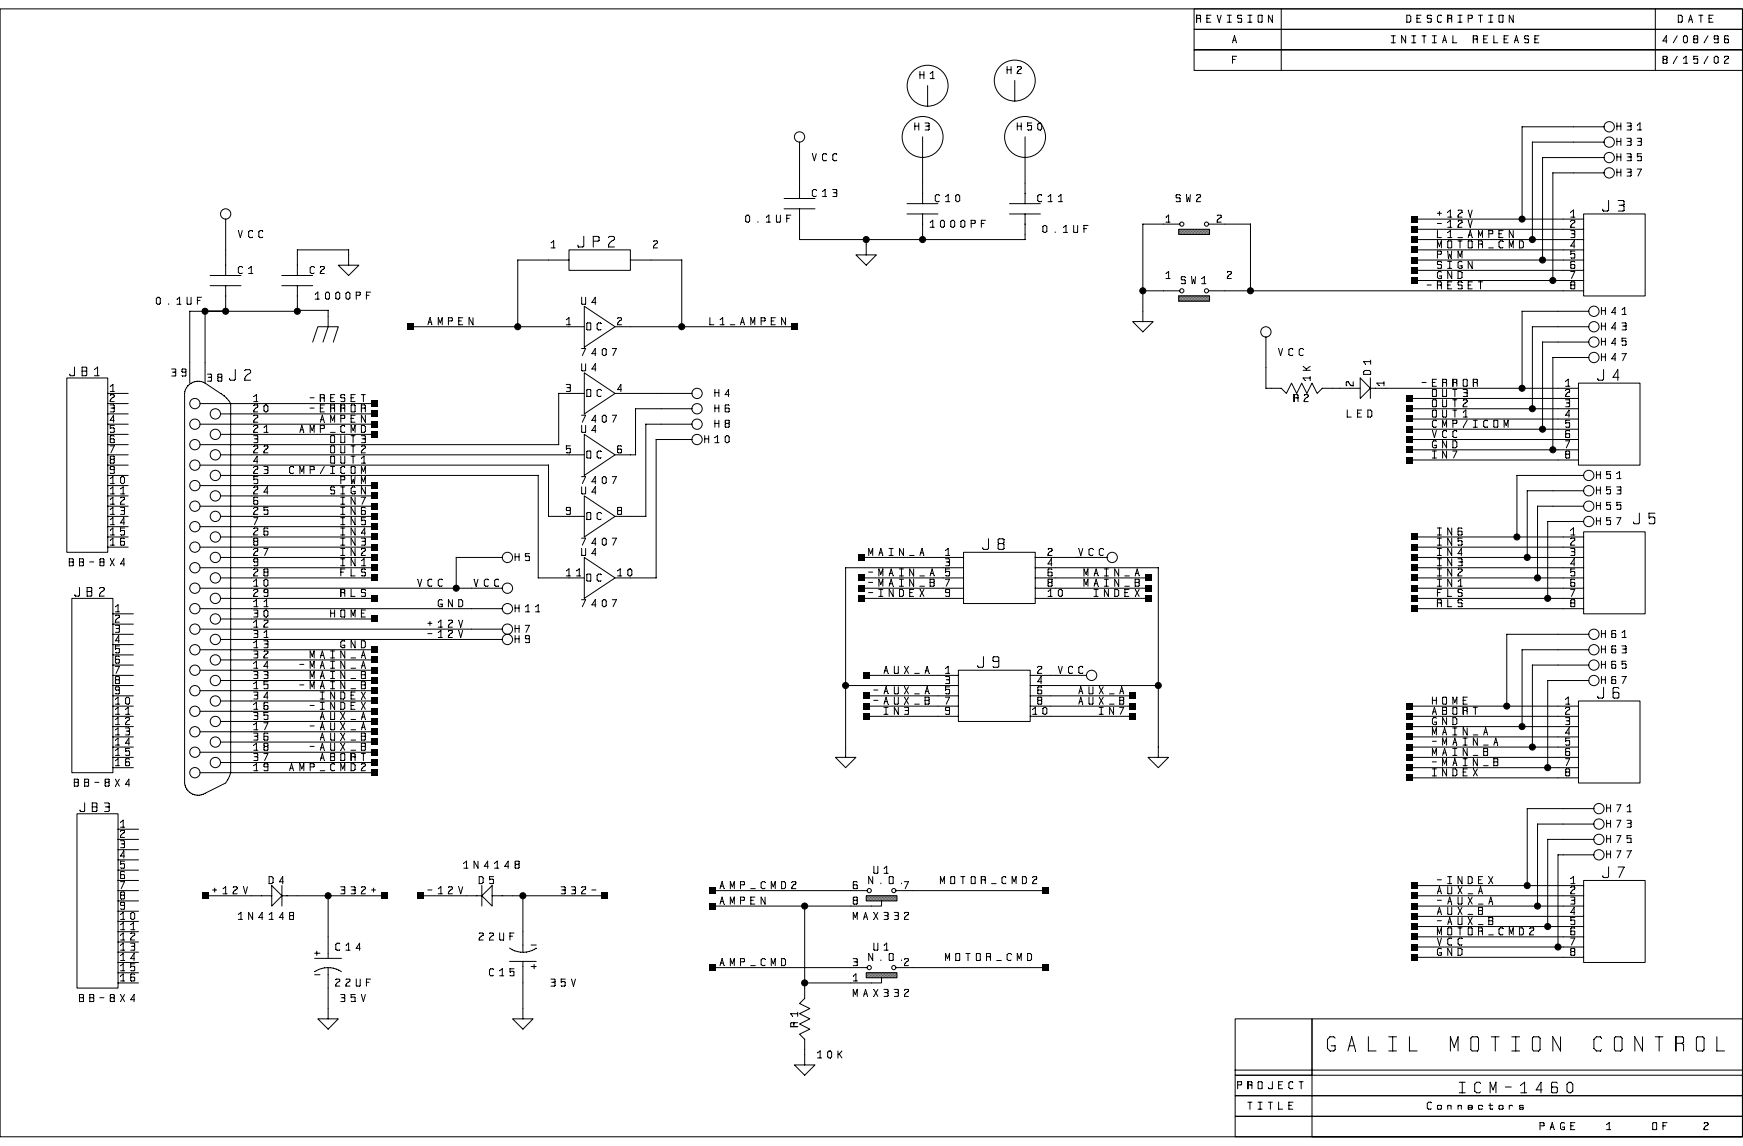
[picture p121: page 1]

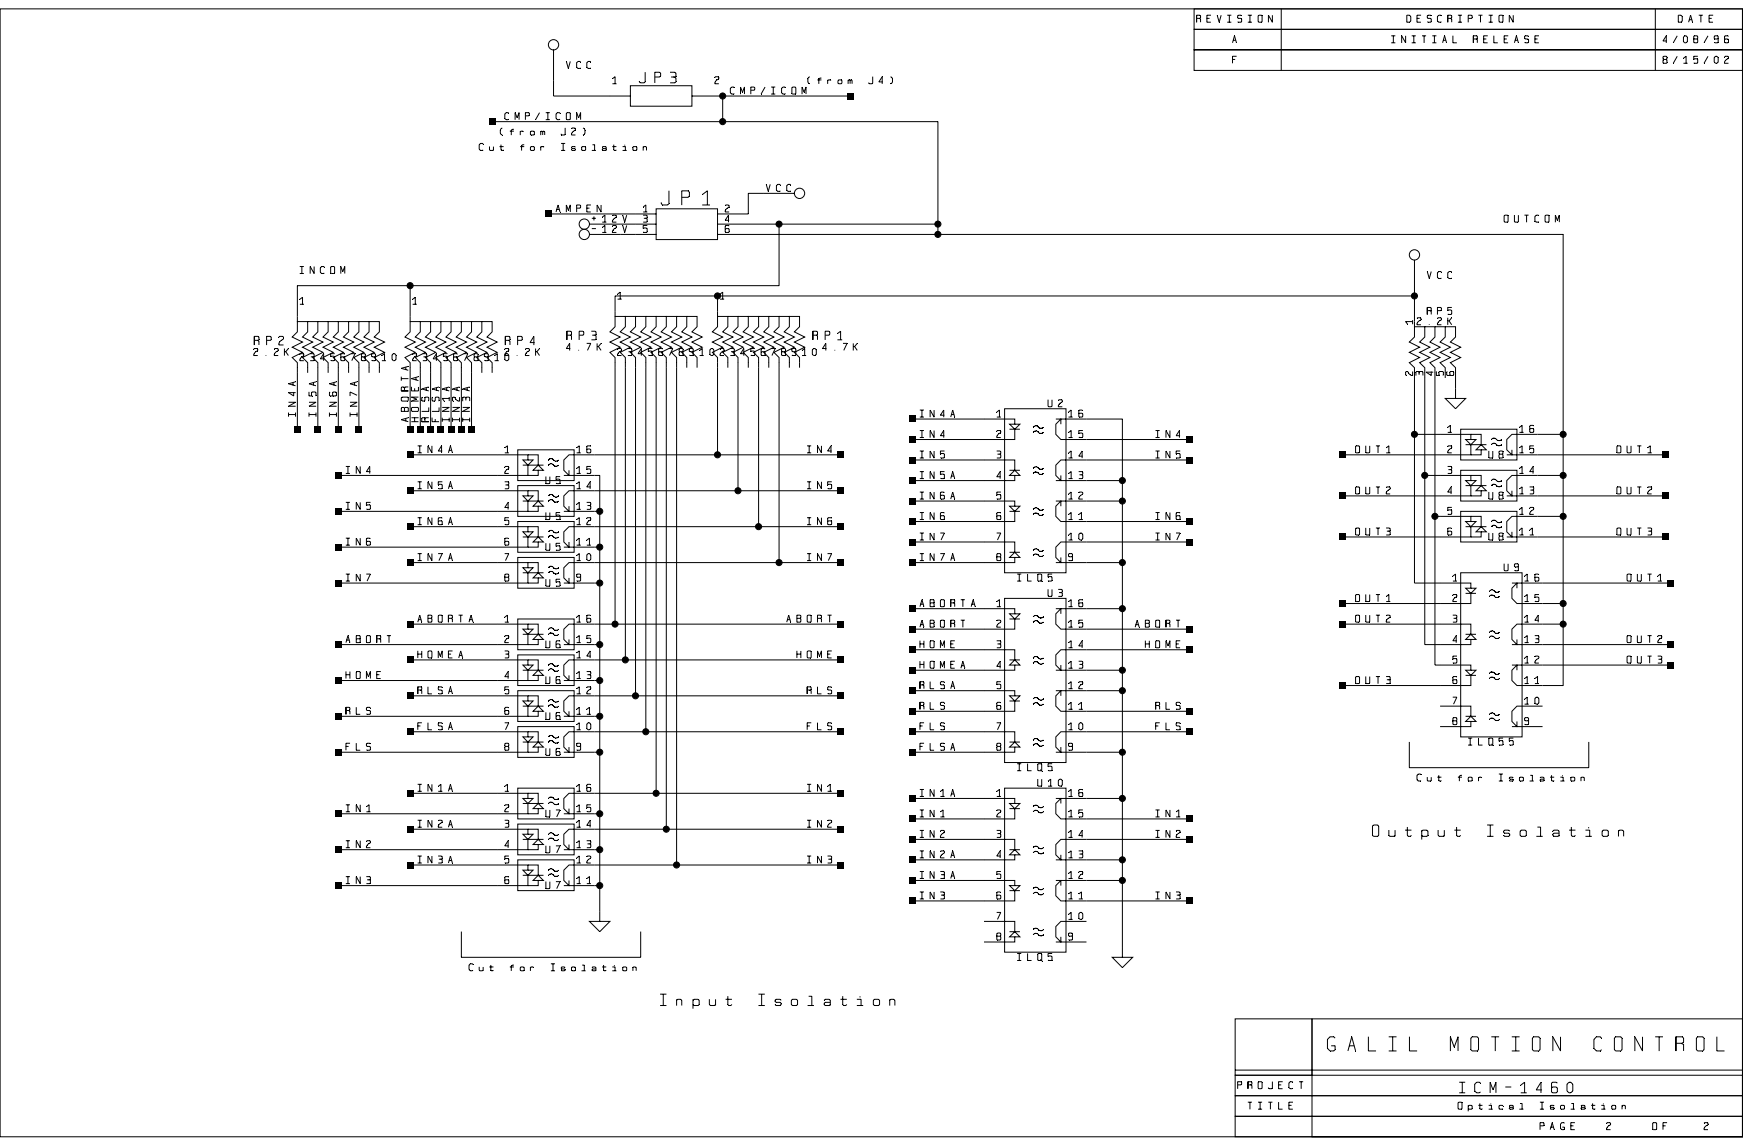
[picture p122: page 2]
