John-Nagle/Overbot/gc/parts/smallparts/ieccordretentionclip.pdf

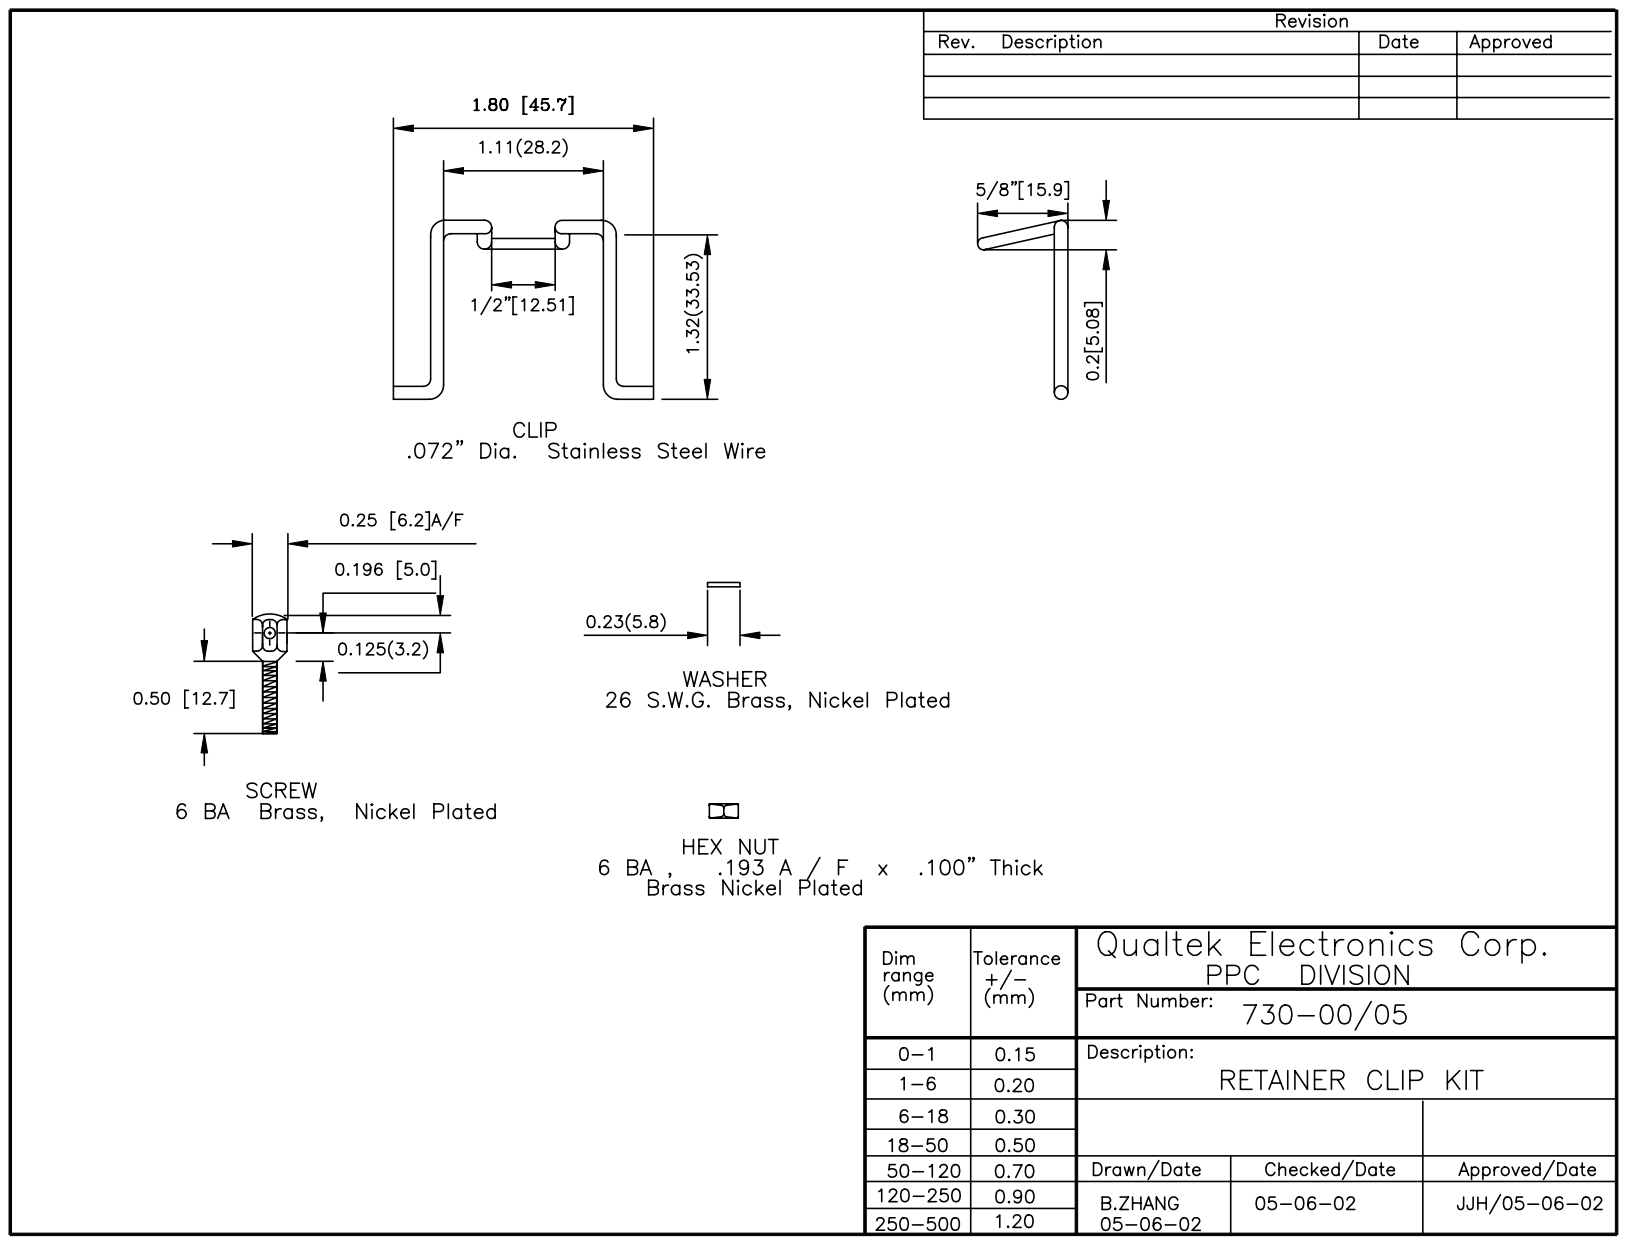
[picture p123: page 1]
