John-Nagle/Overbot/gc/drawings/parts/sensormounting/newmarkmotor.pdf

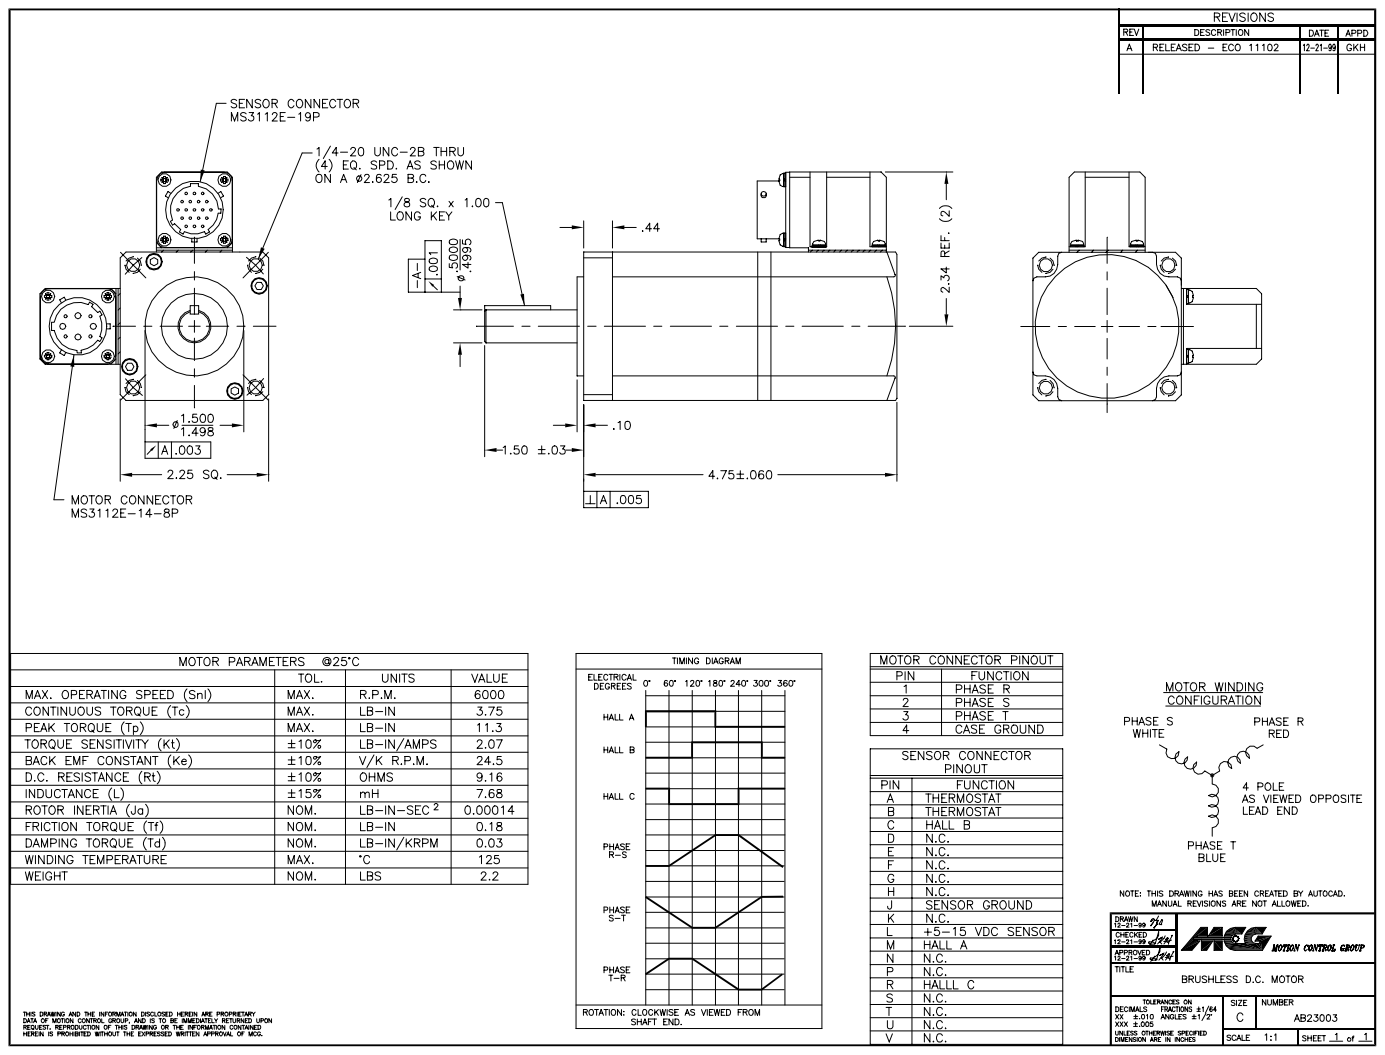
[picture p124: page 1]
