John-Nagle/Overbot/gc/parts/throttle/boardlayout/GCThrottle_SCH.pdf

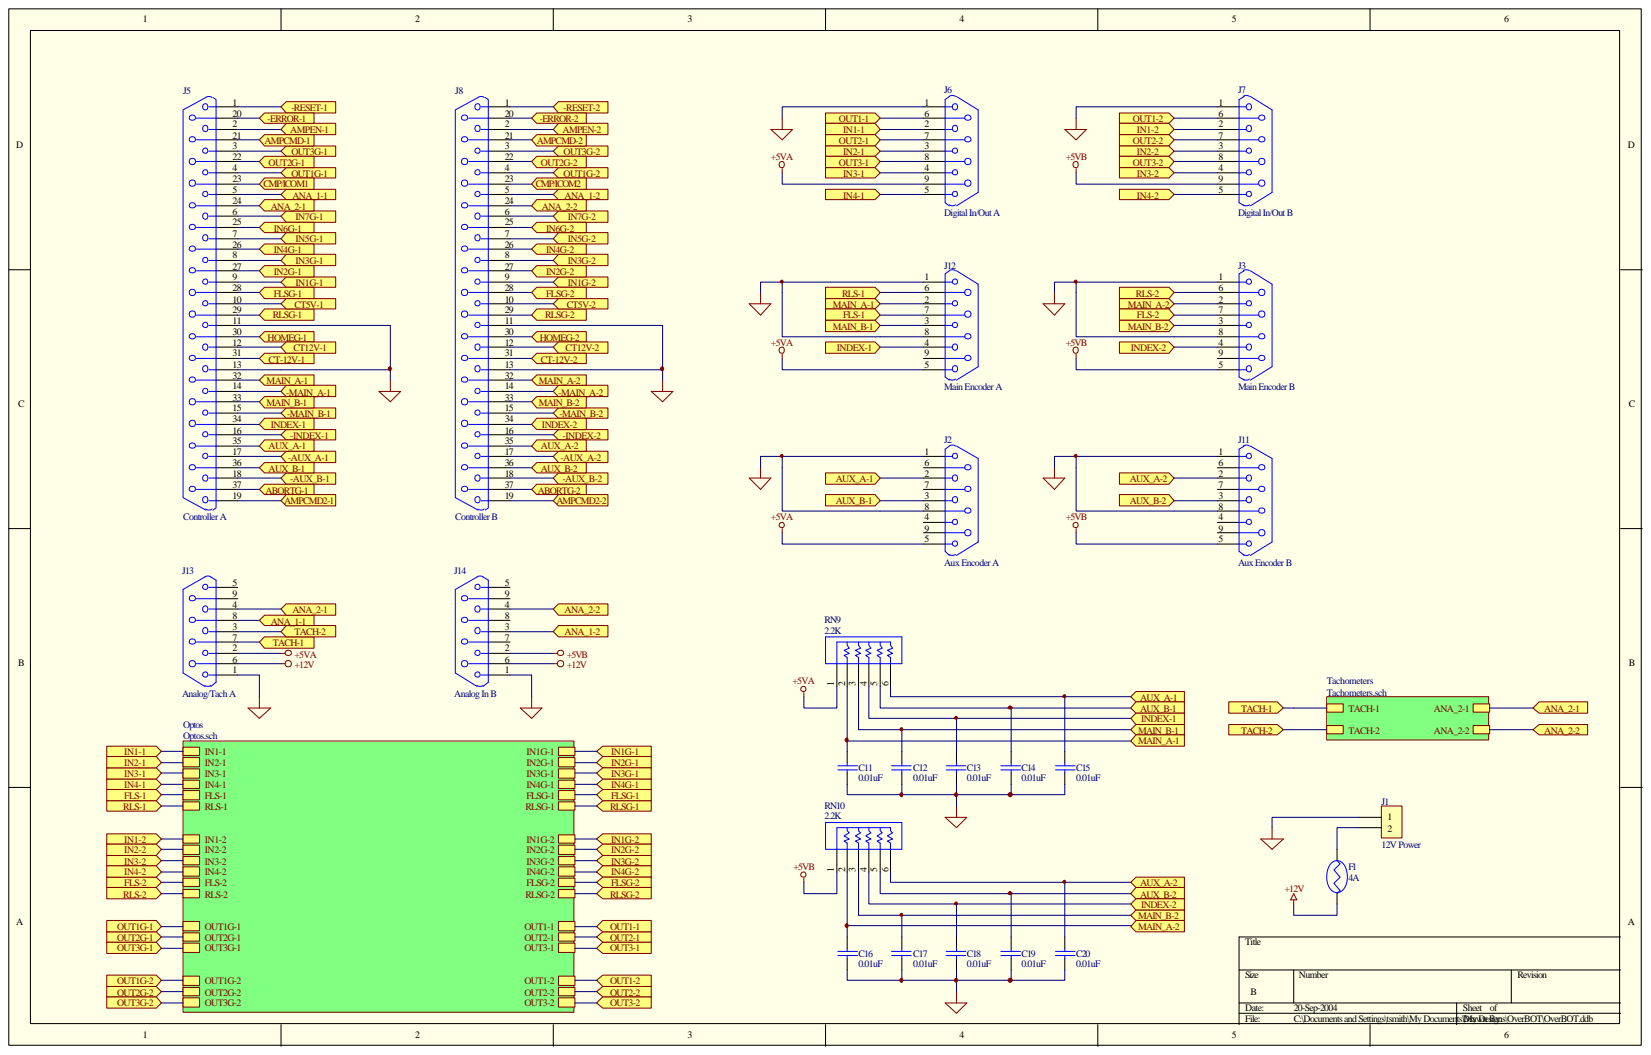
[picture p125: page 1]

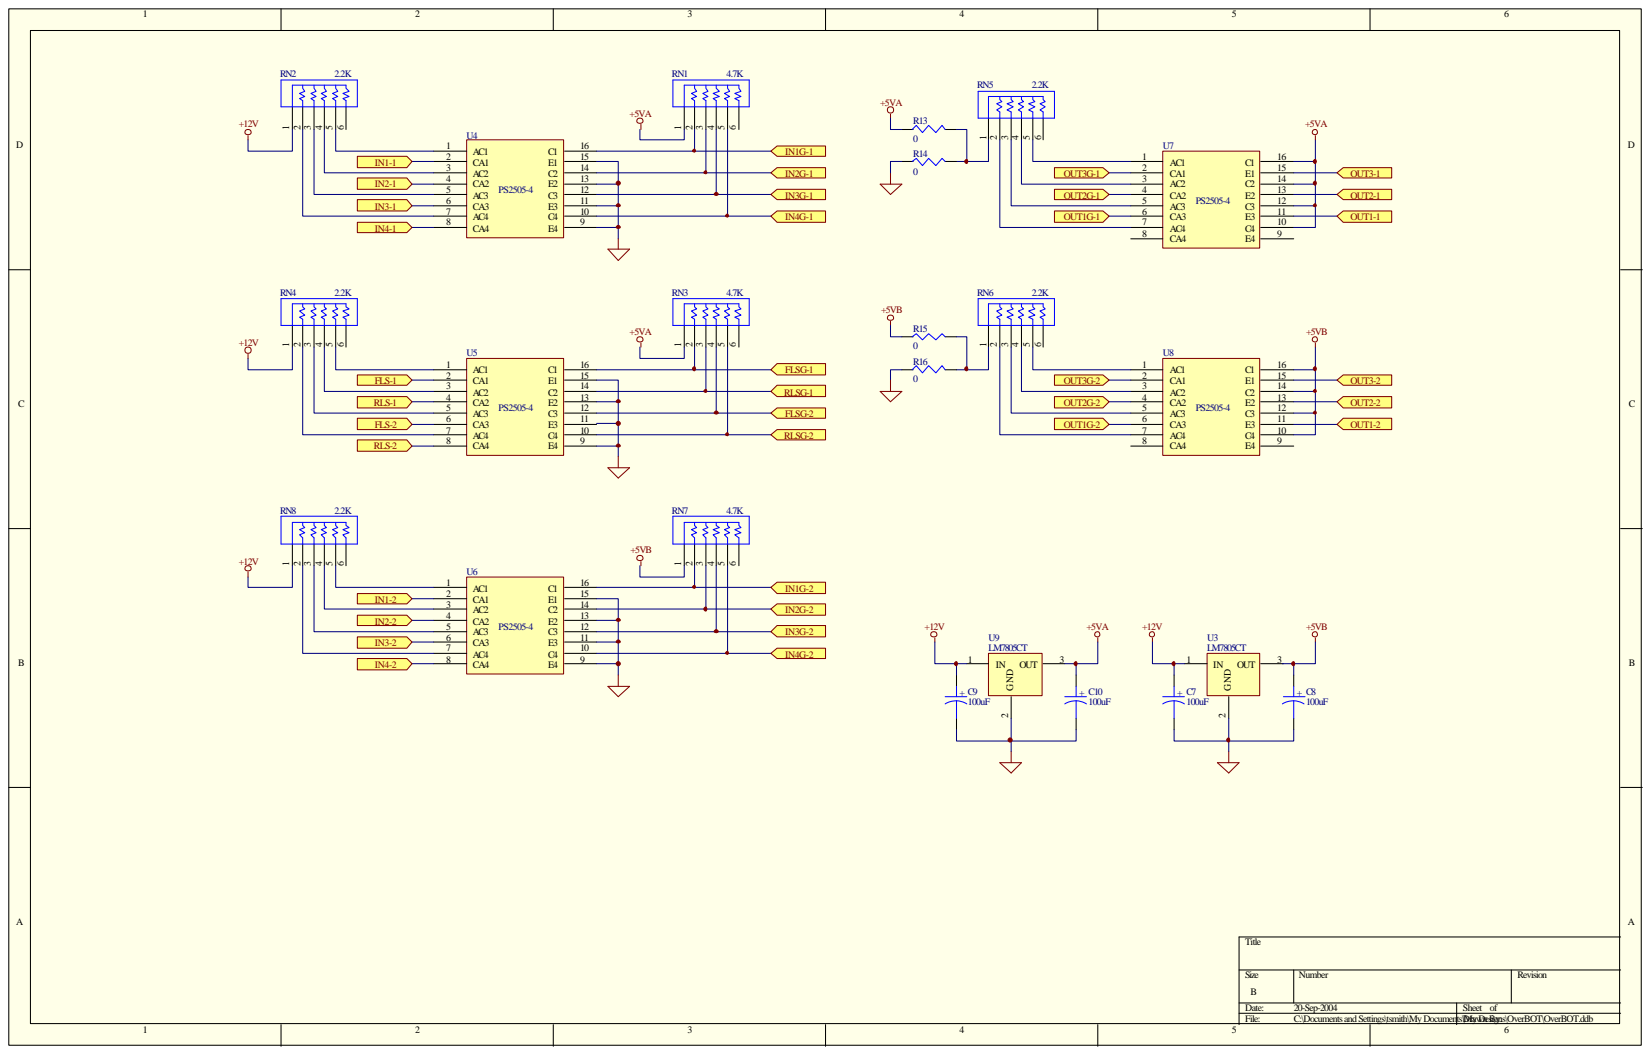
[picture p126: page 2]

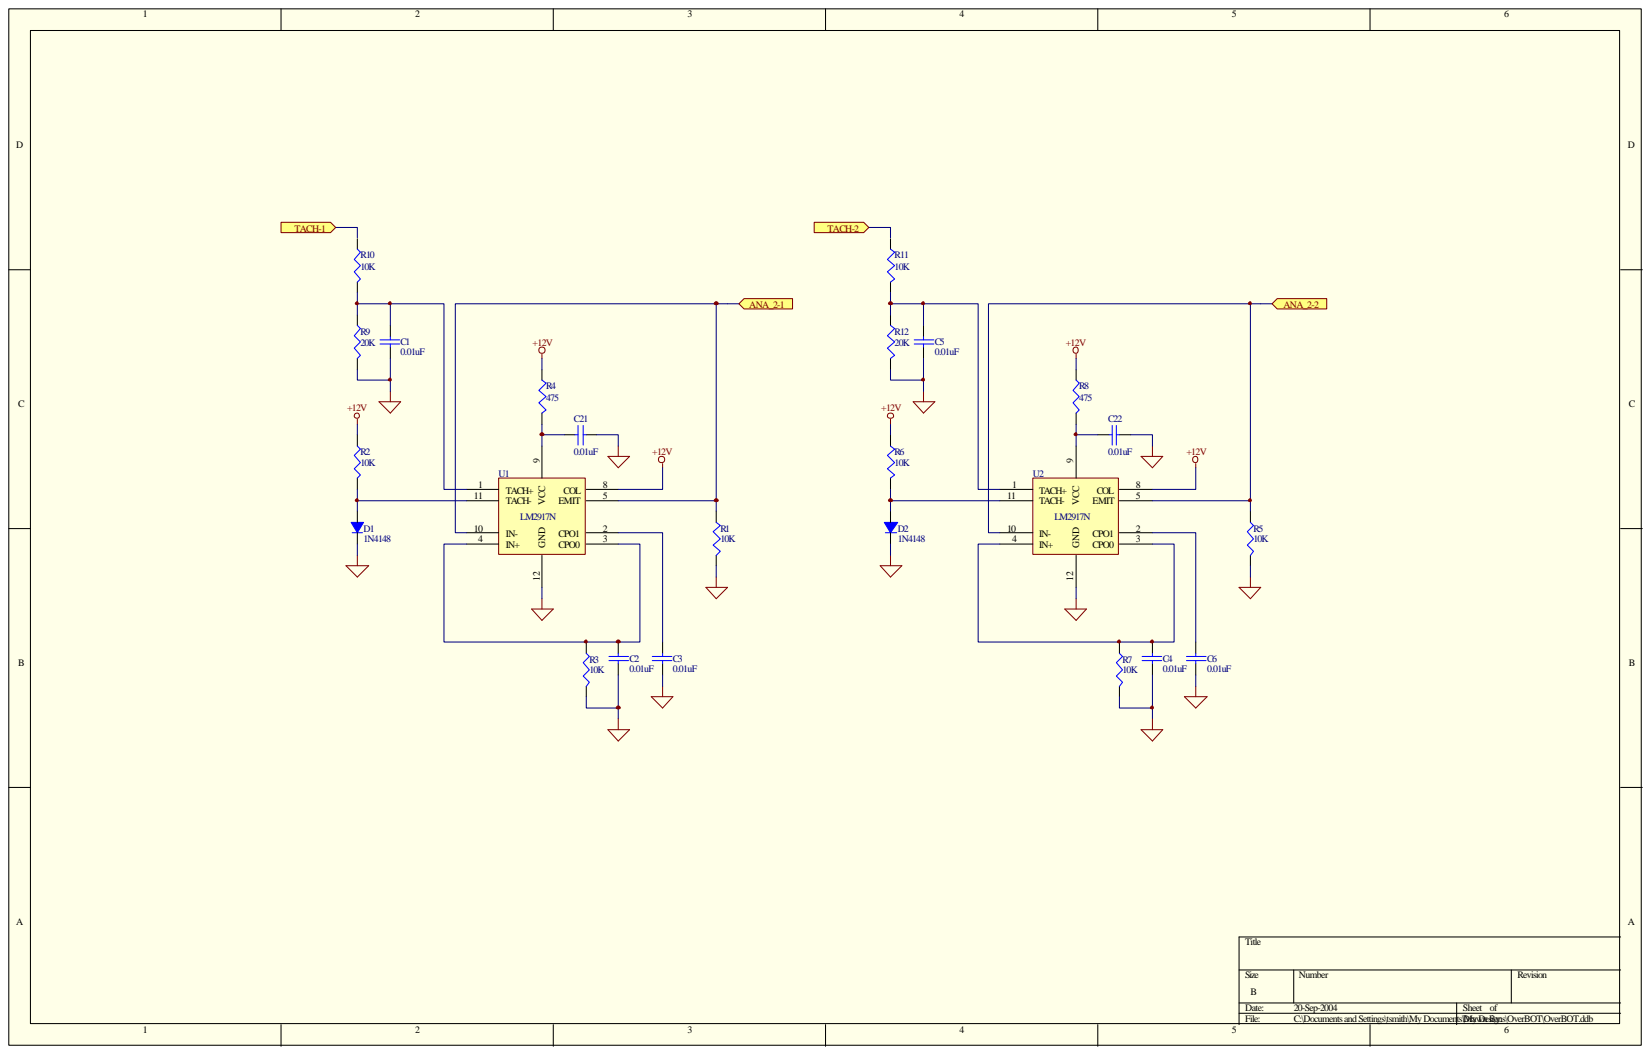
[picture p127: page 3]
