John-Nagle/Overbot/gc/parts/throttle/boardlayout/GIU_R1.pdf

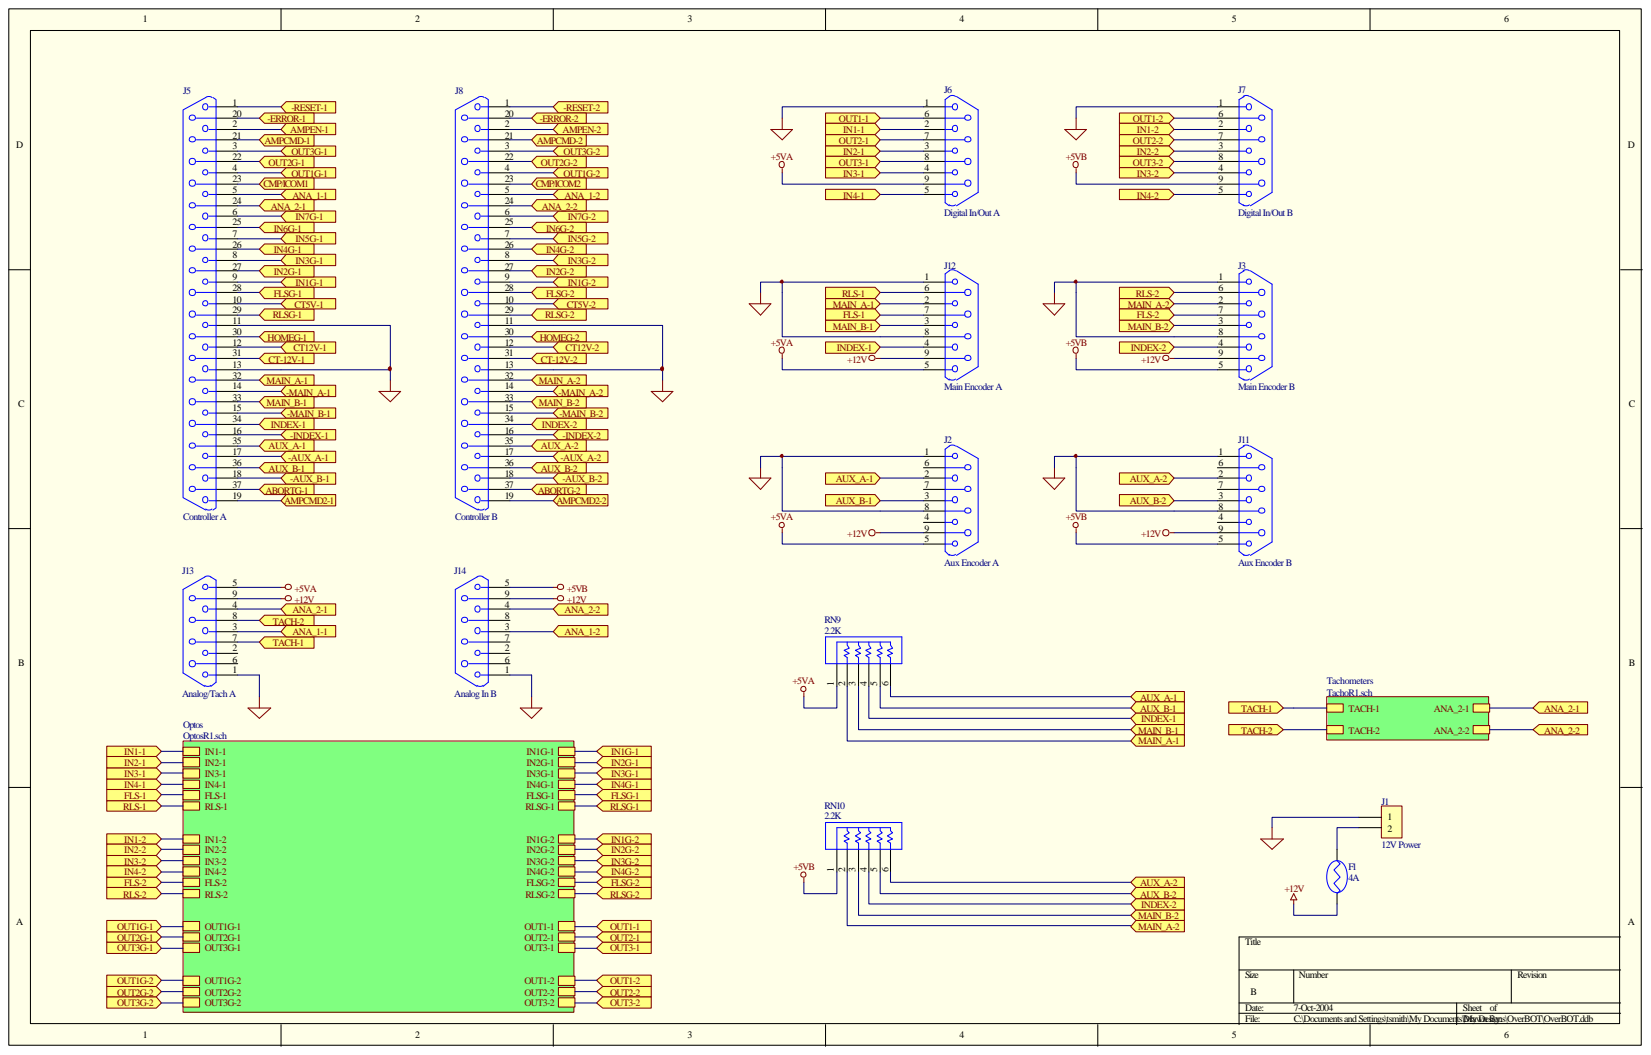
[picture p128: page 1]

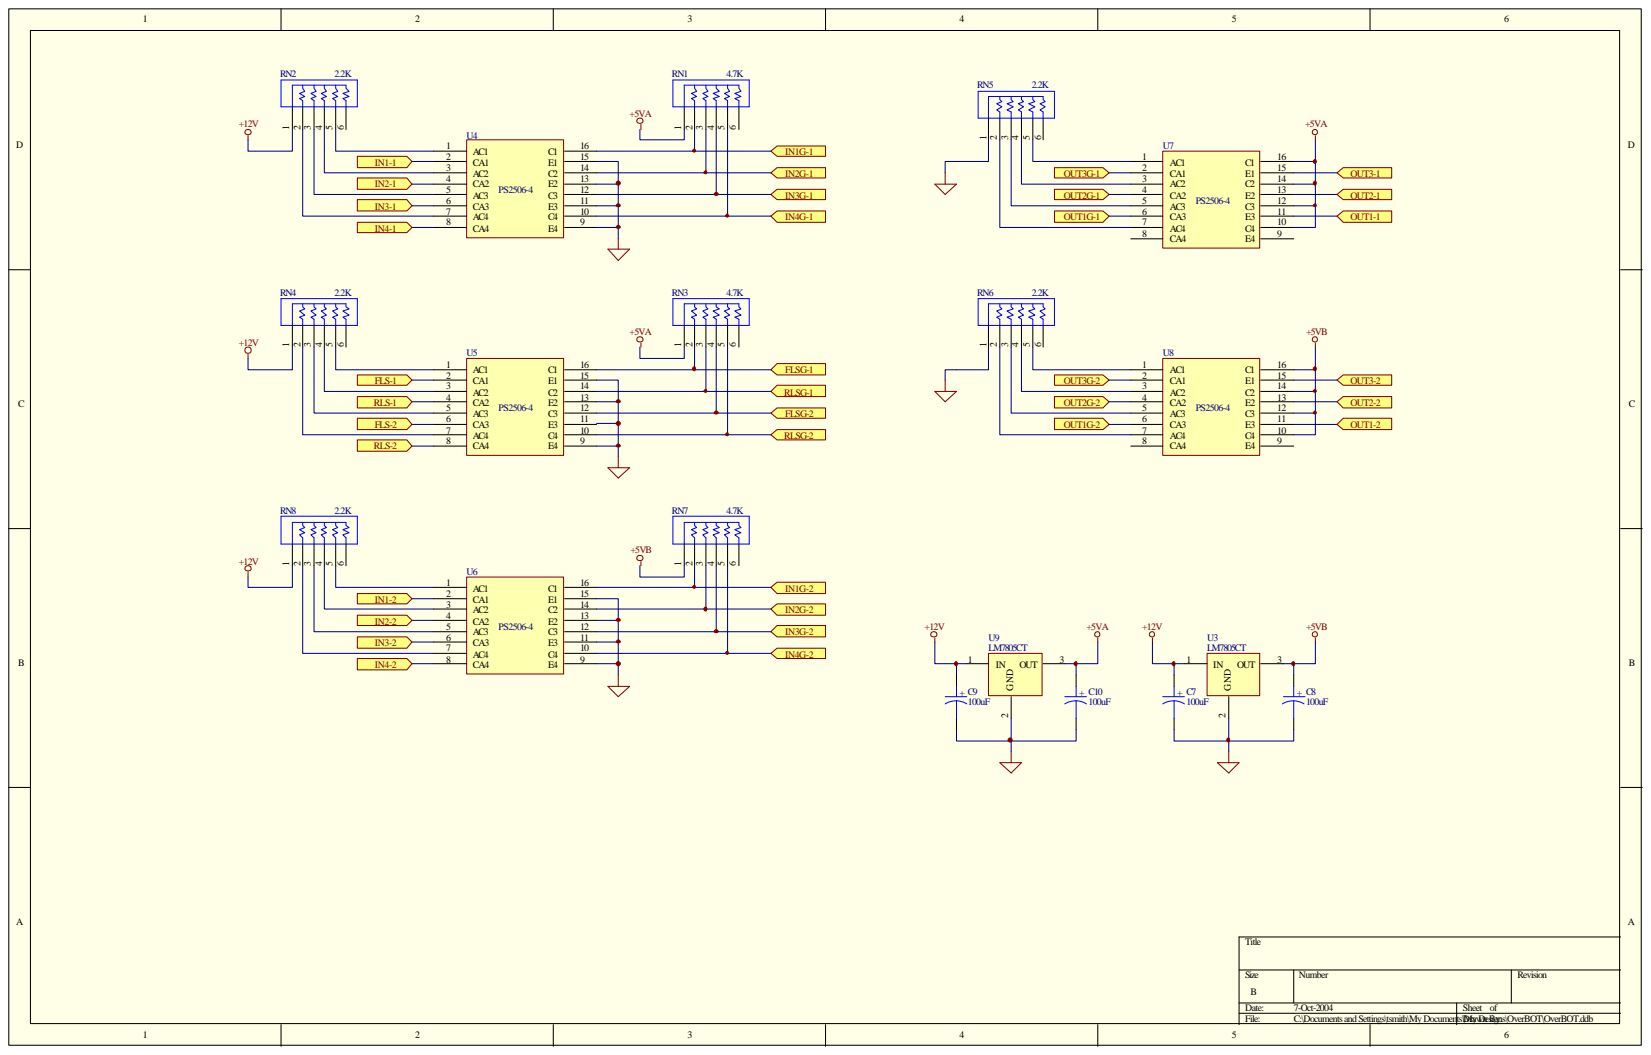
[picture p129: page 2]

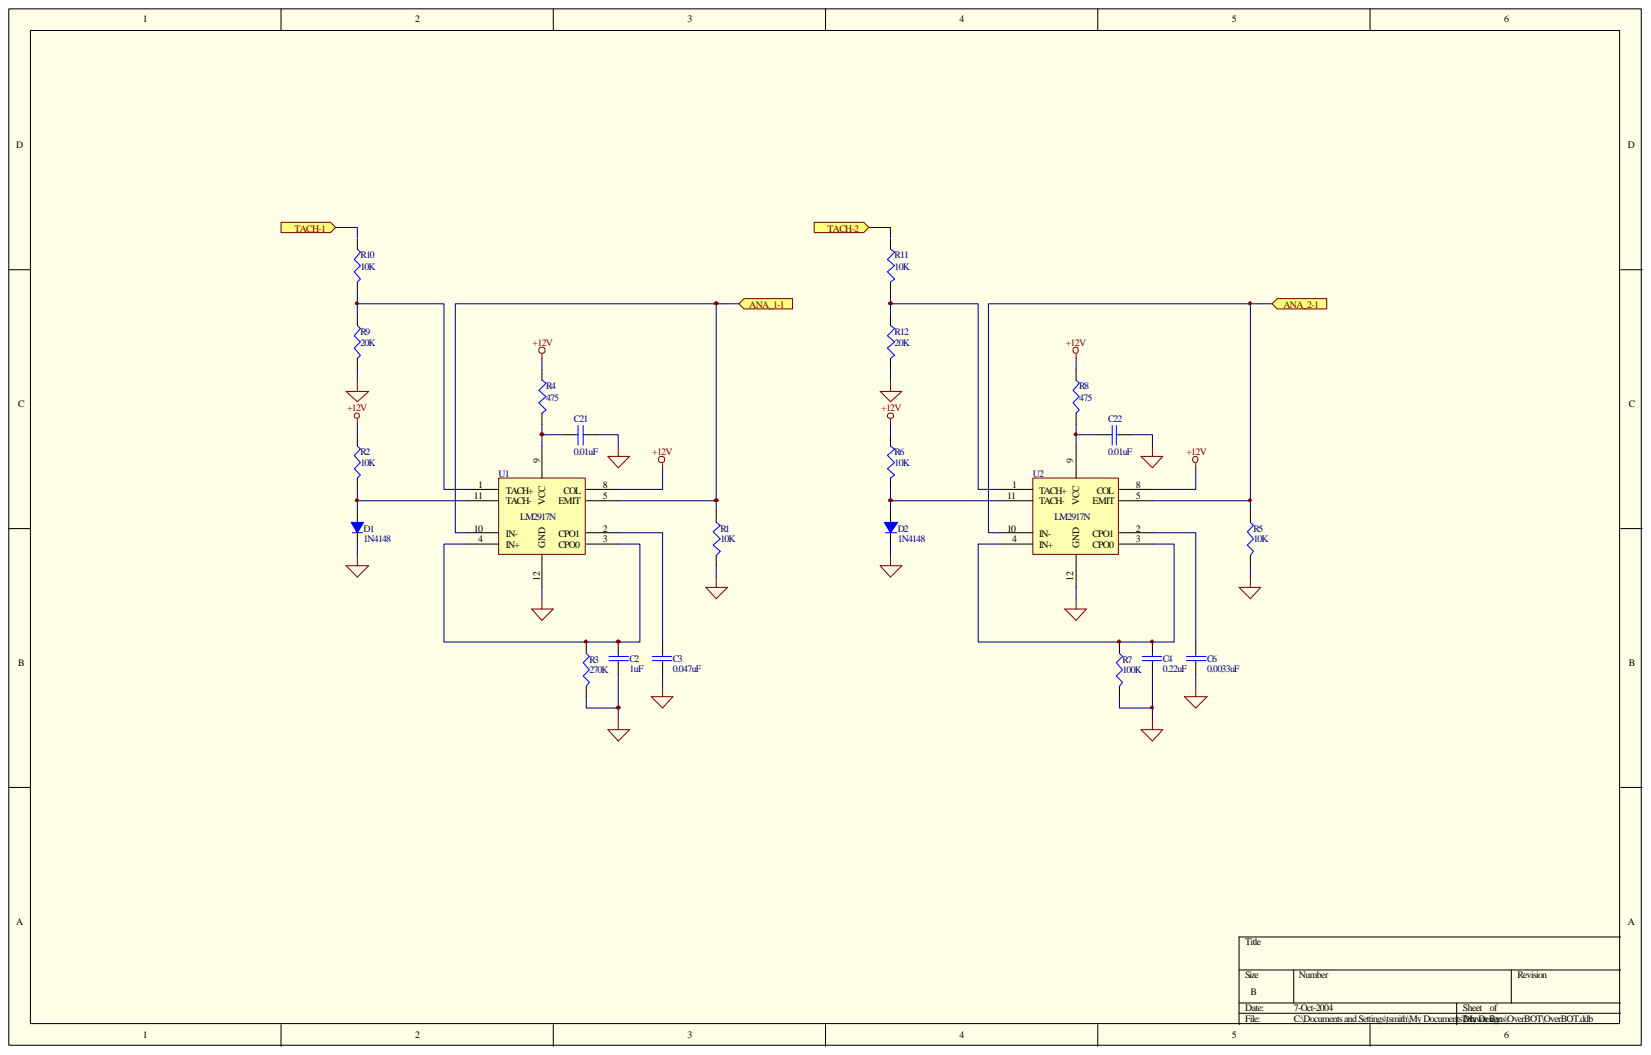
[picture p130: page 3]
