John-Nagle/Overbot/gc/parts/throttle/boardlayout/GIU_R1_BOTTOM.pdf

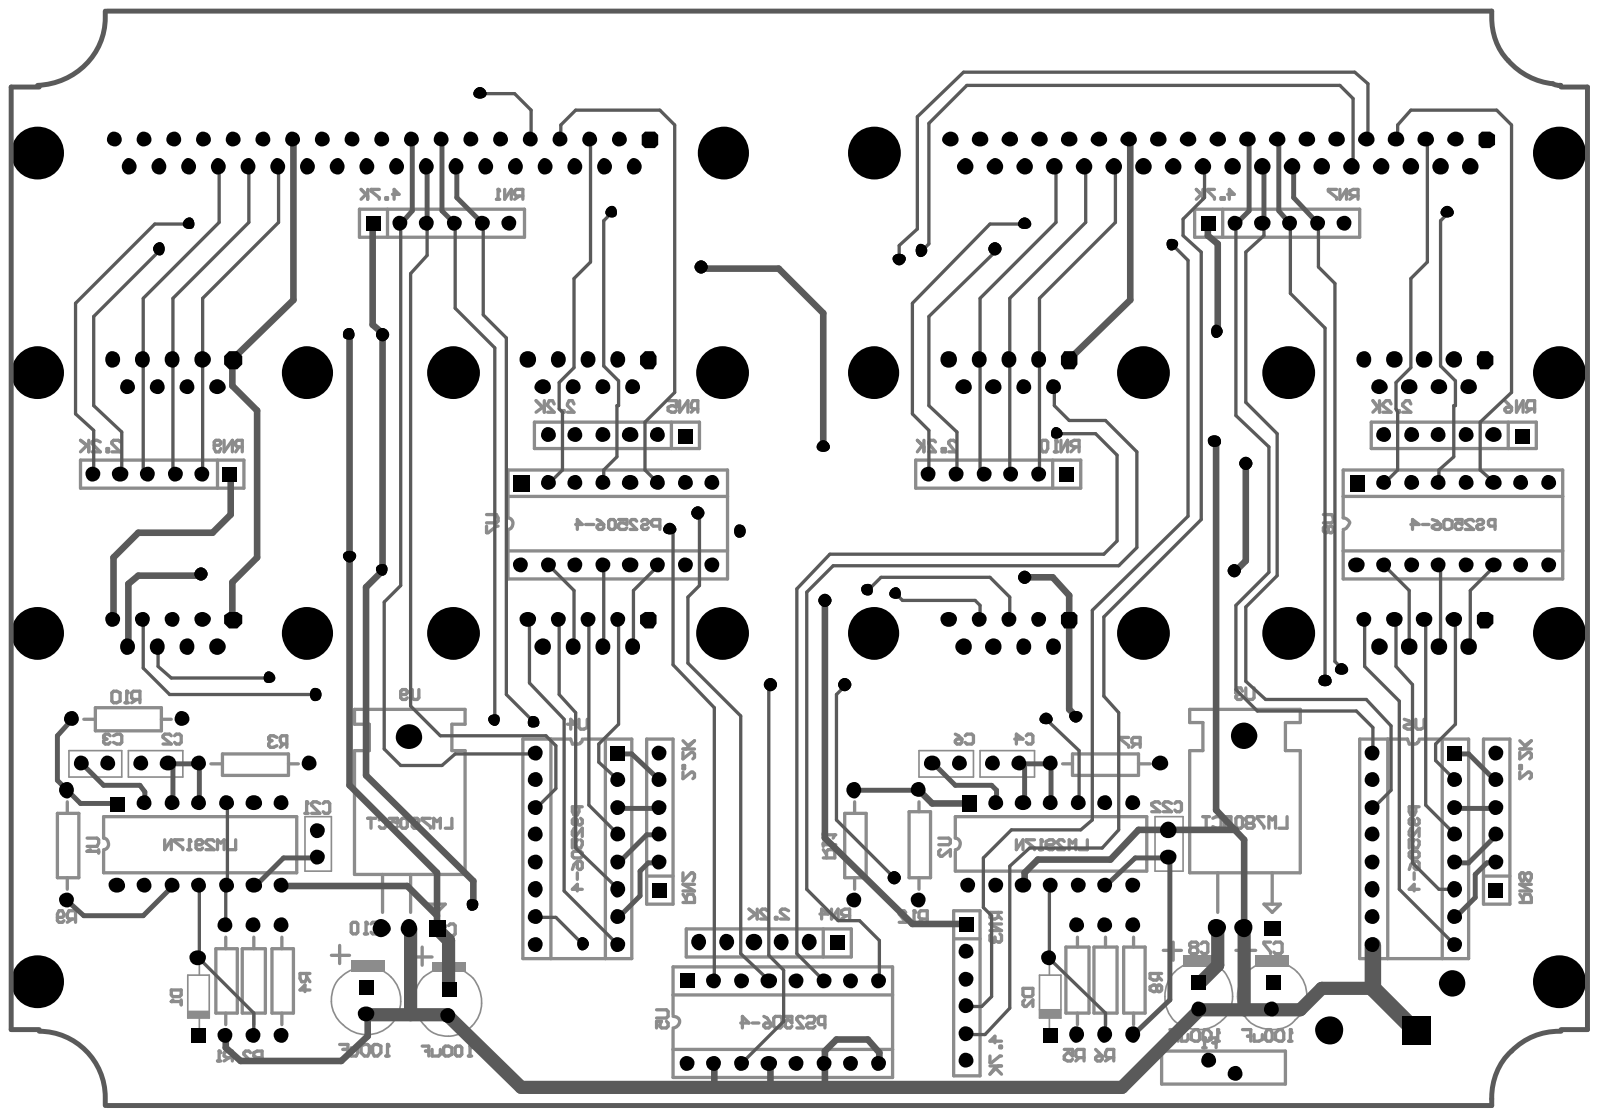
[picture p131: page 1]
