John-Nagle/Overbot/gc/parts/throttle/boardlayout/GIU_R1_TOP.pdf

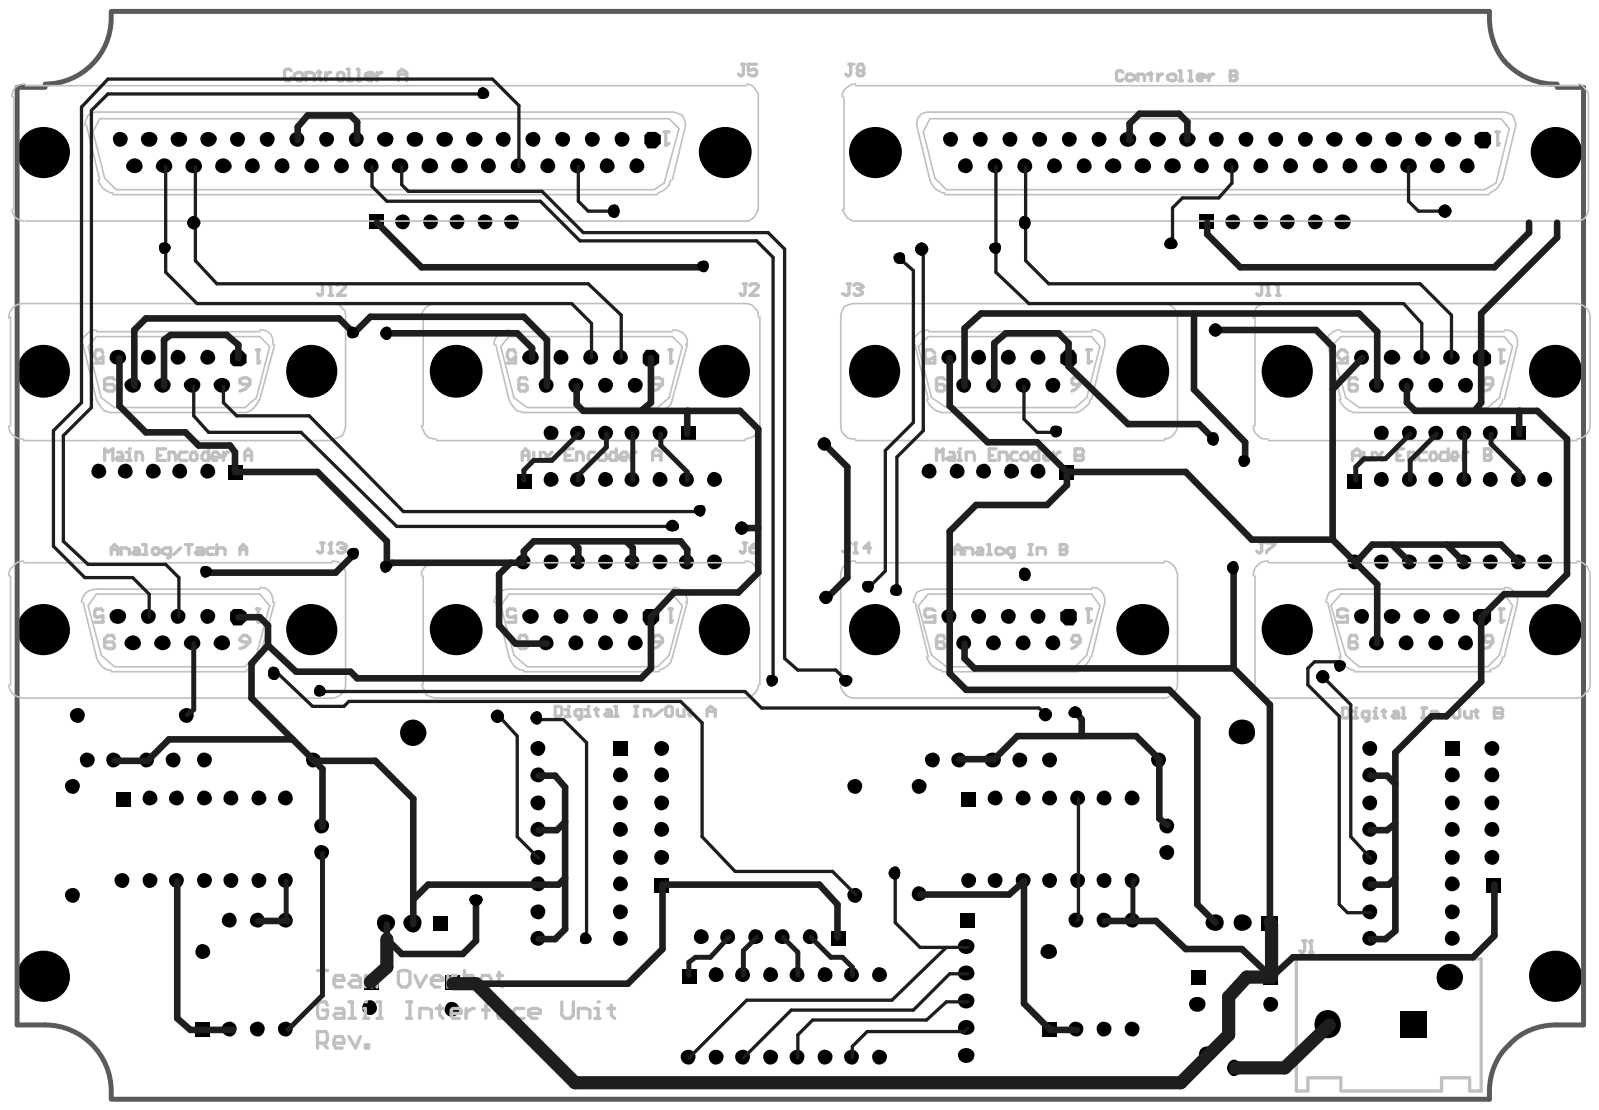
[picture p132: page 1]
