John-Nagle/Overbot/(list of files, drawings)

Other design files:
gc/parts/throttle/gcthrottle.pcb
