John-Nagle/Overbot/gc/src/qnx/support/manualdrive/src/base_lost_focus.c

/* Y o u r   D e s c r i p t i o n                       */
/*                            AppBuilder Photon Code Lib */
/*                                         Version 2.01  */

/* Standard headers */
#include <stdio.h>
#include <stdlib.h>
#include <unistd.h>
#include <string.h>

/* Local headers */
#include "ablibs.h"
#include "abimport.h"
#include "proto.h"


int
base_lost_focus( PtWidget_t *widget, ApInfo_t *apinfo, PtCallbackInfo_t *cbinfo )

	{

	/* eliminate 'unreferenced' warnings */
	widget = widget, apinfo = apinfo, cbinfo = cbinfo;

	return( Pt_CONTINUE );

	}
